tomyrese/DATN/KLTN_DeCuong_NguyenPhuQuy_LeMinhNgoc.pptx

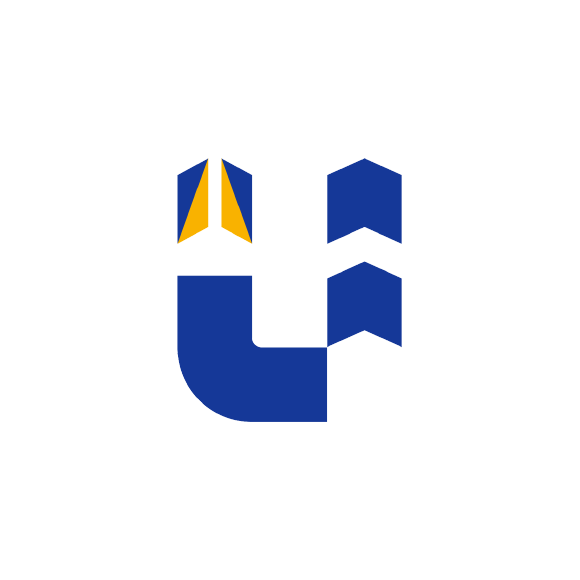
[picture p1: figure]
Nhận diện thương hiệu - Đại học Công nghiệp Thành phố Hồ Chí Minh - IUH

BẢO VỆ ĐỀ CƯƠNG

ĐỀ TÀI

THIẾT KẾ VÀ TRIỂN KHAI ROBOT TỰ HÀNH HỖ TRỢ GIAO NHẬN VÀ TƯƠNG TÁC KHÁCH HÀNG TẠI CÁC TRUNG TÂM THƯƠNG MẠI TRÊN NỀN TẢNG RASPBERRY PI

Giảng viên hướng dẫn: ThS. Lê Lý Quyên Quyên

Sinh viên thực hiện 1: Nguyễn Phú Quý MSSV: 22659651

Sinh viên thực hiện 2: Lê Minh Ngọc MSSV: 22652411

1/11

## Slide 2

TỔNG QUAN ĐỀ TÀI

ĐẶT VẤN ĐỀ & TÍNH CẤP THIẾT CỦA ĐỀ TÀI

BỐI CẢNH

Nhu cầu giao nhận

Mặt sàn rộng lớn

Hỗ trợ tìm đường

THÁCH THỨC

Tốn kém nhân lực

Nguy cơ nhầm lẫn

Hỗ trợ bị động

GIẢI PHÁP

Robot 4 bánh Mecanun

Bo mạch tích hợp

Điều khiển qua Web

Trợ lý AI

2/11

## Slide 3

TỔNG QUAN ĐỀ TÀI

MỤC TIÊU VÀ PHẠM VI NGHIÊN CỨU

MỤC TIÊU CỐT LÕI

Thiết kế phần cứng

Điều khiển tự hành

Hệ thống Web điều khiển

Trợ lý AI

Không gian hoạt động

PHẠM VI VÀ GIỚI HẠN

Tải trọng chuyên chở

Truyền thông không dây

Thời lượng Pin

3/11

## Slide 4

GIAO NHẬN HÀNG HÓA NỘI BỘ

KỊCH BẢN VẬN HÀNH & TƯƠNG TÁC TẠI TRUNG TÂM THƯƠNG MẠI

VẬN CHUYỂN

TẠO ĐƠN

NẠP HÀNG

NHẬN HÀNG

DI CHUYỂN

4/11

## Slide 5

HỖ TRỢ KHÁCH HÀNG & AI

KỊCH BẢN VẬN HÀNH & TƯƠNG TÁC TẠI TRUNG TÂM THƯƠNG MẠI

QUÉT MÃ QR TƯƠNG TÁC

HỎI ĐÁP THÔNG MINH

DẪN ĐƯỜNG TRỰC TIẾP

5/11

## Slide 6

PHẦN CỨNG HỆ THỐNG

THIẾT KẾ PHẦN CỨNG - CÁC LINH KIỆN CỐT LÕI

Raspberry Pi 4 Model B (8GB)
Cấu hình: CPU 4 nhân Cortex, 8GB RAM
Kết nối: Wi-Fi kép, CSI & 40 chân GPIO

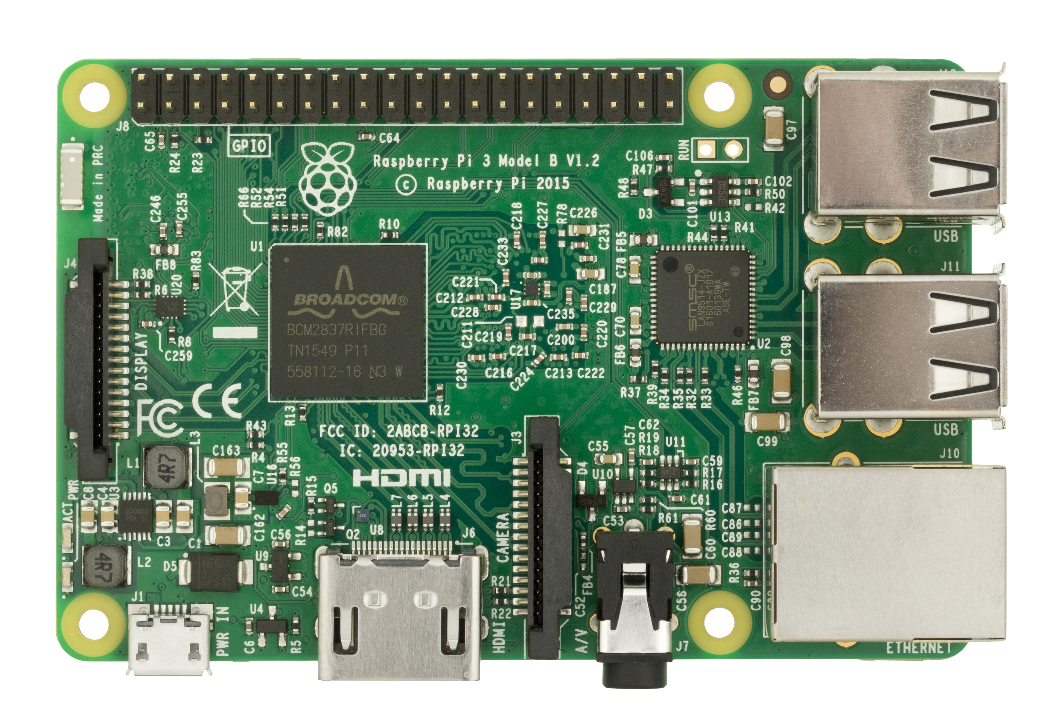
[picture p2: figure]

Driver Động Cơ TB6612FNG
Công nghệ: MOSFET kép tải 1.2A/kênh
Điều khiển: 4 kênh xung PWM điều tốc xe

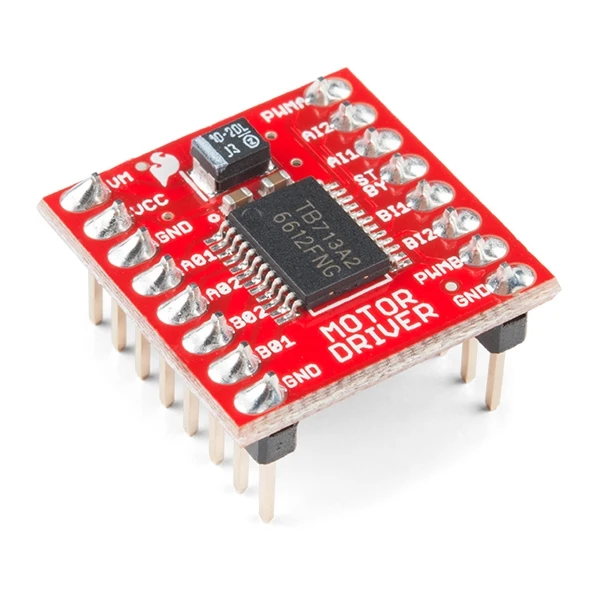
[picture p3: figure]

Khối Nguồn Năng Lượng
Pin Li-ion 12V: Cấp nguồn động lực xe
Hạ áp 5V-5A: Nuôi Pi 4 & tải, chung mass

Màn Hình OLED 1.3" I²C
Chuẩn I²C: Giao tiếp 2 dây gọn gàng
Hiển thị: Báo IP mạng, pin & mã QR

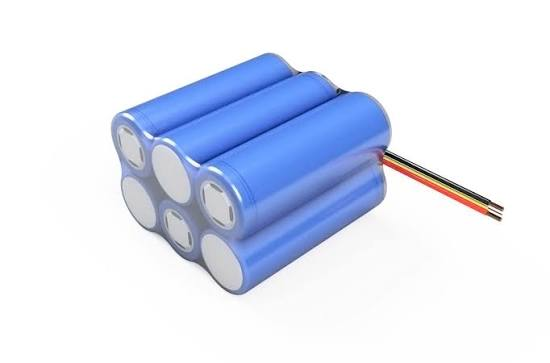
[picture p4: figure]
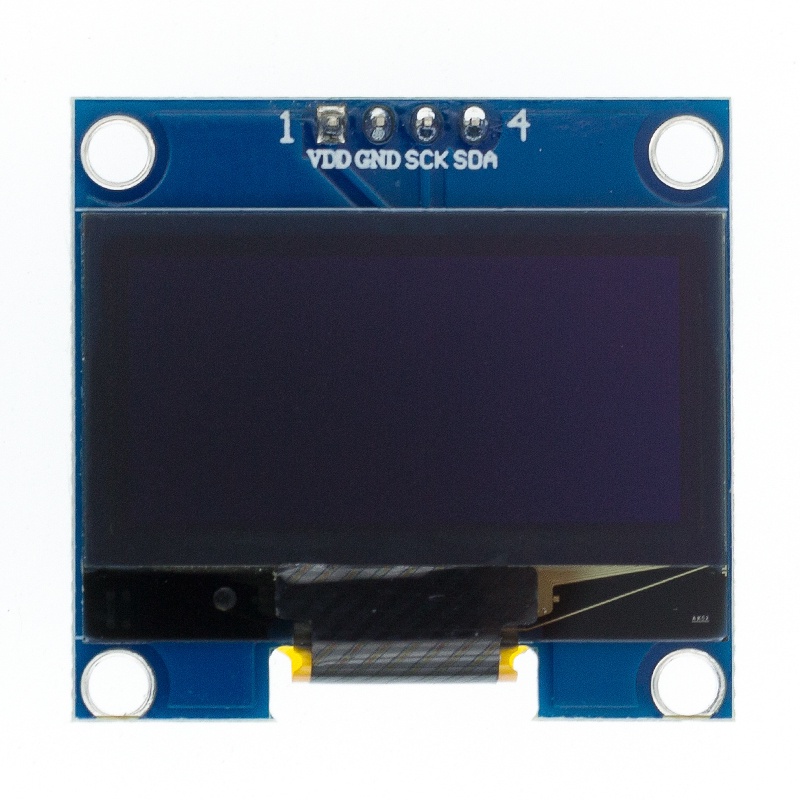
[picture p5: figure]

Cảm Biến Siêu Âm HC-SR04
Cự ly đo: 2cm - 400cm quét né vật cản
Phân áp 3.3V: Trở 1k/2k bảo vệ GPIO

Camera Quan Sát CSI OV5647
Ống kính 5MP: Góc nhìn 72.4° sắc nét
Chuẩn CSI: Cáp bẹ cắm trực tiếp Pi 4

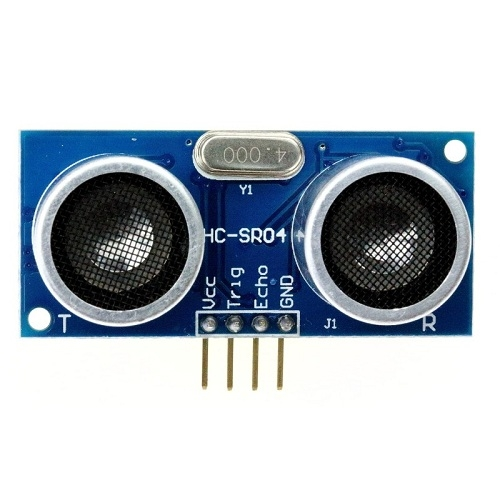
[picture p6: figure]
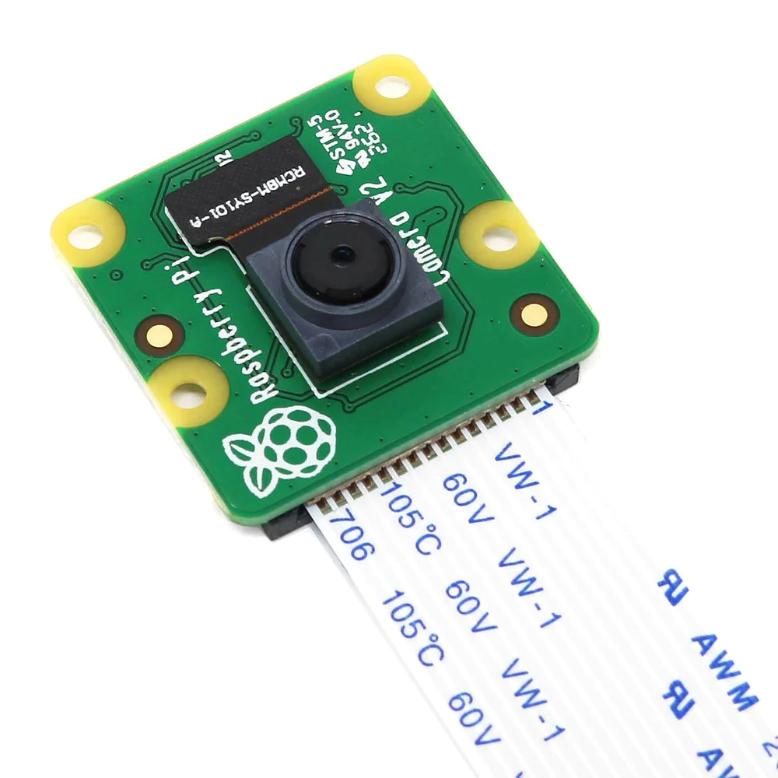
[picture p7: figure]

6/11

## Slide 7

KẾT QUẢ TRIỂN KHAI

KẾT QUẢ ĐÃ ĐẠT ĐƯỢC (ĐẾN THỜI ĐIỂM HIỆN TẠI)

1. PHẦN CỨNG MẠCH
Sơ đồ mạch điện: Hoàn thành bản vẽ KiCad.
Bo mạch 1 lớp: Đi dây toàn bộ mặt, tối ưu.
Bản vẽ chế tạo: Bộ PDF tỷ lệ 1:1 sẵn sàng gia công thực tế.

2. PHẦN MỀM ĐIỀU KHIỂN
Điều khiển động cơ: Lập trình chạy mượt các lệnh tiến, lùi, quay vòng, phanh dừng.
Chế độ mô phỏng: Chạy thử thuật toán trên máy tính mà không cần xe thật.
Kịch bản kiểm tra: Kiểm thử toàn diện chuyển động của xe.

3. HỆ THỐNG WEBSITE
Máy chủ điều khiển: Chạy trực tiếp trên Raspberry Pi 4, kết nối Wi-Fi.
Giao diện Web: Thiết kế hiện đại, điều khiển trên laptop và điện thoại.
Đầy đủ tính năng: Nút bấm lái xe, thanh trượt tốc độ và chế độ tự động kiểm tra.

7/11

## Slide 8

PHẦN CỨNG HỆ THỐNG

SƠ ĐỒ NGUYÊN LÝ TOÀN MẠCH

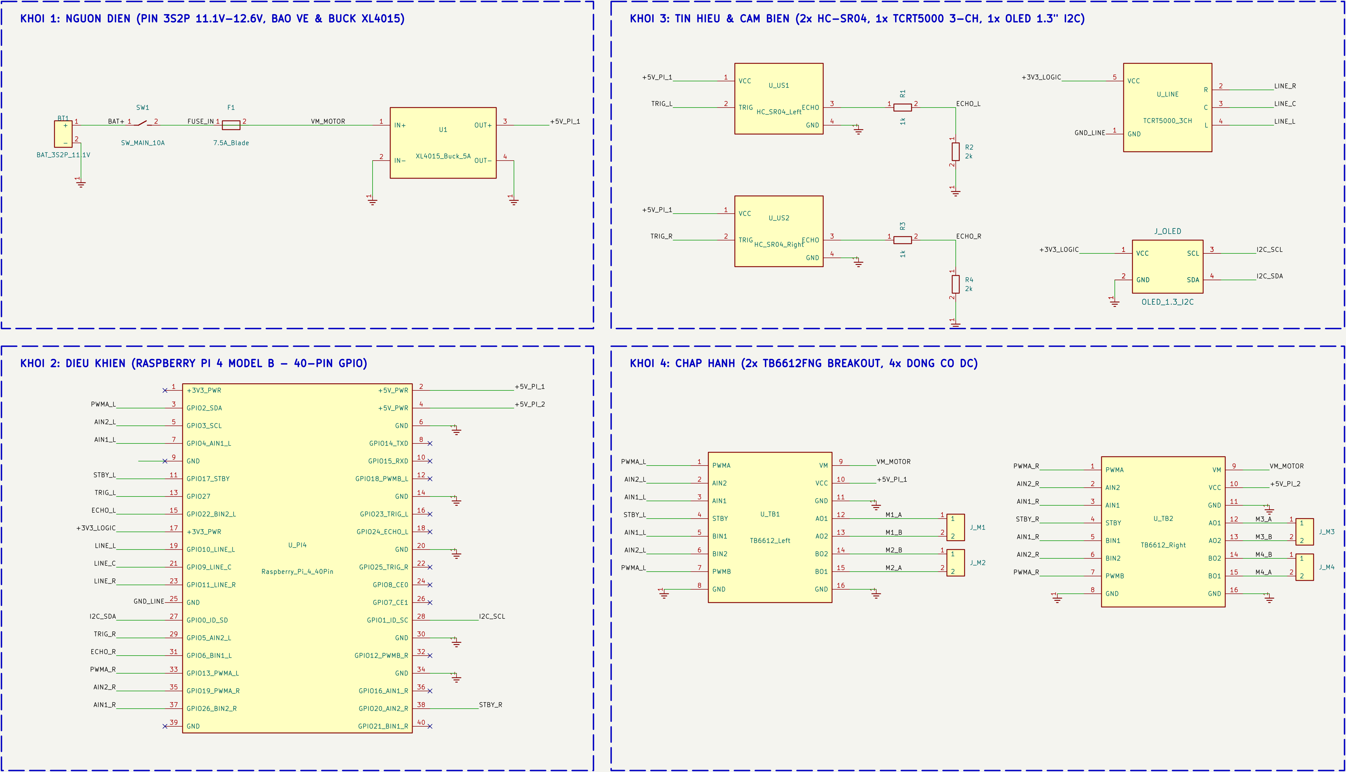
[picture p8: figure]

8/11

## Slide 9

PHẦN MỀM ĐIỀU KHIỂN

GIAO DIỆN WEB DASHBOARD

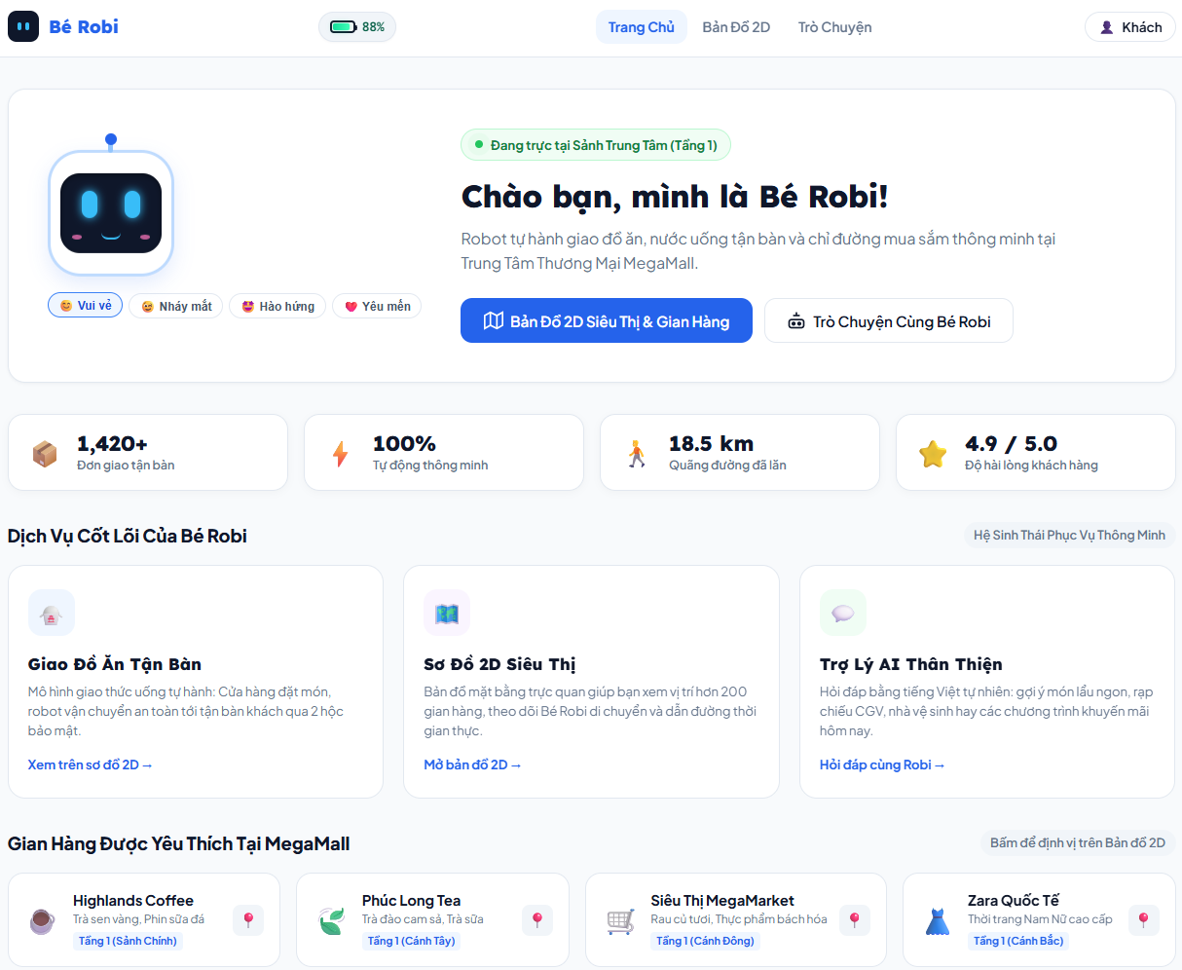
[picture p9: figure]
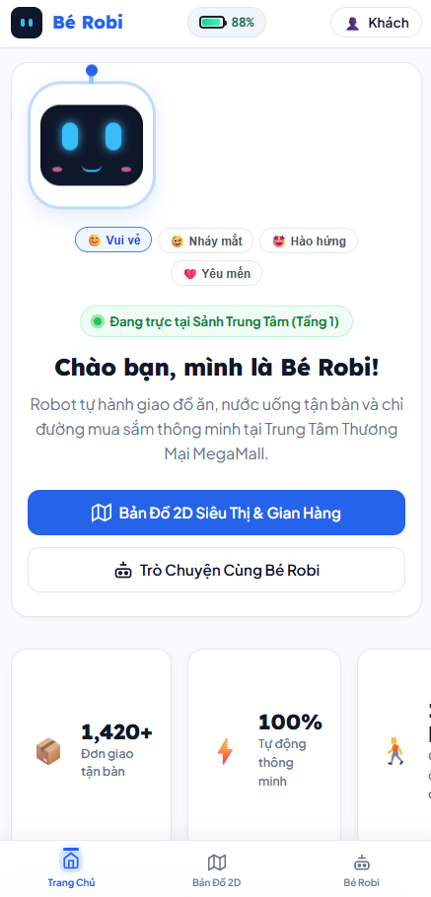
[picture p10: figure]

9/11

## Slide 10

LỘ TRÌNH TIẾP THEO

KẾT QUẢ THỰC HIỆN

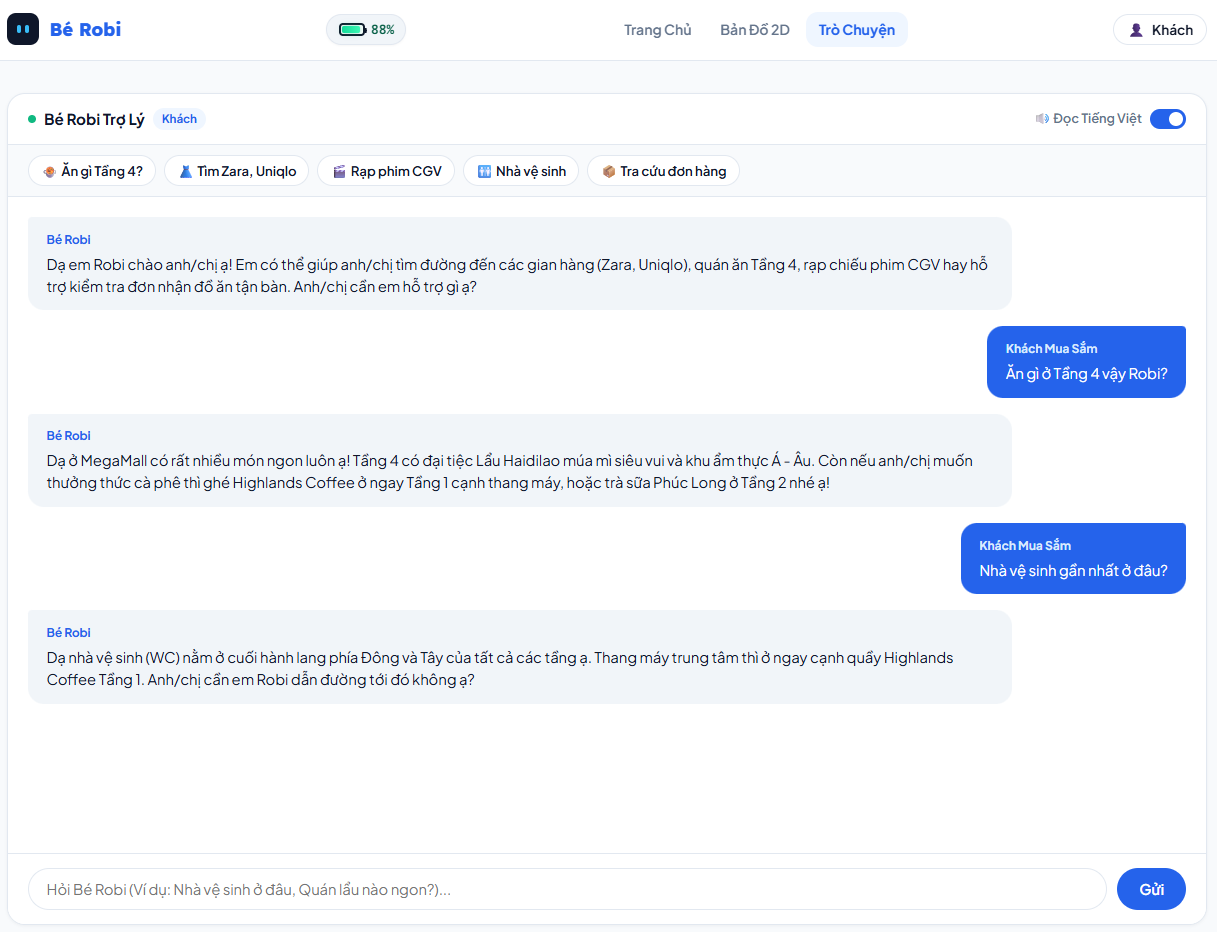
[picture p11: figure]
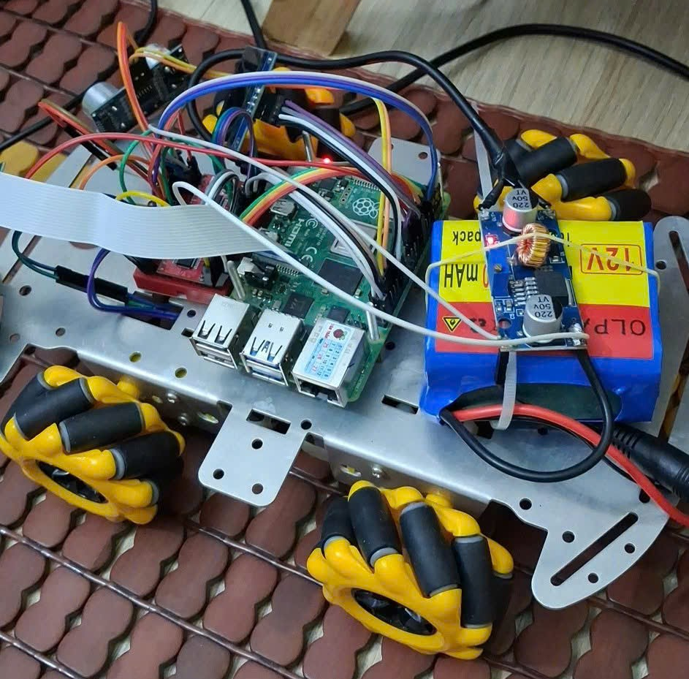
[picture p12: figure]

10/11

## Slide 11

CẢM ƠN HỘI ĐỒNG ĐÃ LẮNG NGHE!

Sinh viên 1: Nguyễn Phú Quý (MSSV: 22659651) • Sinh viên 2: Lê Minh Ngọc (MSSV: 22652411)

11/11
