tomyrese/DATN/extracted_imgs/block1_power_clean.png

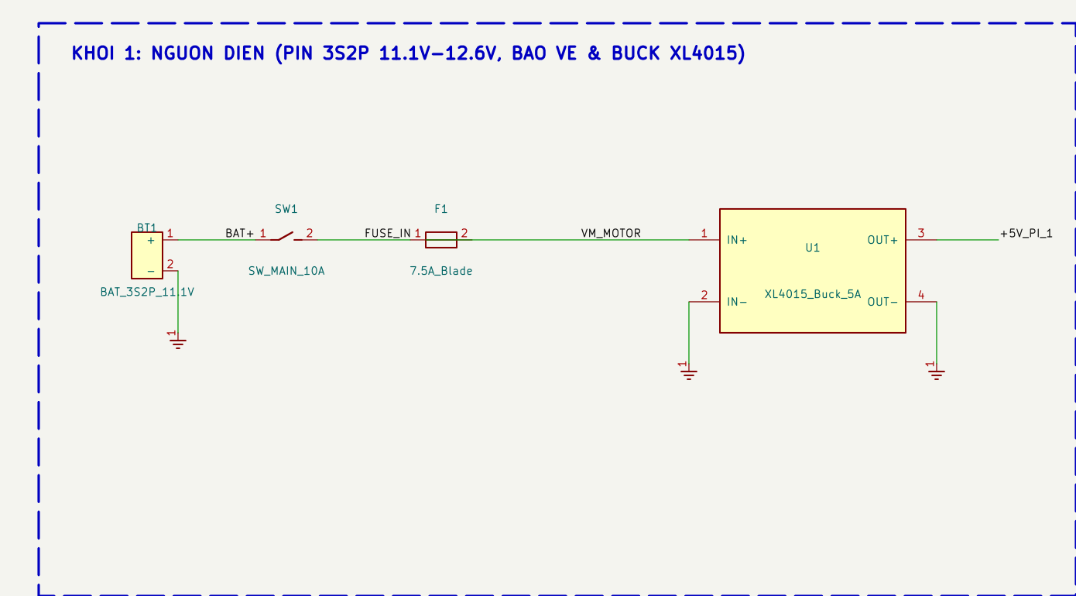
extracted_imgs/block1_power_clean.png
