tomyrese/DATN/extracted_imgs/block2_control_clean.png

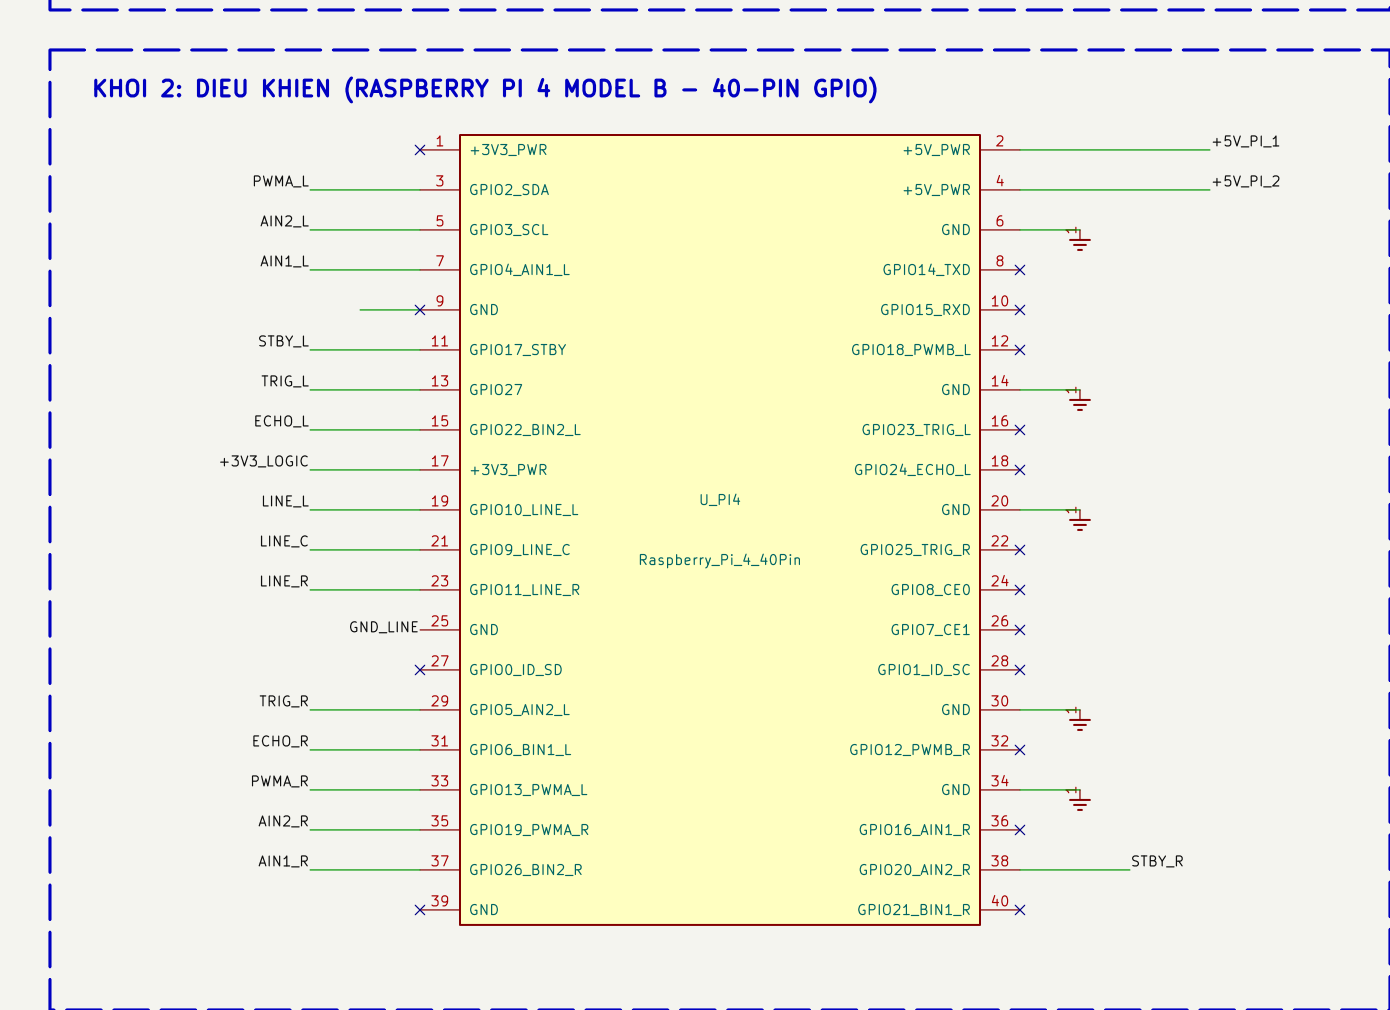
extracted_imgs/block2_control_clean.png
