tomyrese/DATN/extracted_imgs/block3_signal_clean.png

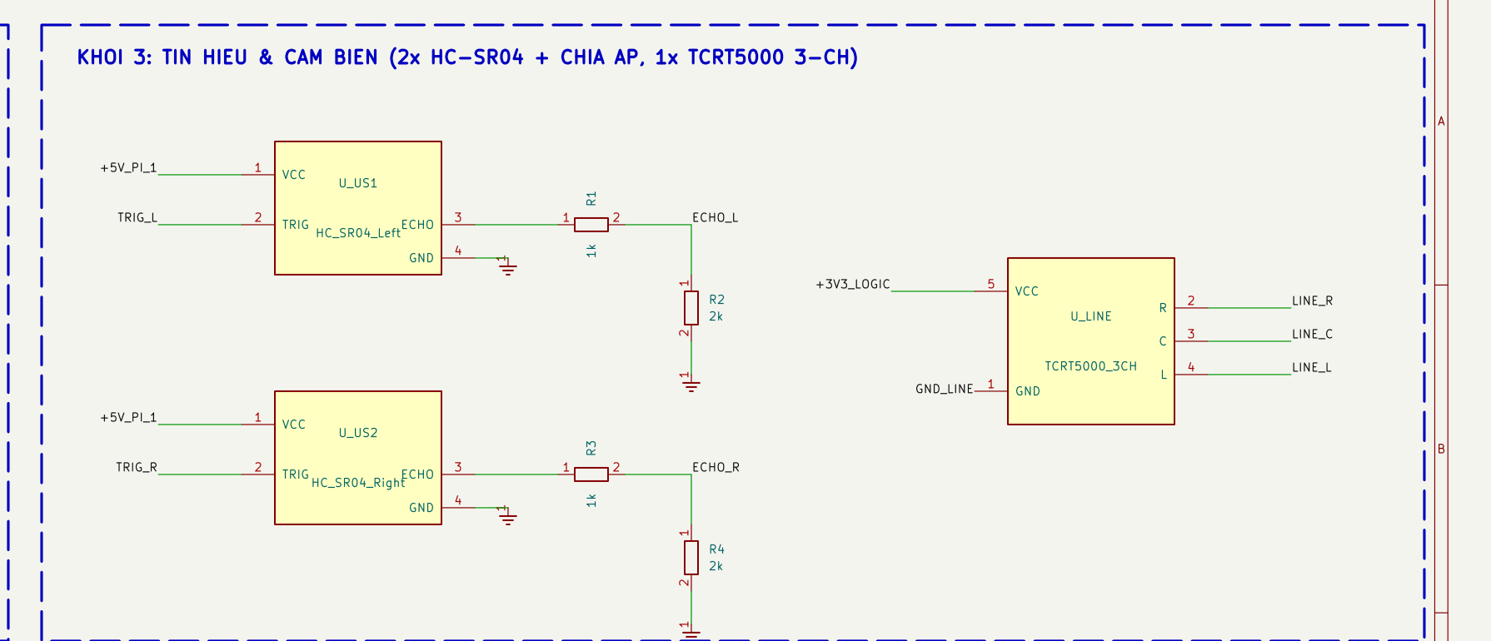
extracted_imgs/block3_signal_clean.png
