tomyrese/DATN/extracted_imgs/block4_actuators_clean.png

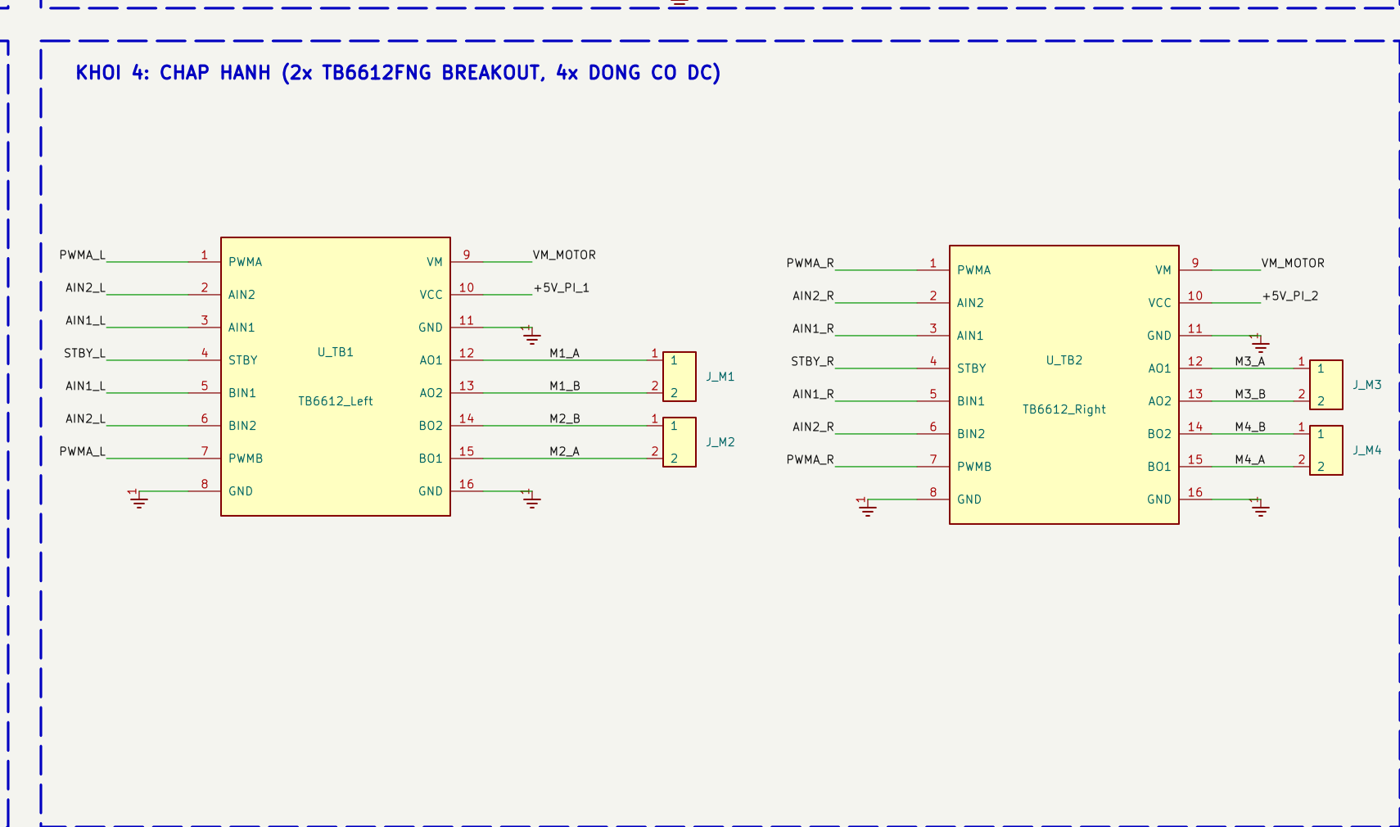
extracted_imgs/block4_actuators_clean.png
