tomyrese/DATN/extracted_imgs/block_diagrams/block_diagram_slide9_power.png

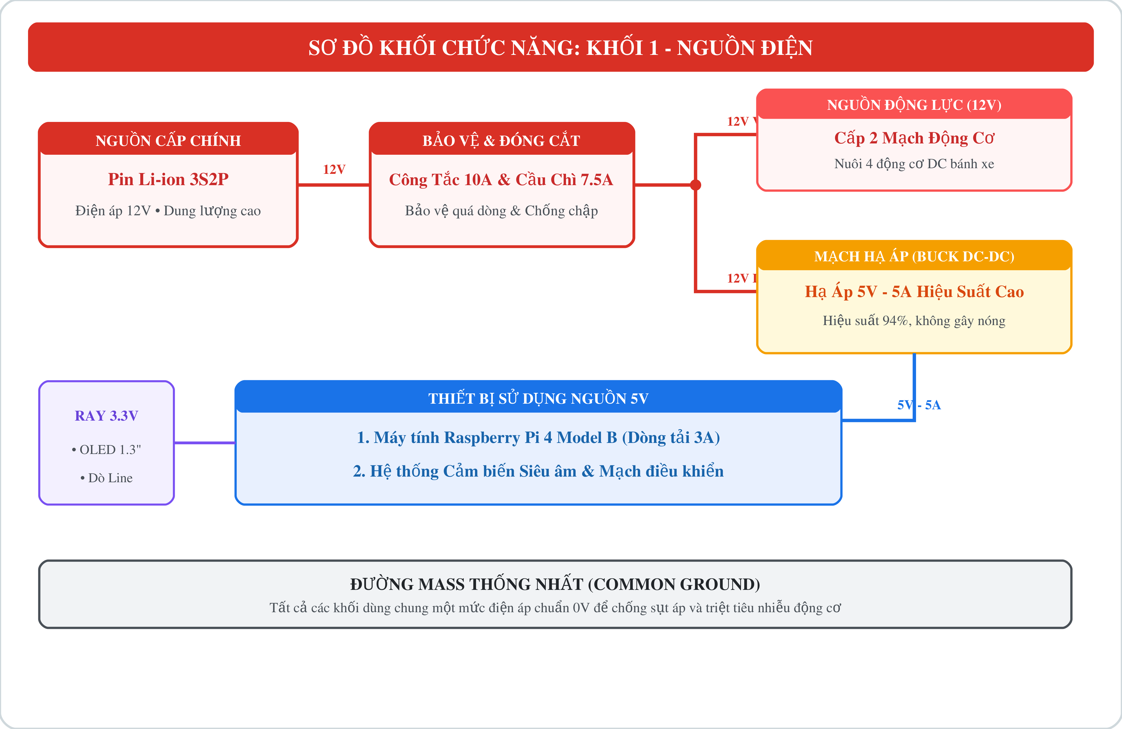
extracted_imgs/block_diagrams/block_diagram_slide9_power.png
