tomyrese/DATN/extracted_imgs/block_diagrams/block_diagram_slide10_control.png

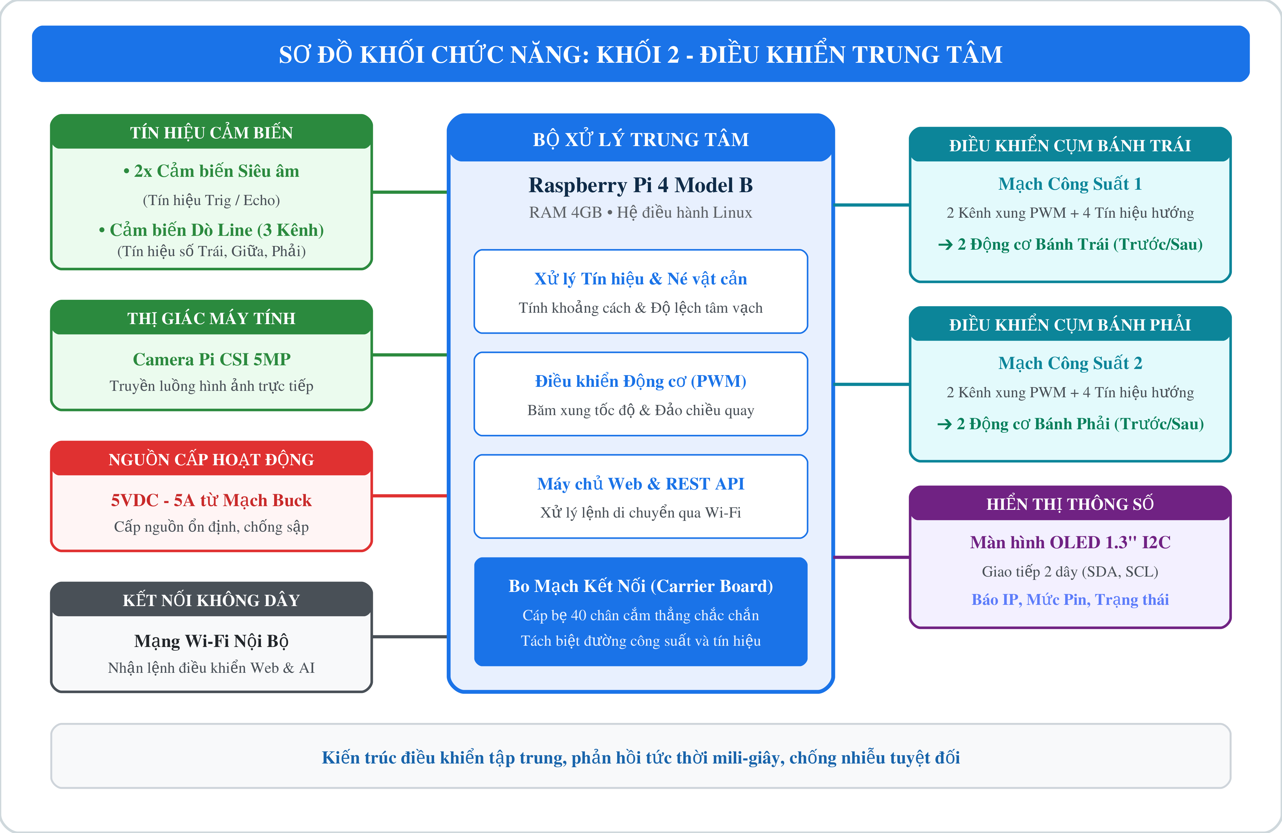
extracted_imgs/block_diagrams/block_diagram_slide10_control.png
