tomyrese/DATN/extracted_imgs/block_diagrams/block_diagram_slide11_sensor.png

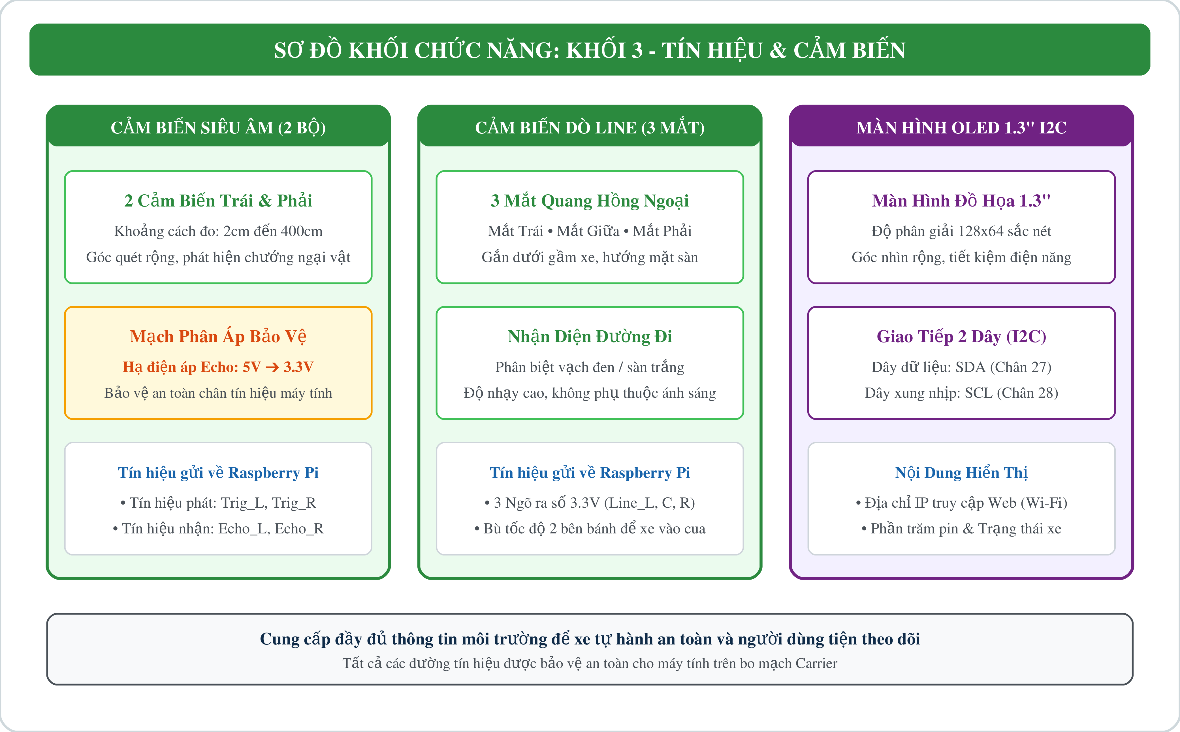
extracted_imgs/block_diagrams/block_diagram_slide11_sensor.png
