tomyrese/DATN/extracted_imgs/block_diagrams/block_diagram_slide12_motor.png

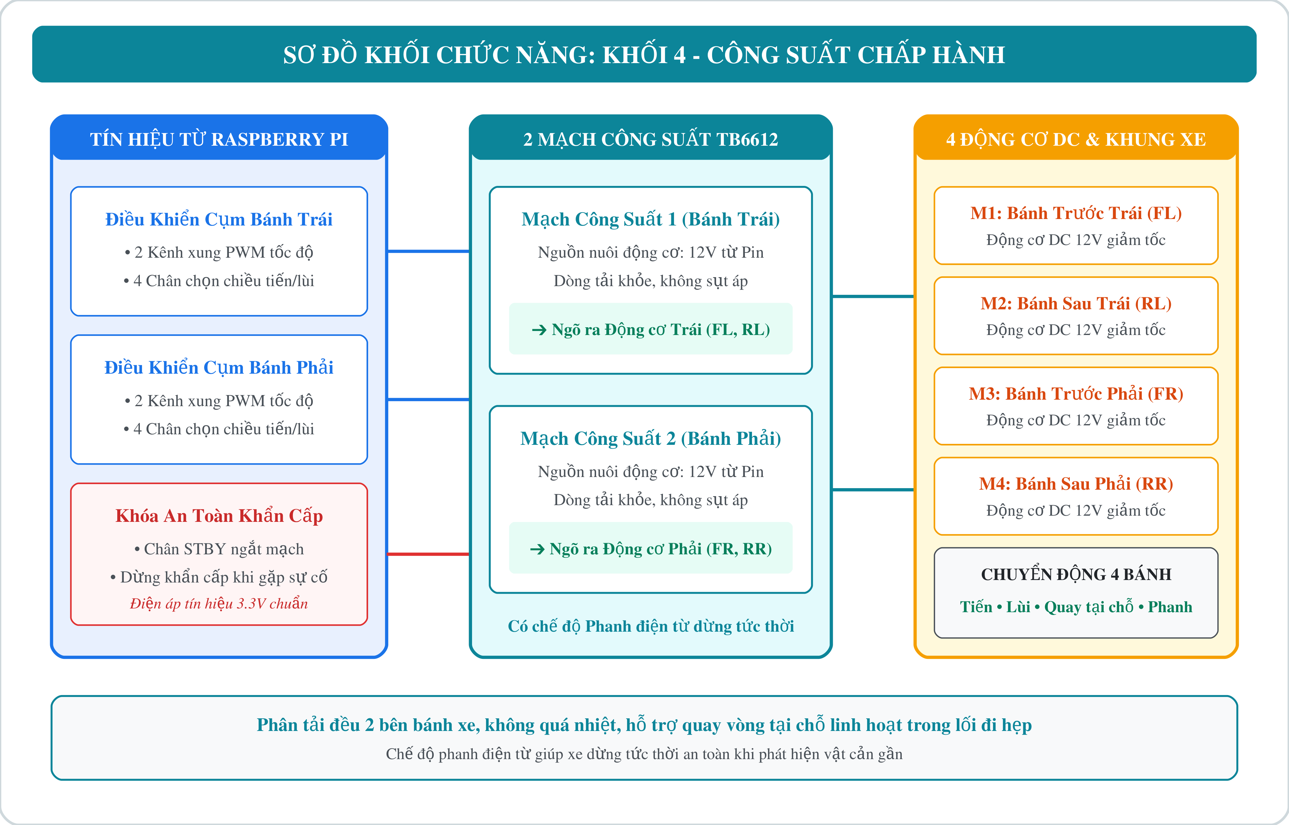
extracted_imgs/block_diagrams/block_diagram_slide12_motor.png
