tomyrese/DATN/extracted_imgs/flowcharts/flowchart_system_main.png

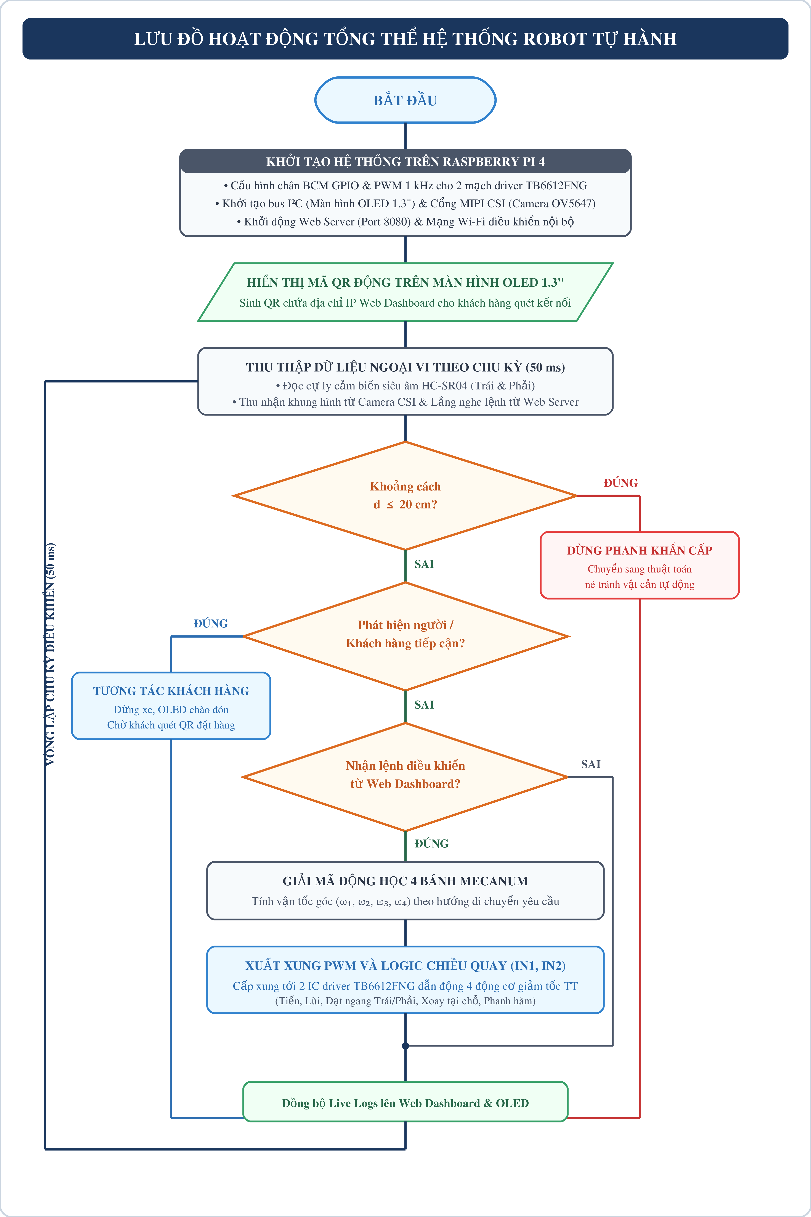
extracted_imgs/flowcharts/flowchart_system_main.png
