tomyrese/DATN/extracted_imgs/pcb_oled_zoom.png

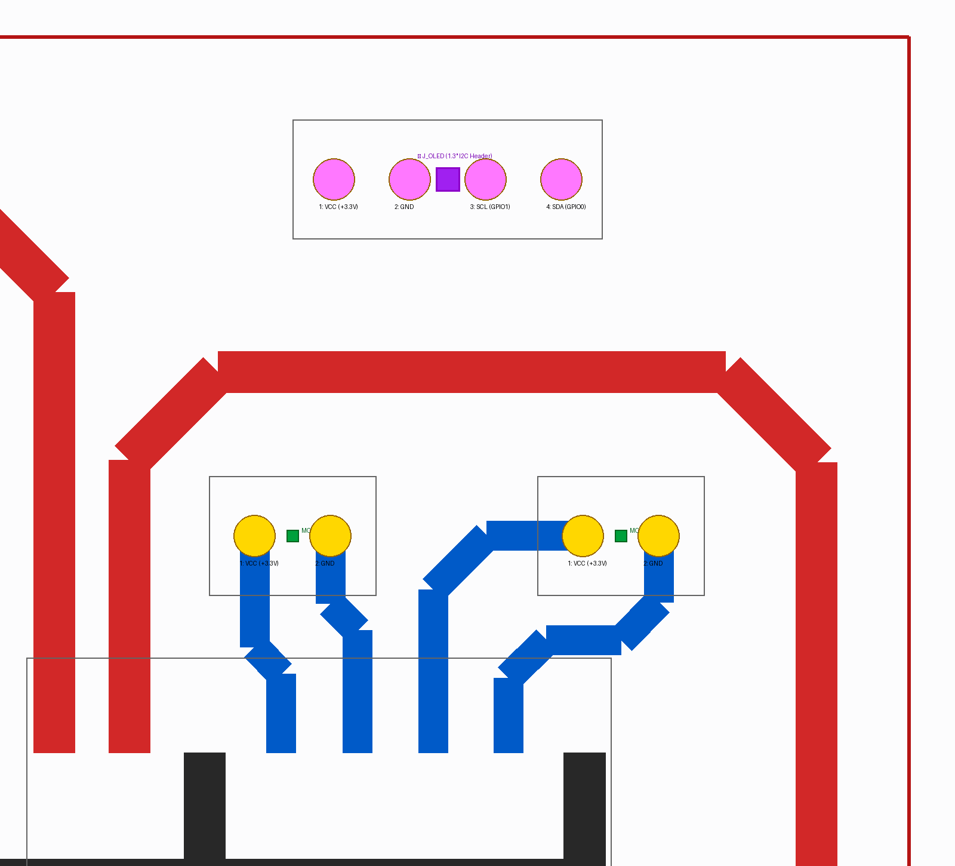
extracted_imgs/pcb_oled_zoom.png
