tomyrese/DATN/extracted_imgs/pcb_with_oled_visual.png

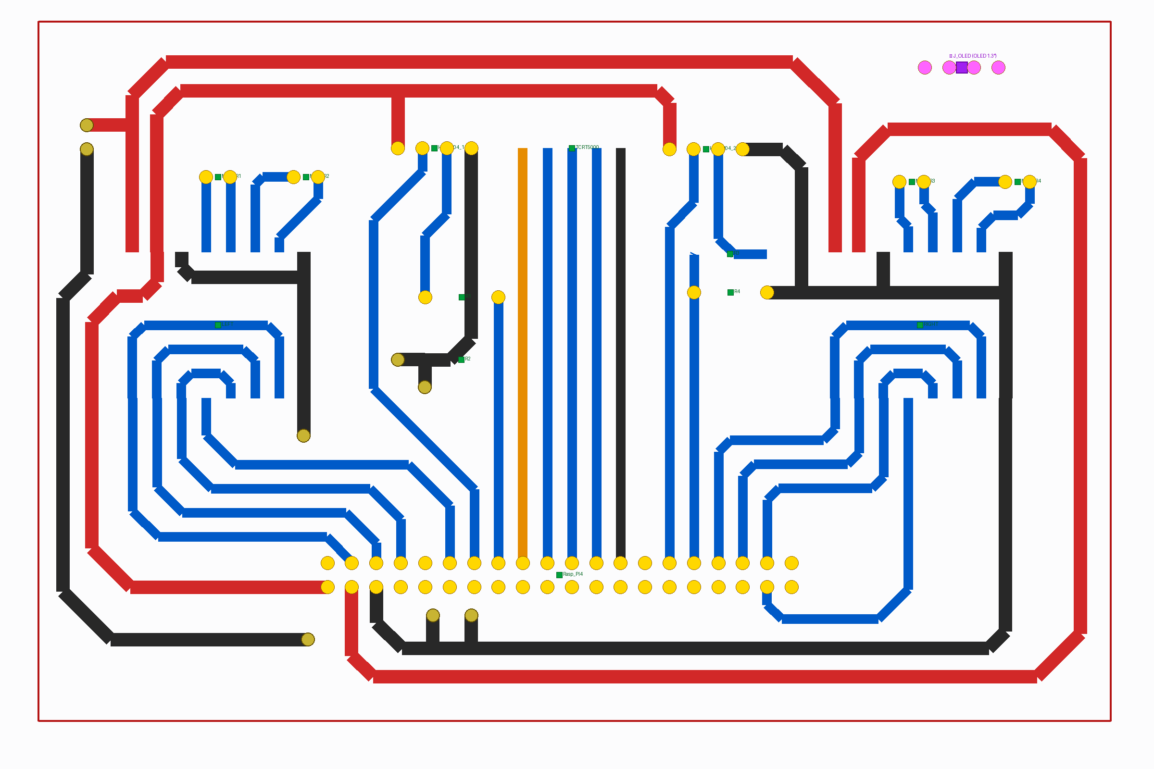
extracted_imgs/pcb_with_oled_visual.png
