tomyrese/DATN/extracted_imgs/pcb_zoom_completed.png

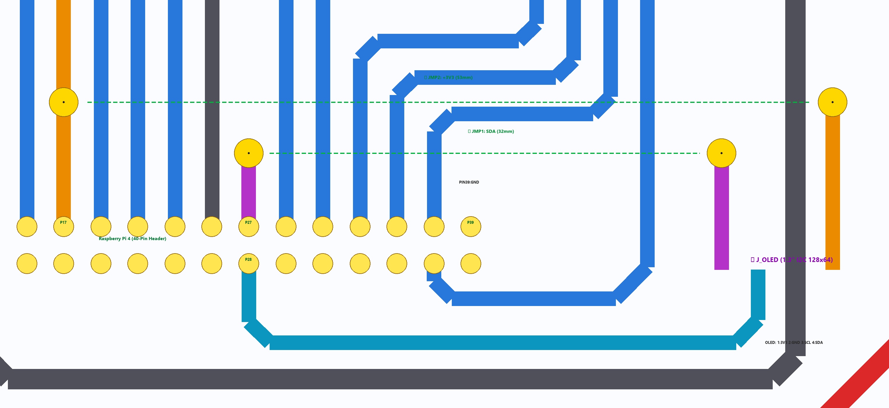
extracted_imgs/pcb_zoom_completed.png
