tomyrese/DATN/extracted_imgs/pptx_rendered_slides/Slide1.JPG

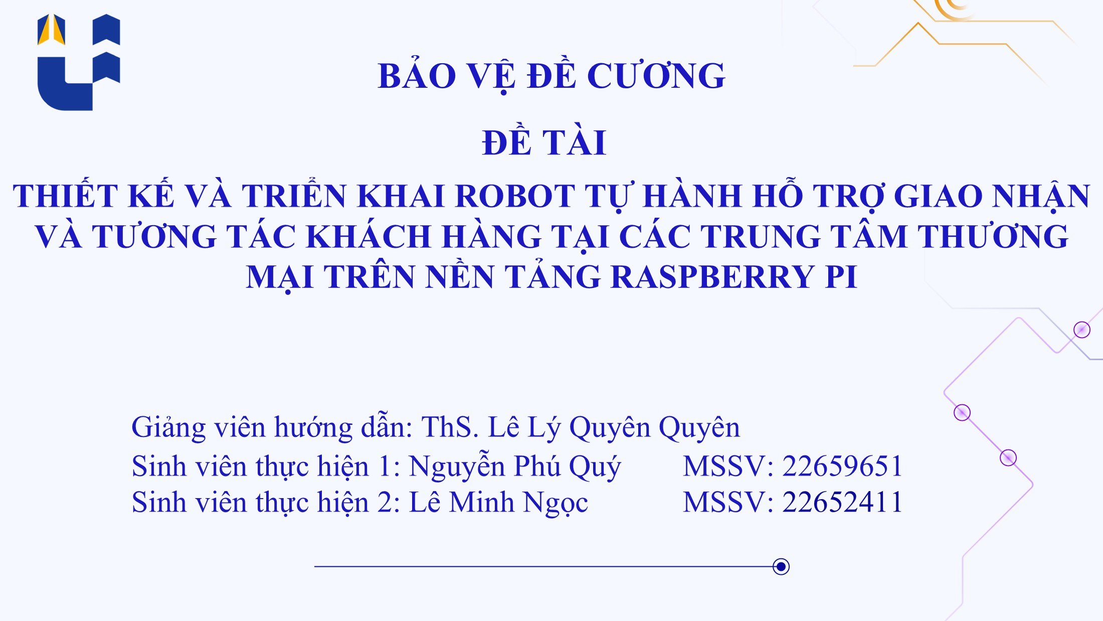
extracted_imgs/pptx_rendered_slides/Slide1.JPG
