tomyrese/DATN/extracted_imgs/pptx_rendered_slides/Slide2.JPG

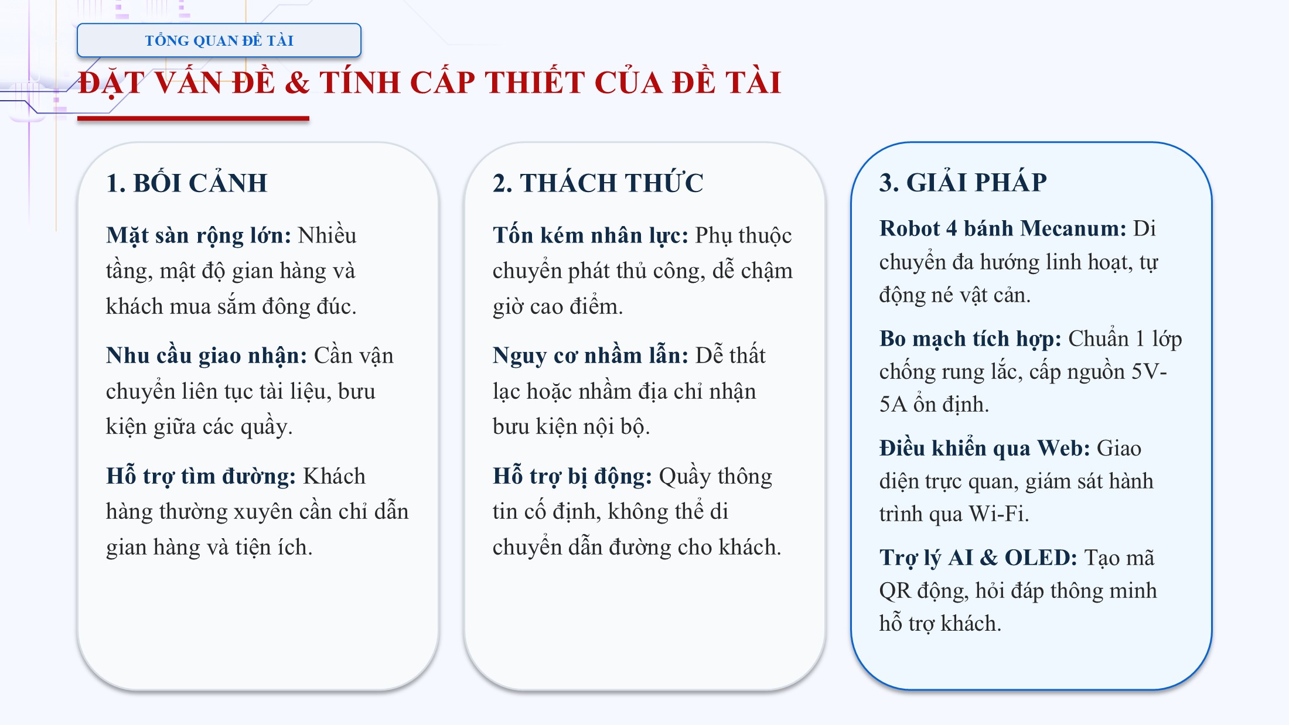
extracted_imgs/pptx_rendered_slides/Slide2.JPG
