tomyrese/DATN/extracted_imgs/pptx_rendered_slides/Slide3.JPG

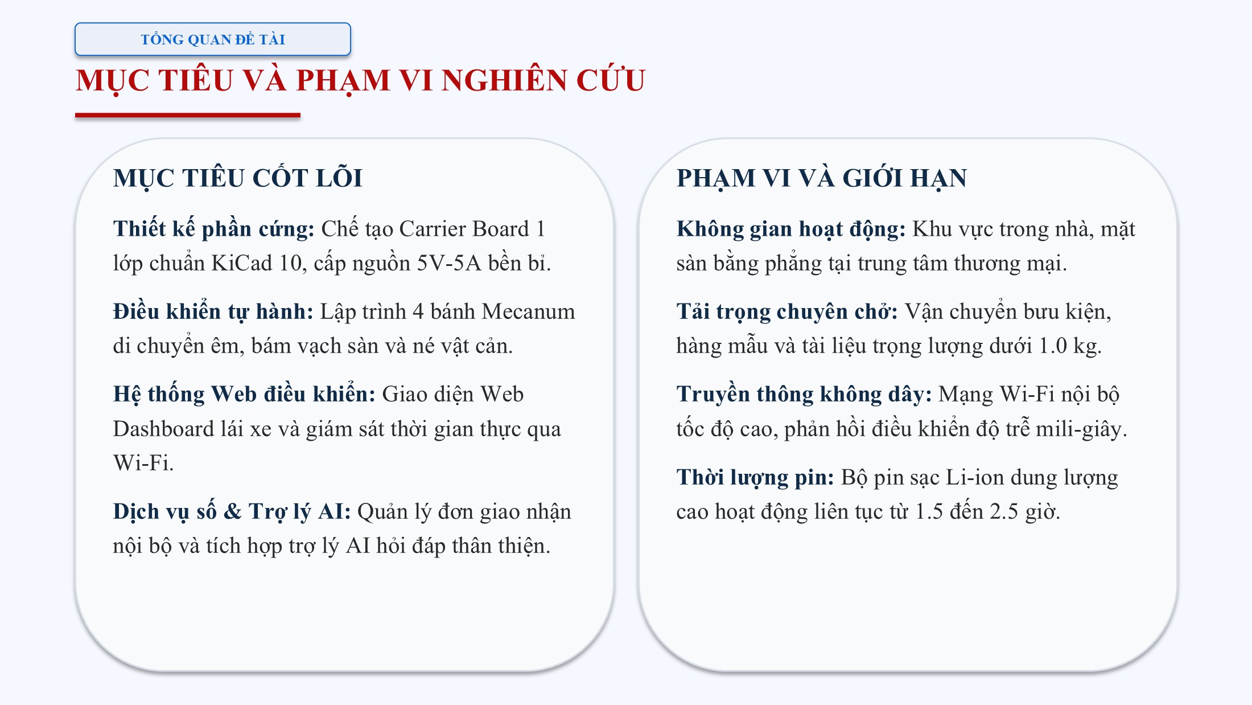
extracted_imgs/pptx_rendered_slides/Slide3.JPG
