tomyrese/DATN/extracted_imgs/pptx_rendered_slides/Slide4.JPG

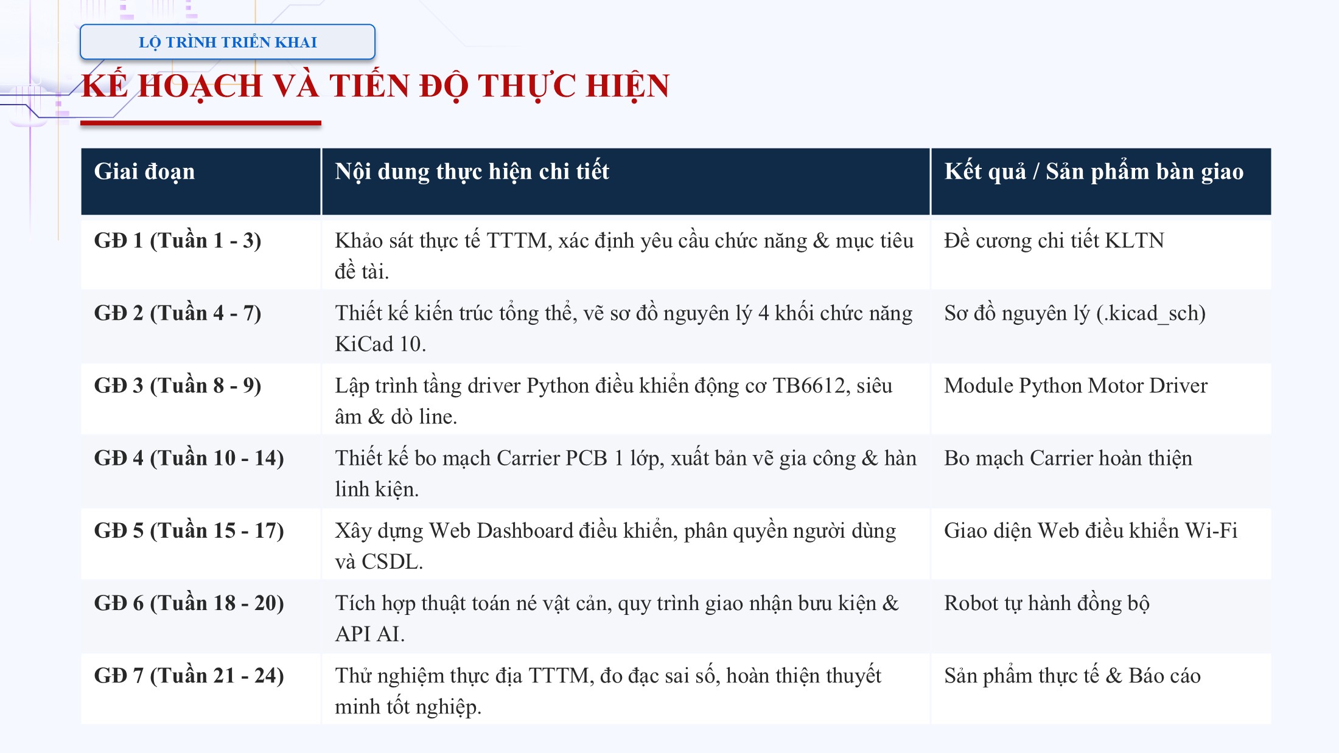
extracted_imgs/pptx_rendered_slides/Slide4.JPG
