tomyrese/DATN/extracted_imgs/pptx_rendered_slides/Slide5.JPG

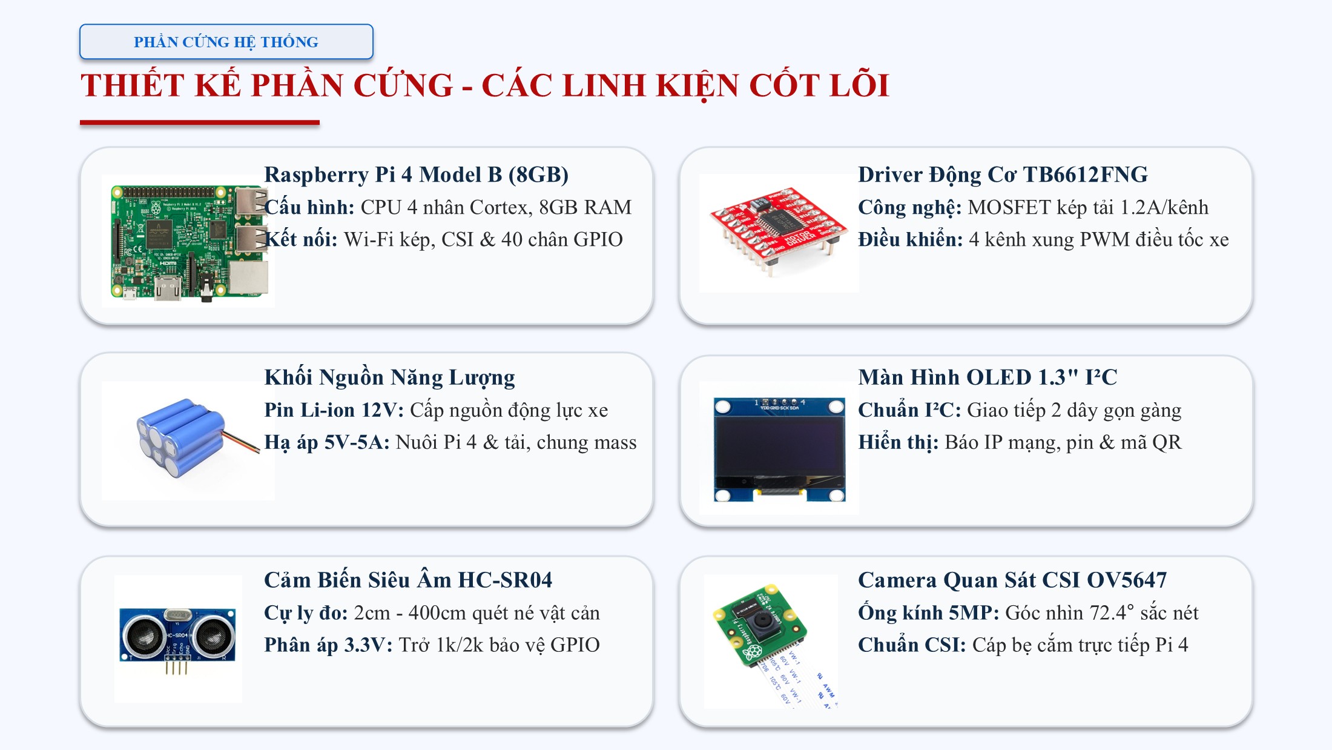
extracted_imgs/pptx_rendered_slides/Slide5.JPG
