tomyrese/DATN/extracted_imgs/pptx_rendered_slides/Slide6.JPG

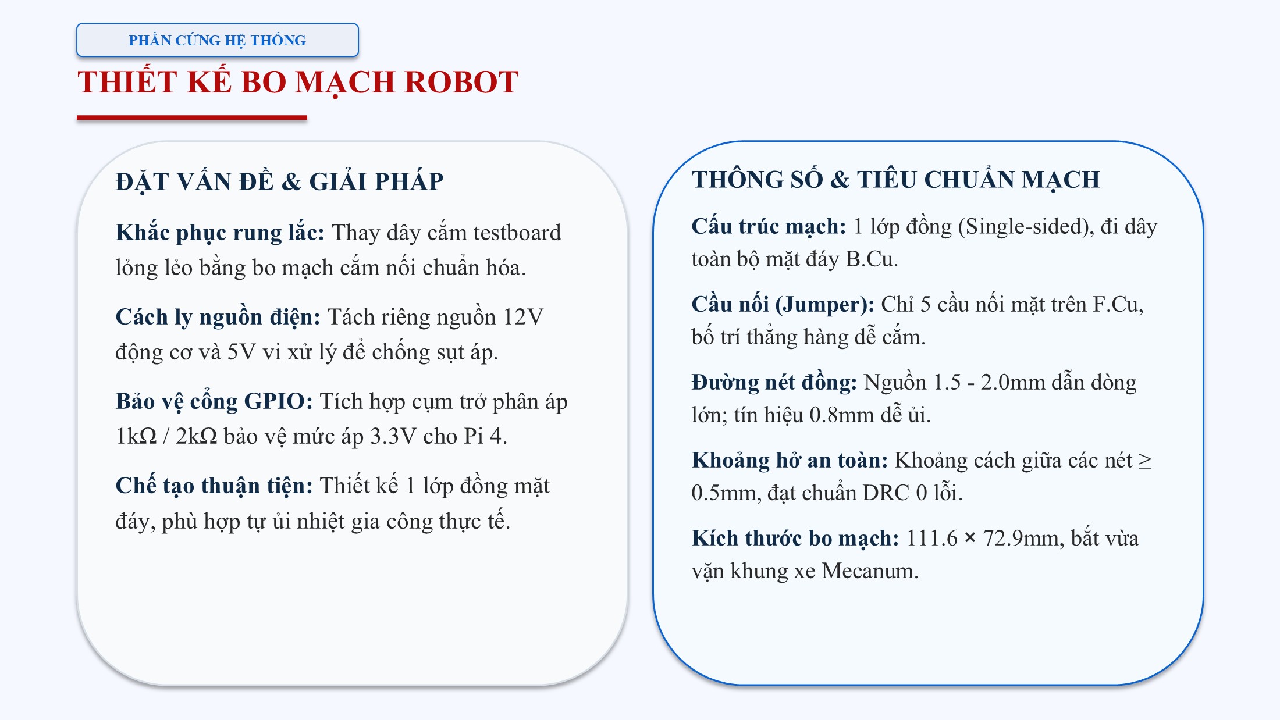
extracted_imgs/pptx_rendered_slides/Slide6.JPG
