tomyrese/DATN/extracted_imgs/pptx_rendered_slides/Slide7.JPG

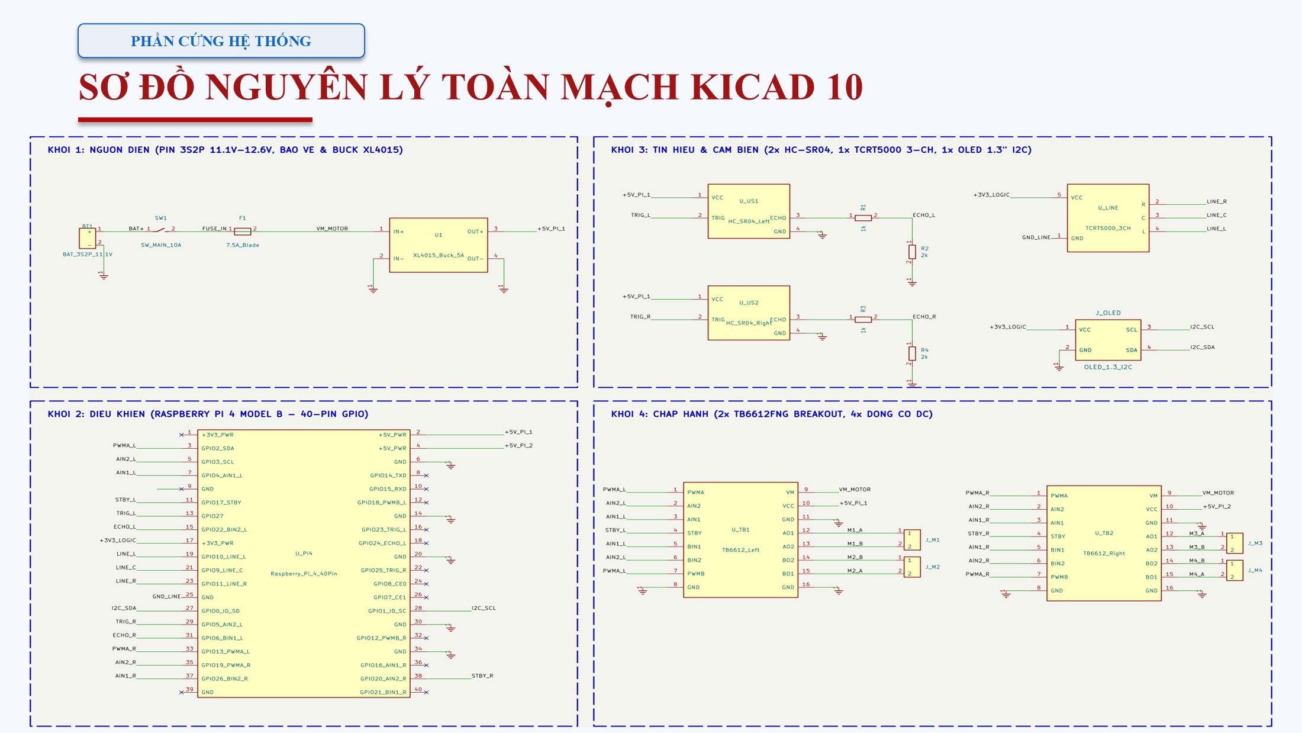
extracted_imgs/pptx_rendered_slides/Slide7.JPG
