tomyrese/DATN/extracted_imgs/pptx_rendered_slides/Slide8.JPG

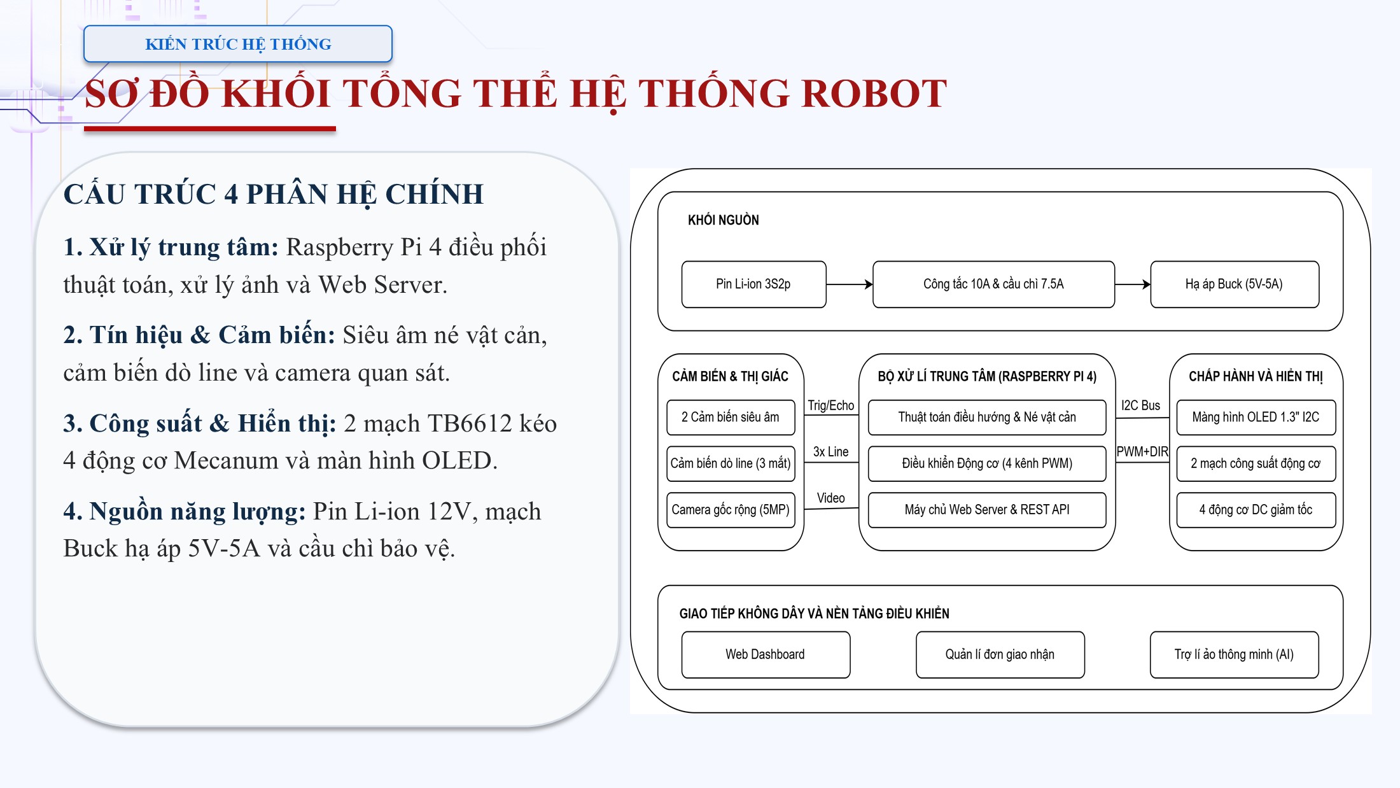
extracted_imgs/pptx_rendered_slides/Slide8.JPG
