tomyrese/DATN/extracted_imgs/pptx_rendered_slides/Slide9.JPG

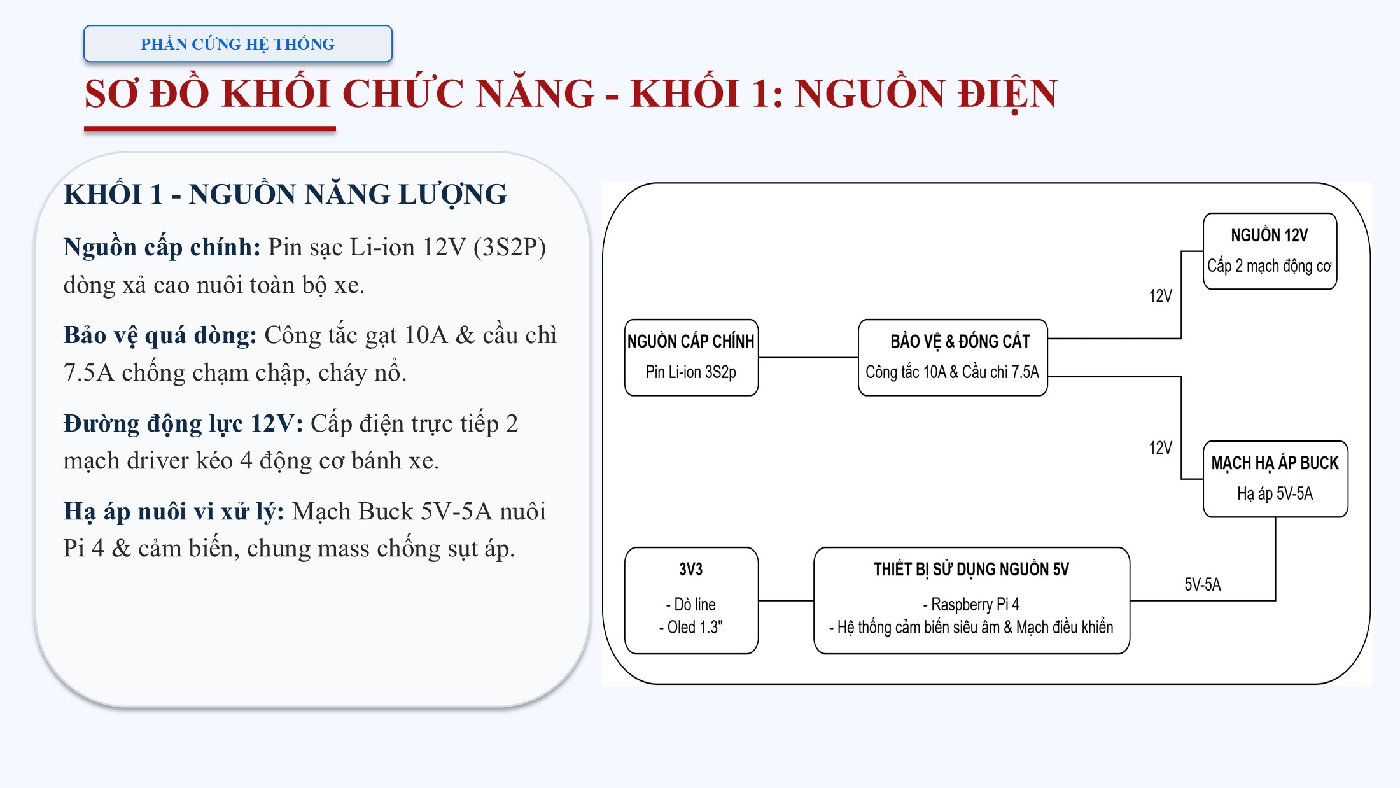
extracted_imgs/pptx_rendered_slides/Slide9.JPG
