tomyrese/DATN/extracted_imgs/pptx_rendered_slides/Slide10.JPG

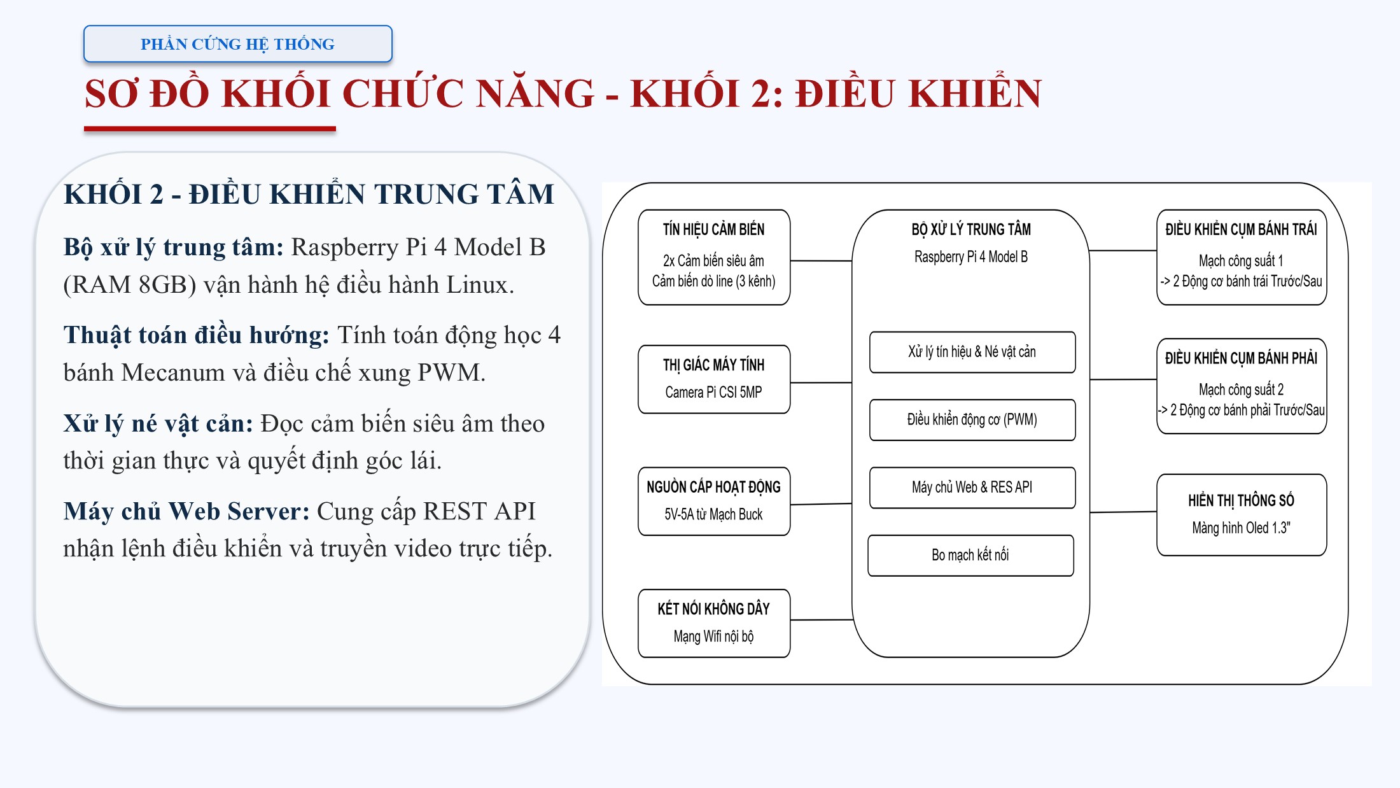
extracted_imgs/pptx_rendered_slides/Slide10.JPG
