tomyrese/DATN/extracted_imgs/pptx_rendered_slides/Slide11.JPG

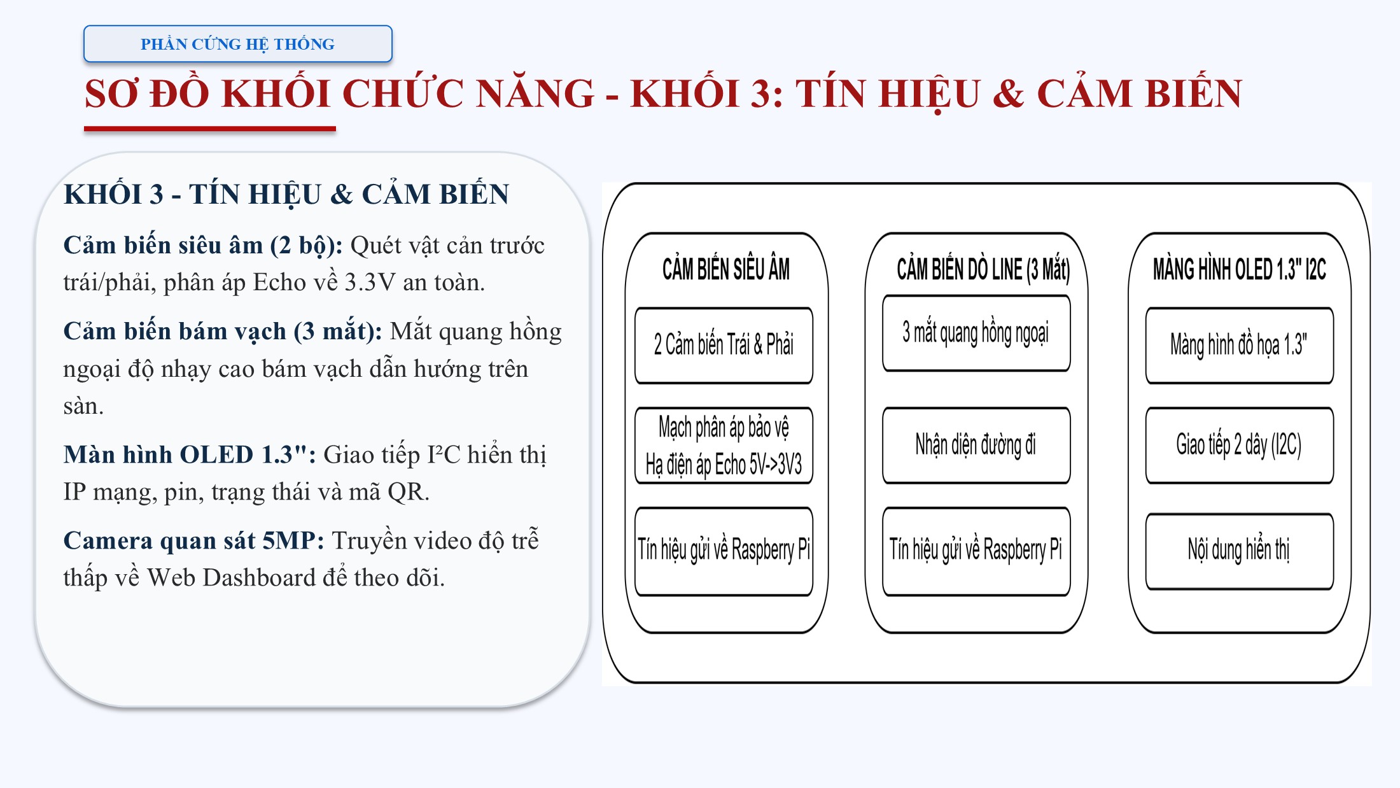
extracted_imgs/pptx_rendered_slides/Slide11.JPG
