tomyrese/DATN/extracted_imgs/pptx_rendered_slides/Slide12.JPG

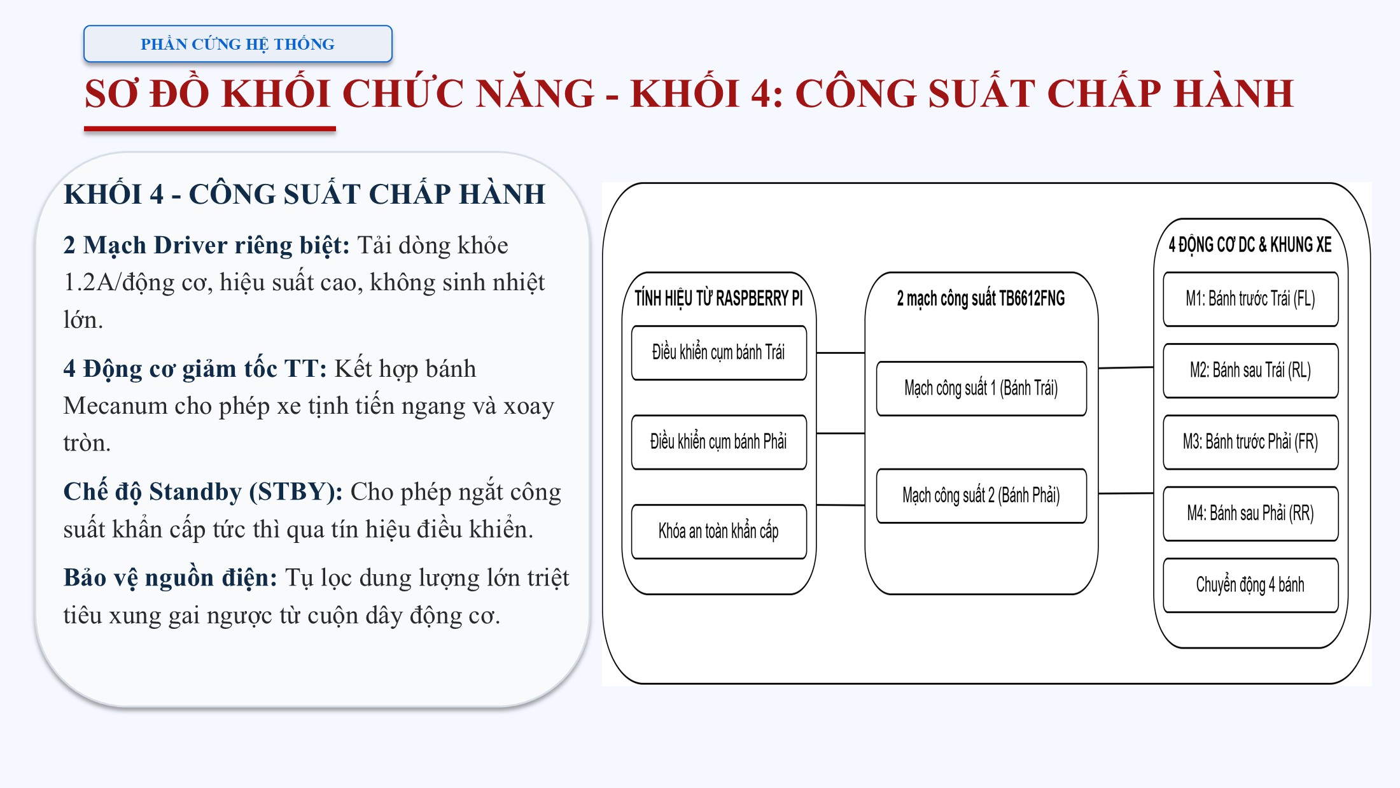
extracted_imgs/pptx_rendered_slides/Slide12.JPG
