tomyrese/DATN/extracted_imgs/pptx_rendered_slides/Slide13.JPG

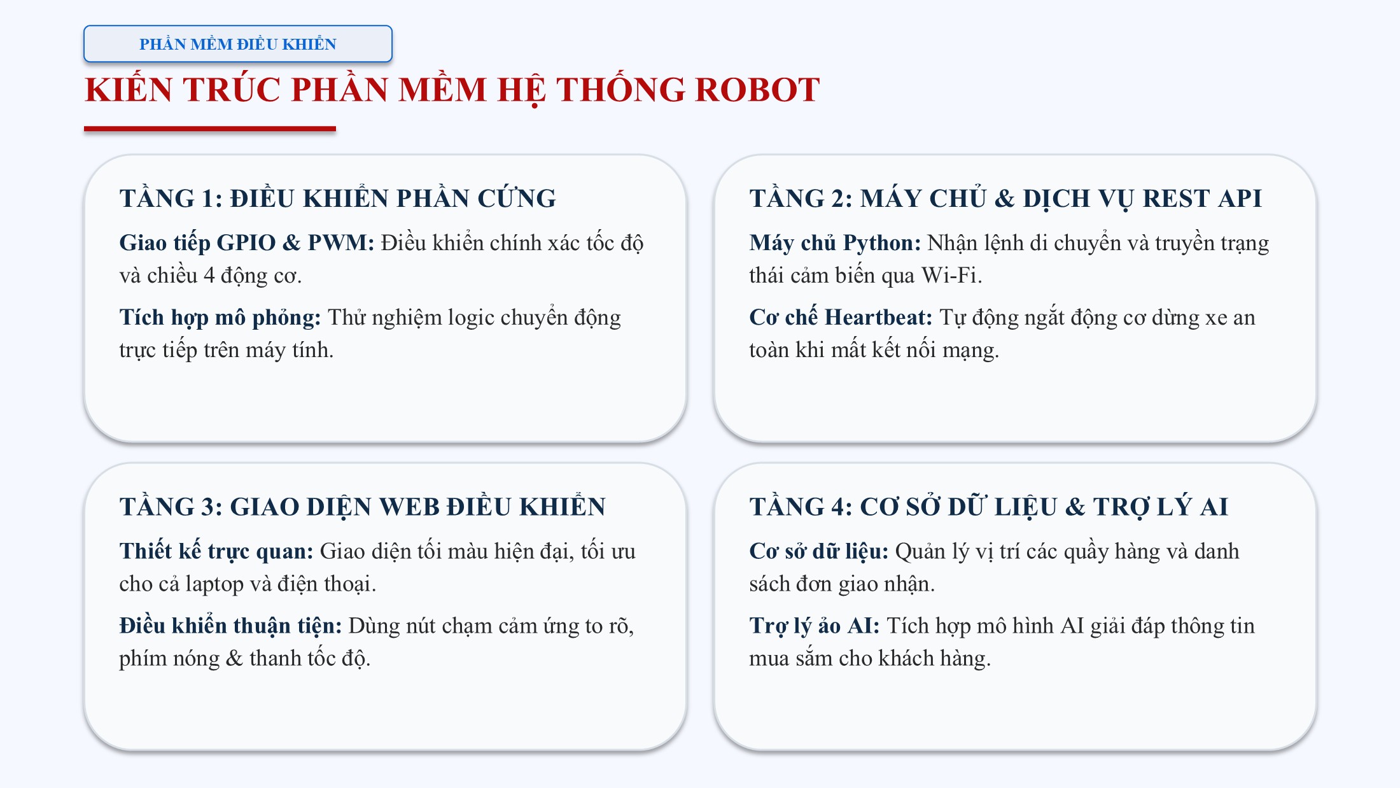
extracted_imgs/pptx_rendered_slides/Slide13.JPG
