tomyrese/DATN/extracted_imgs/pptx_rendered_slides/Slide14.JPG

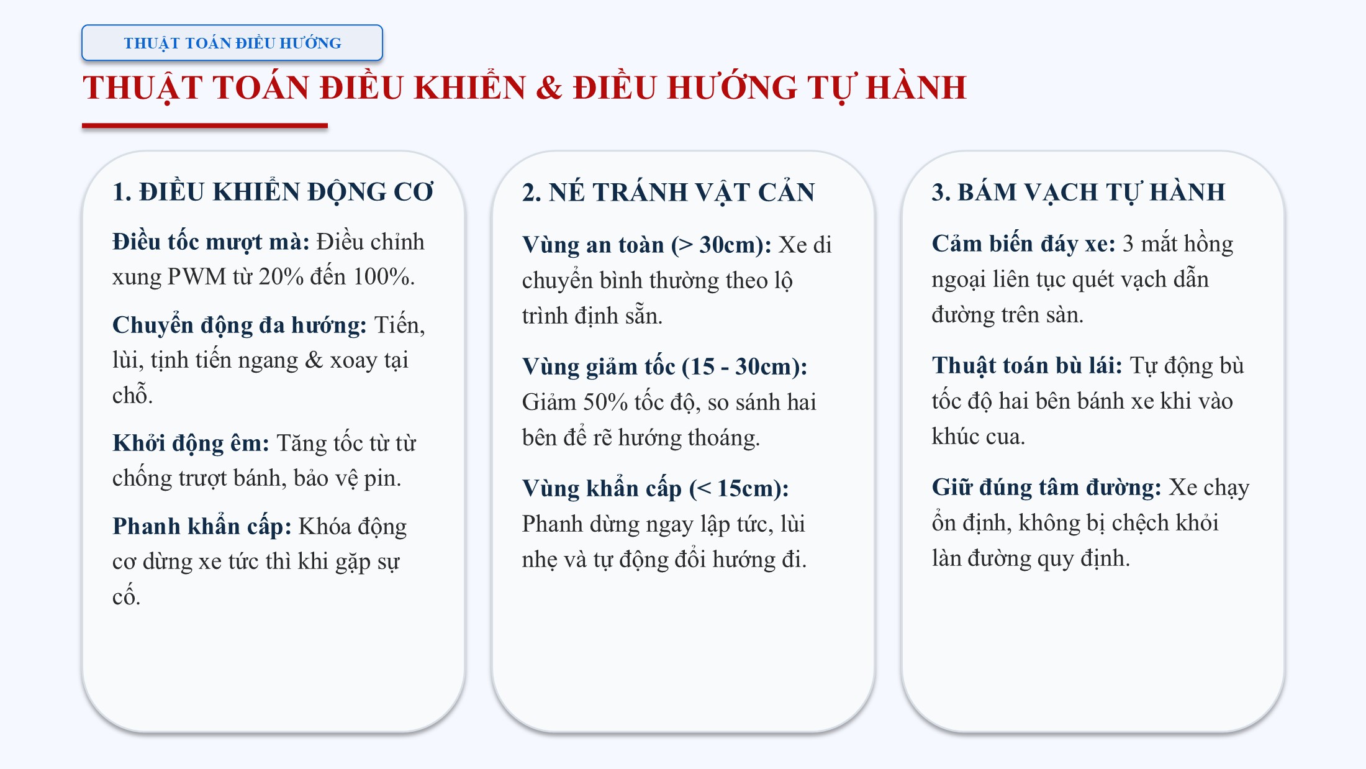
extracted_imgs/pptx_rendered_slides/Slide14.JPG
