tomyrese/DATN/extracted_imgs/pptx_rendered_slides/Slide15.JPG

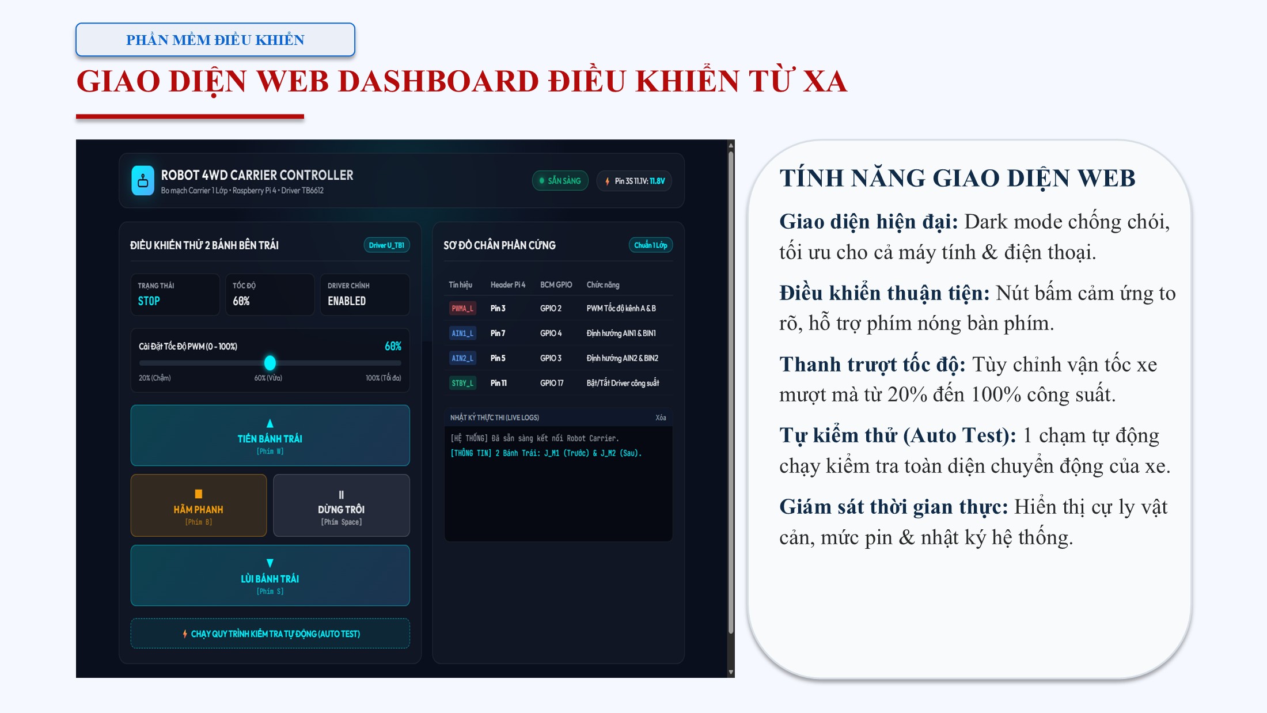
extracted_imgs/pptx_rendered_slides/Slide15.JPG
