tomyrese/DATN/extracted_imgs/pptx_rendered_slides/Slide16.JPG

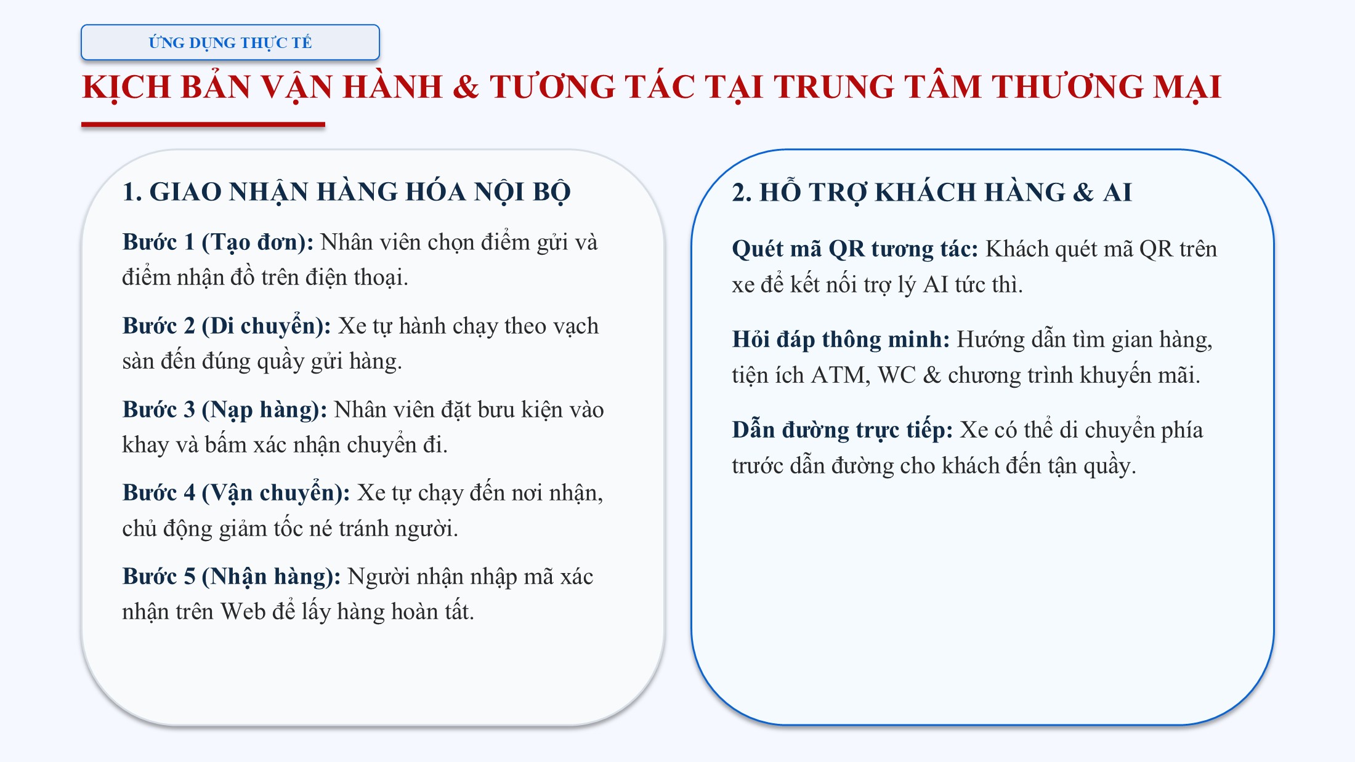
extracted_imgs/pptx_rendered_slides/Slide16.JPG
