tomyrese/DATN/extracted_imgs/pptx_rendered_slides/Slide17.JPG

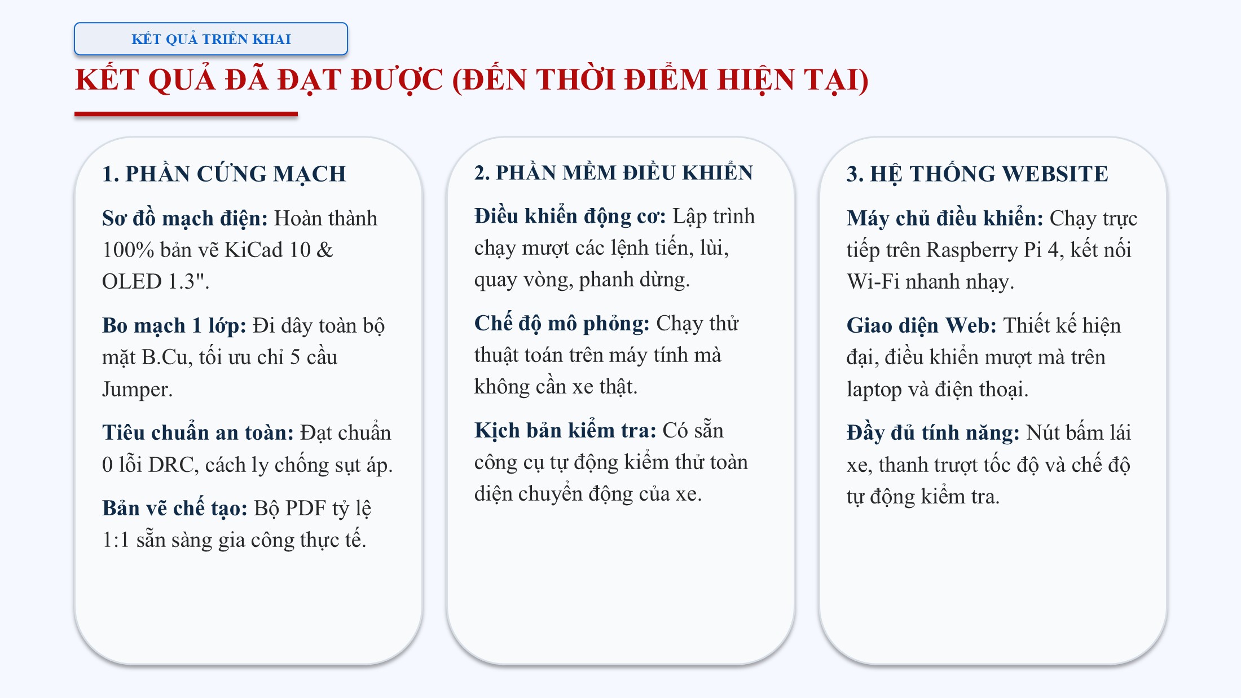
extracted_imgs/pptx_rendered_slides/Slide17.JPG
