tomyrese/DATN/extracted_imgs/pptx_rendered_slides/Slide18.JPG

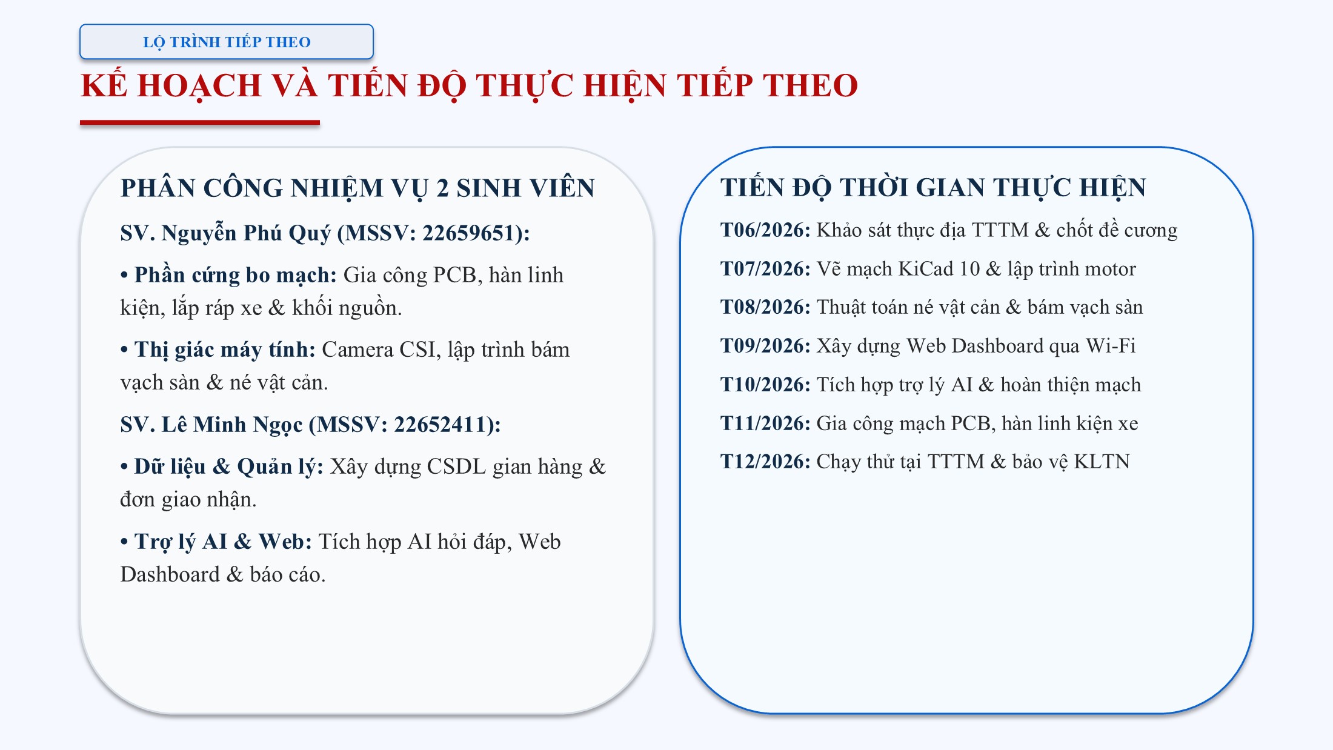
extracted_imgs/pptx_rendered_slides/Slide18.JPG
