tomyrese/DATN/extracted_imgs/pptx_rendered_slides/Slide19.JPG

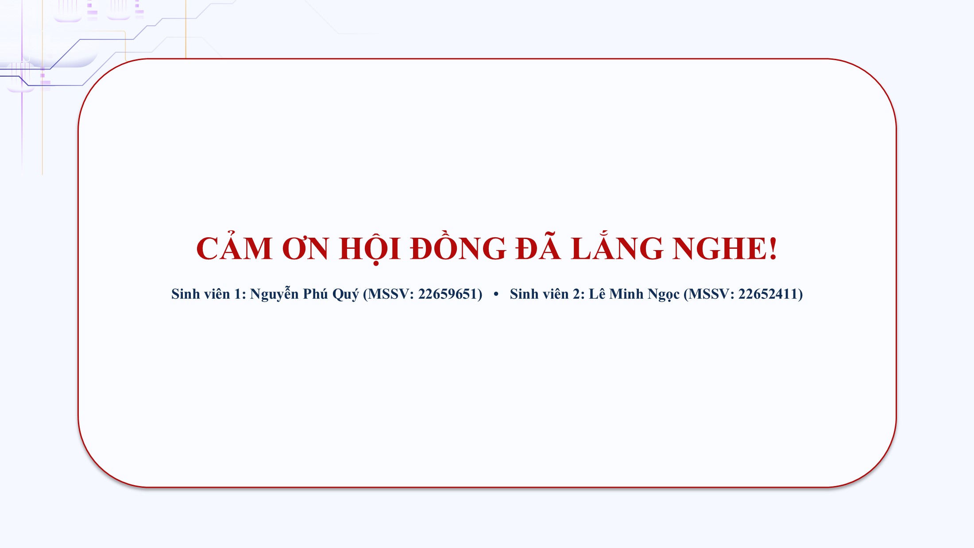
extracted_imgs/pptx_rendered_slides/Slide19.JPG
