tomyrese/DATN/extracted_imgs/preview_01_mirror.png

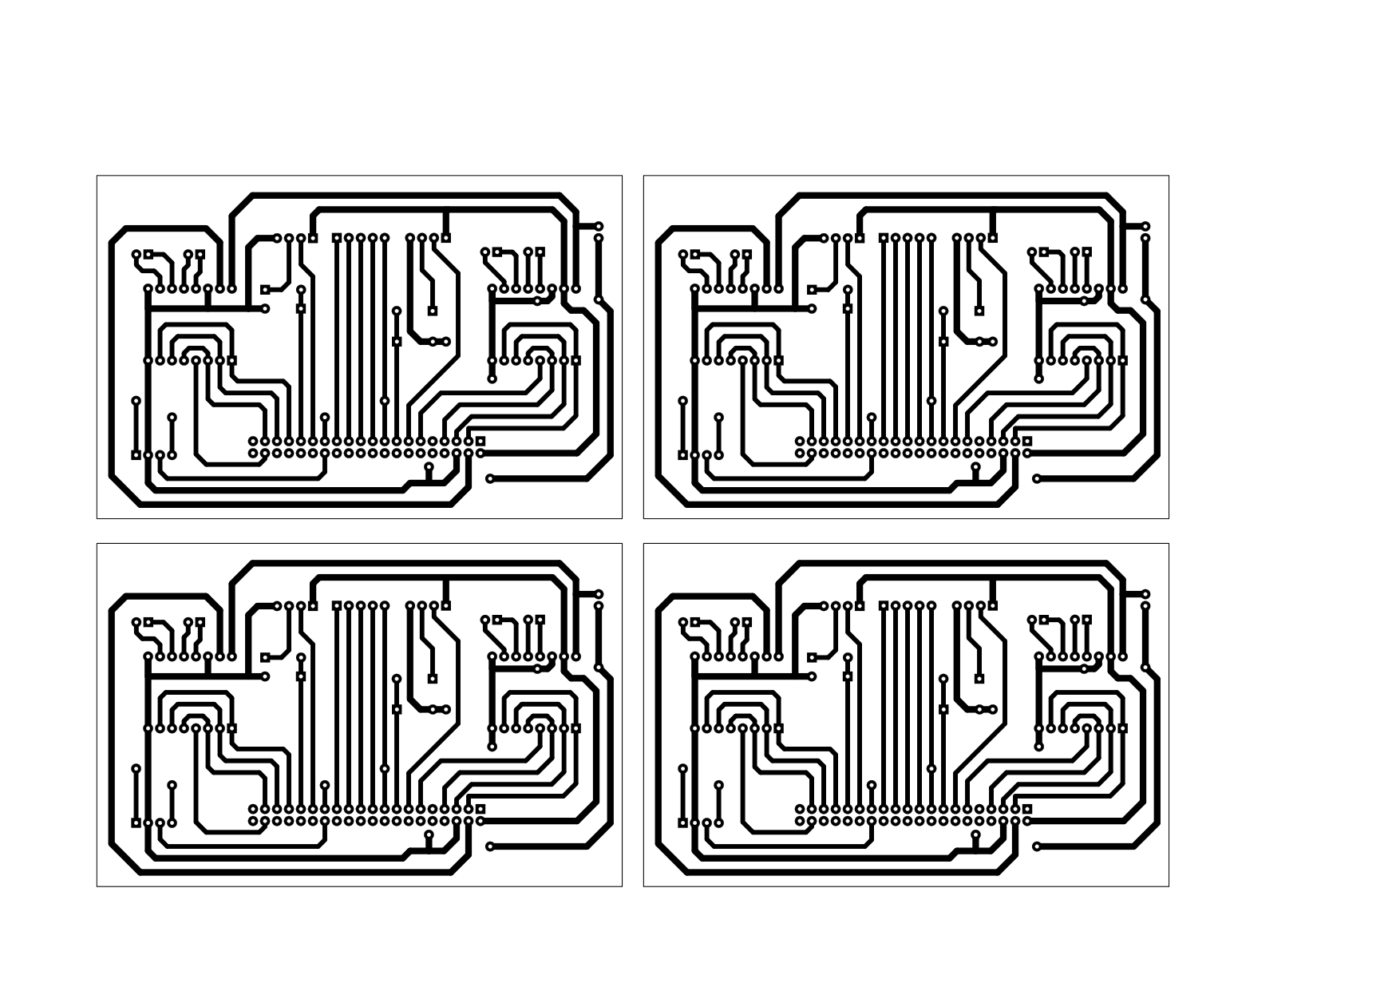
extracted_imgs/preview_01_mirror.png
