tomyrese/DATN/extracted_imgs/preview_02_direct.png

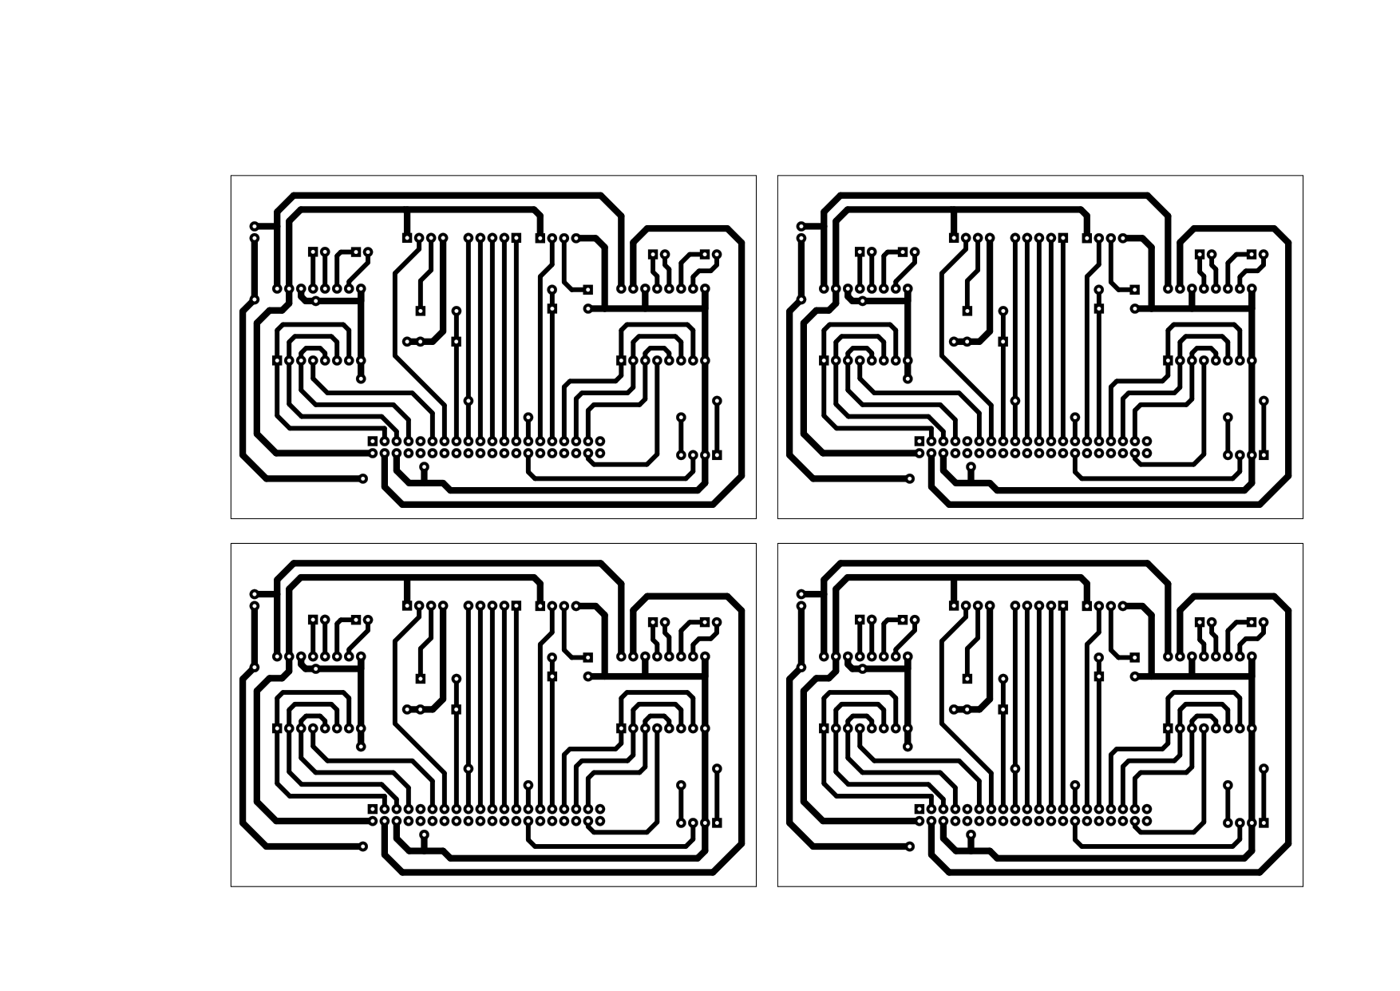
extracted_imgs/preview_02_direct.png
