tomyrese/DATN/extracted_imgs/preview_03_silkscreen.png

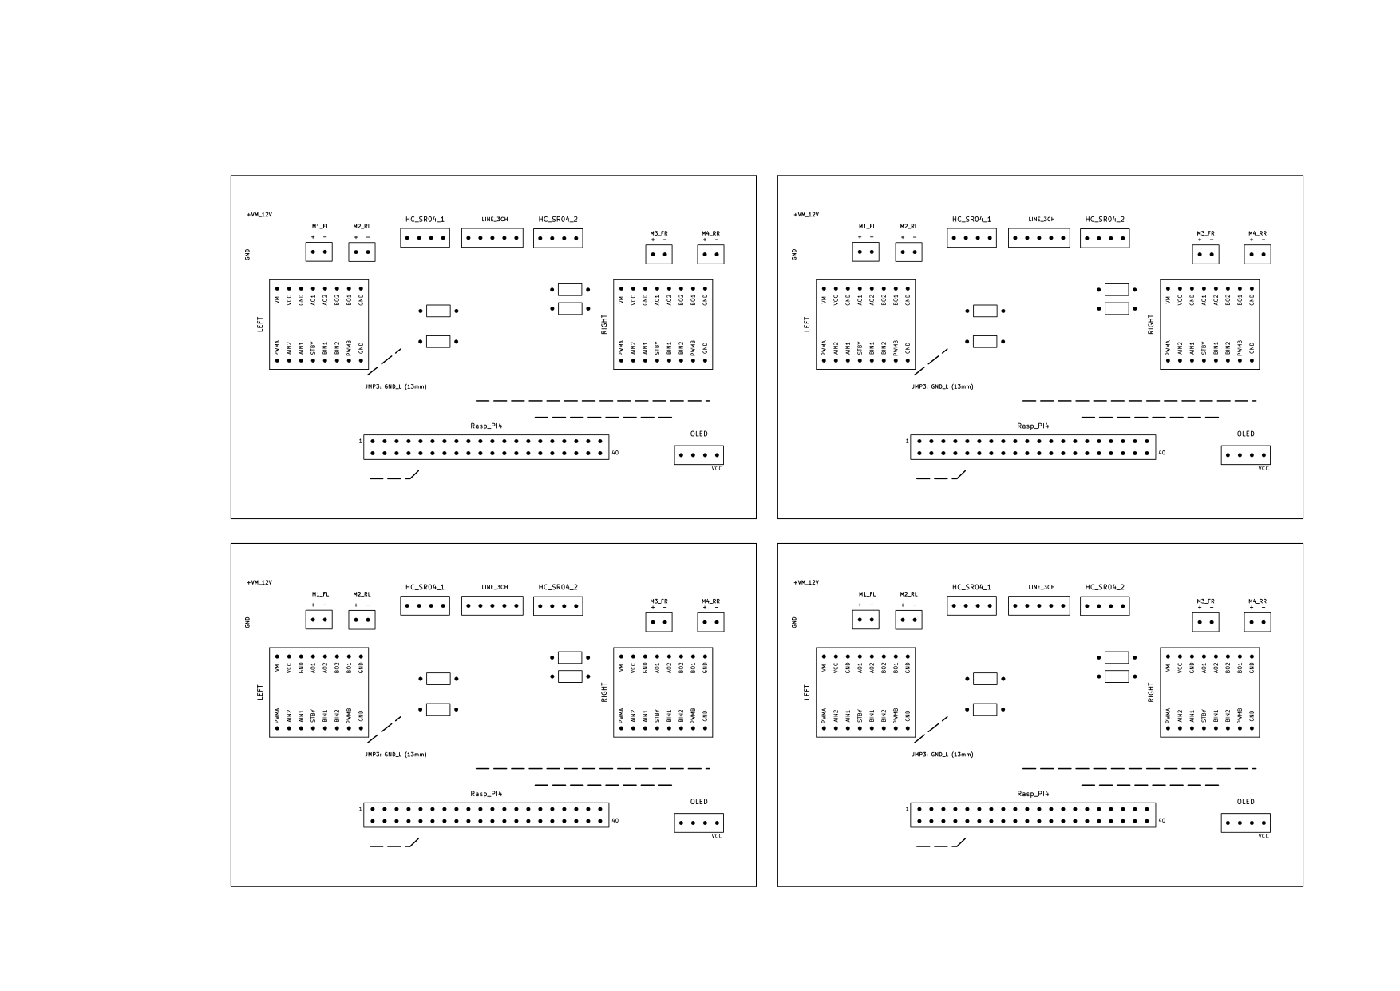
extracted_imgs/preview_03_silkscreen.png
