tomyrese/DATN/extracted_imgs/preview_fixed_chamfer_zoom.png

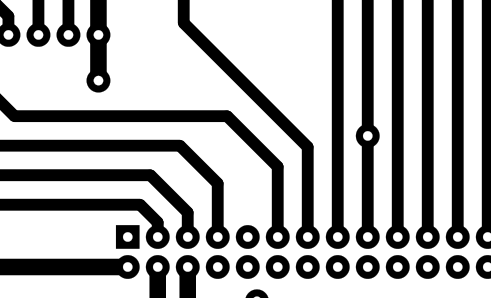
extracted_imgs/preview_fixed_chamfer_zoom.png
