tomyrese/DATN/extracted_imgs/preview_pads_zoom.png

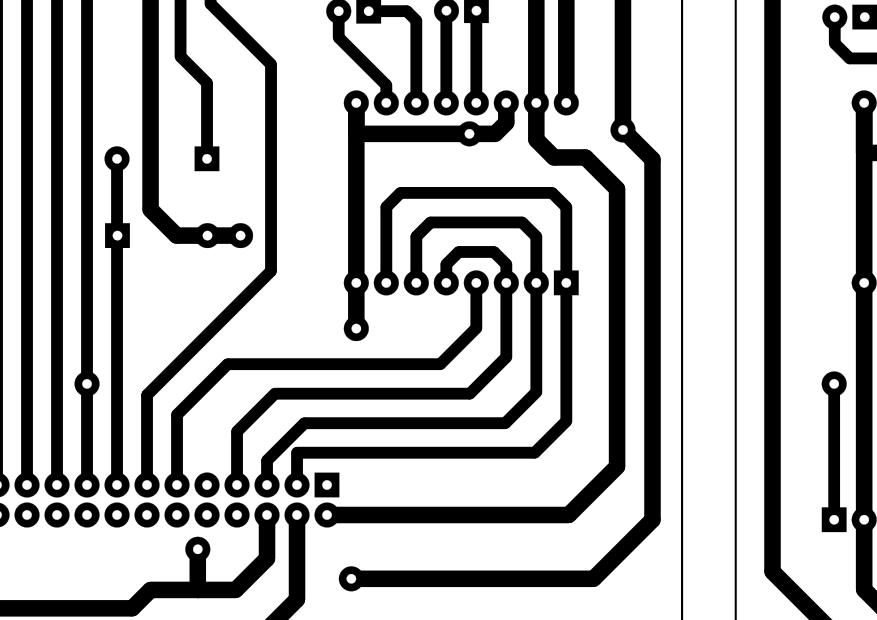
extracted_imgs/preview_pads_zoom.png
