tomyrese/DATN/extracted_imgs/schematic_diagram_cropped.png

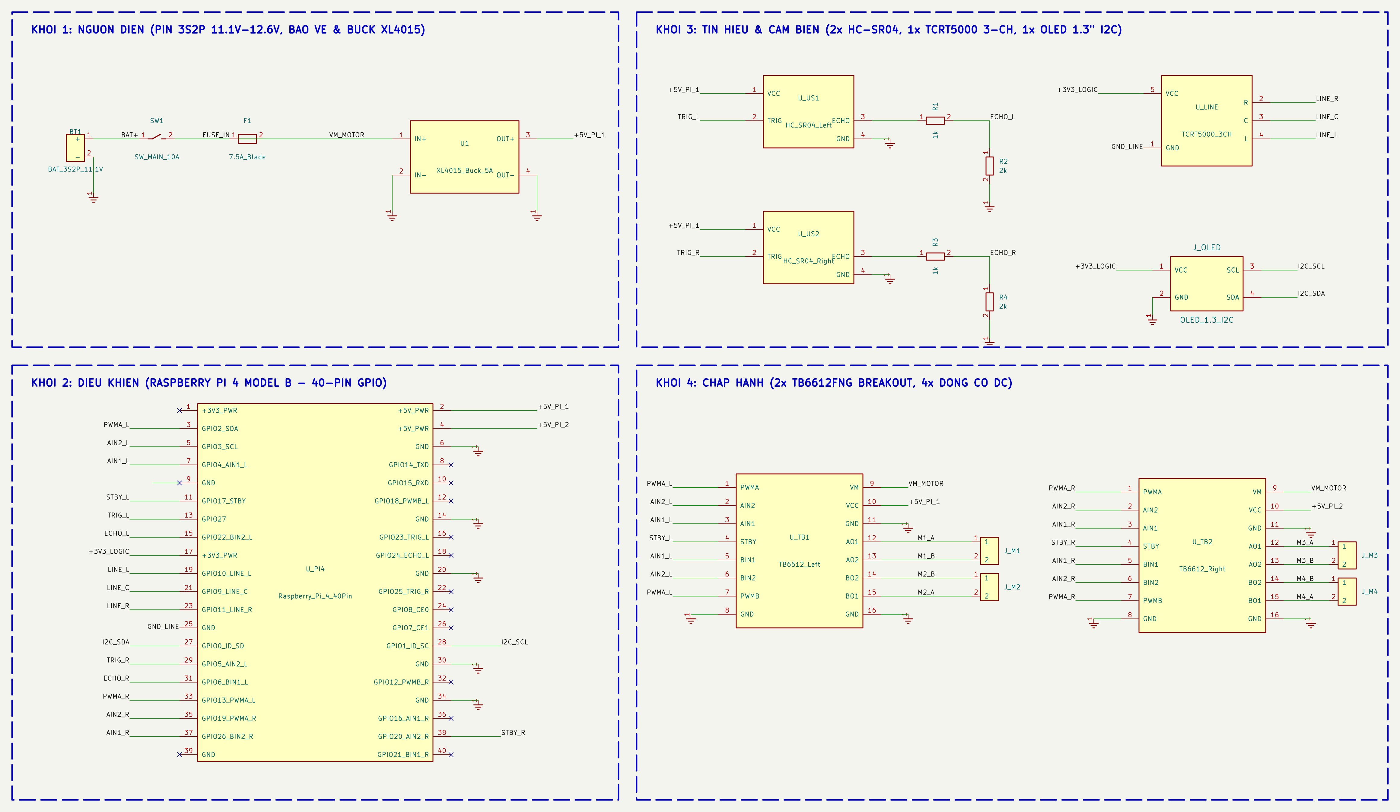
extracted_imgs/schematic_diagram_cropped.png
