tomyrese/DATN/luudo/luudo3.png

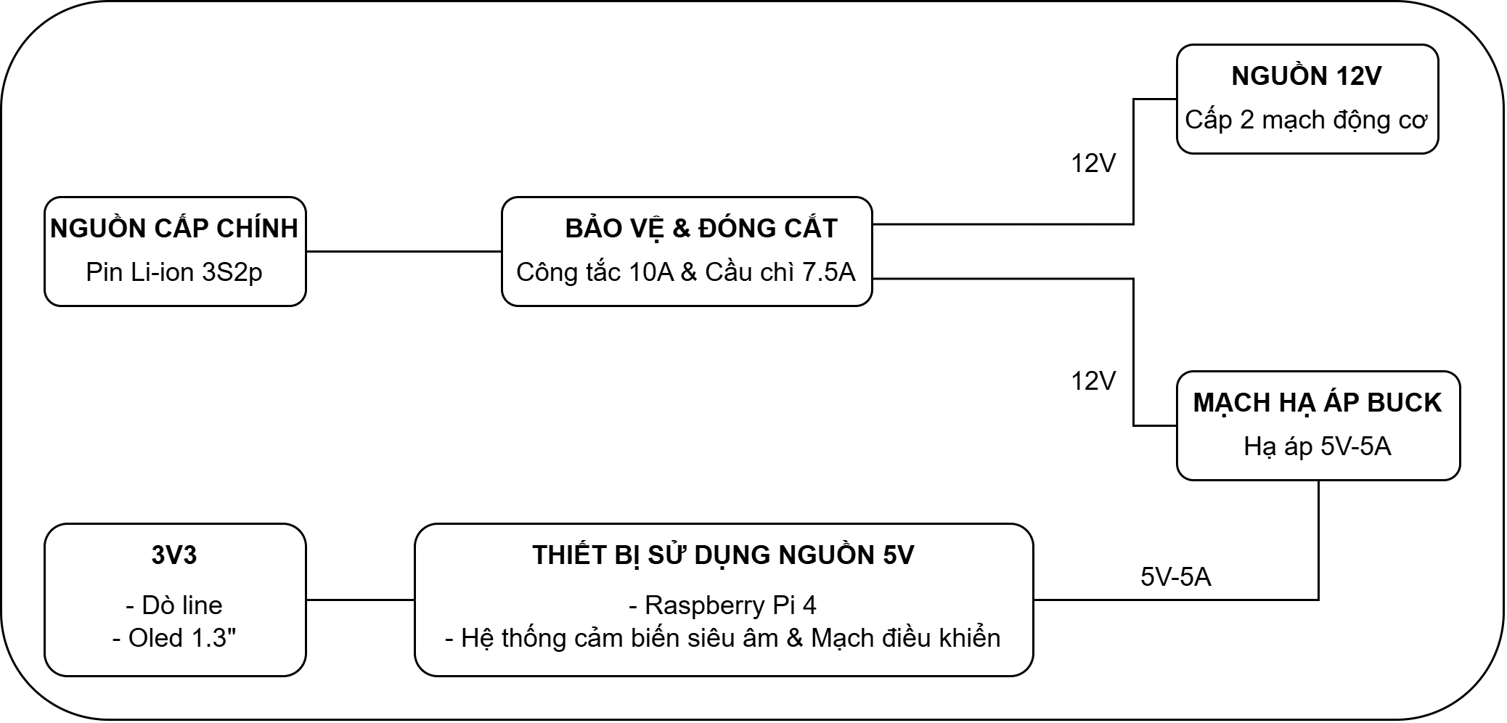
luudo/luudo3.png
