tomyrese/DATN/luudo/luudo4.png

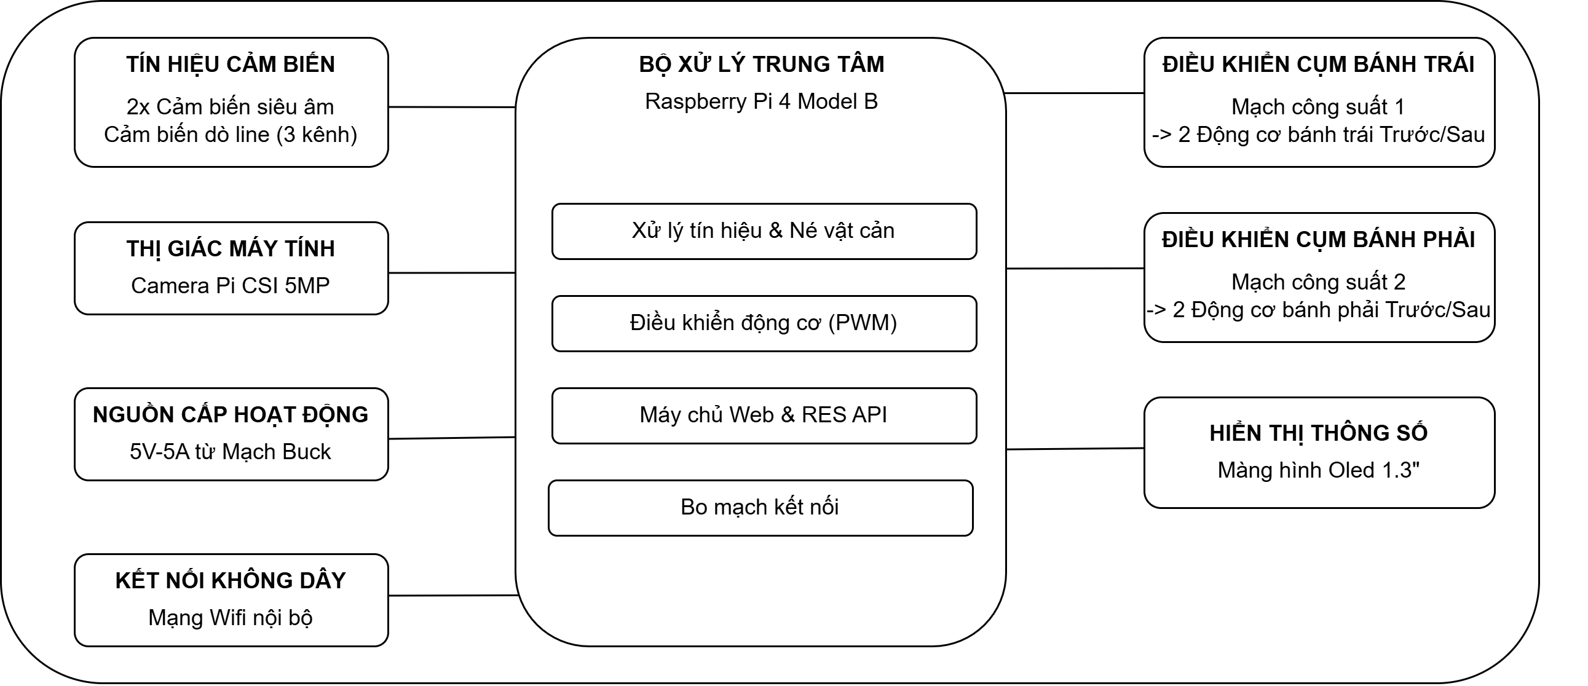
luudo/luudo4.png
