tomyrese/DATN/luudo/luudo5.png

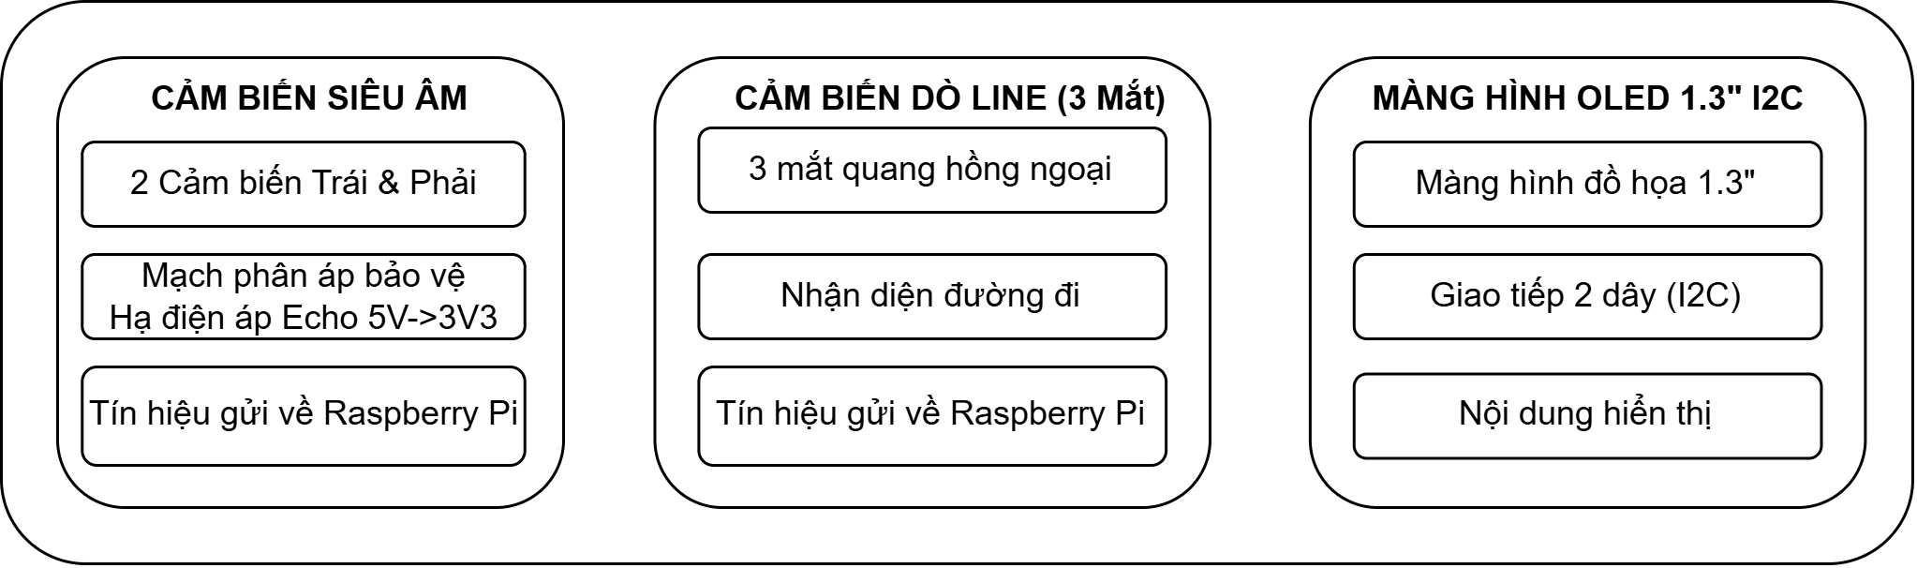
luudo/luudo5.png
