tomyrese/DATN/luudo/luudo6.png

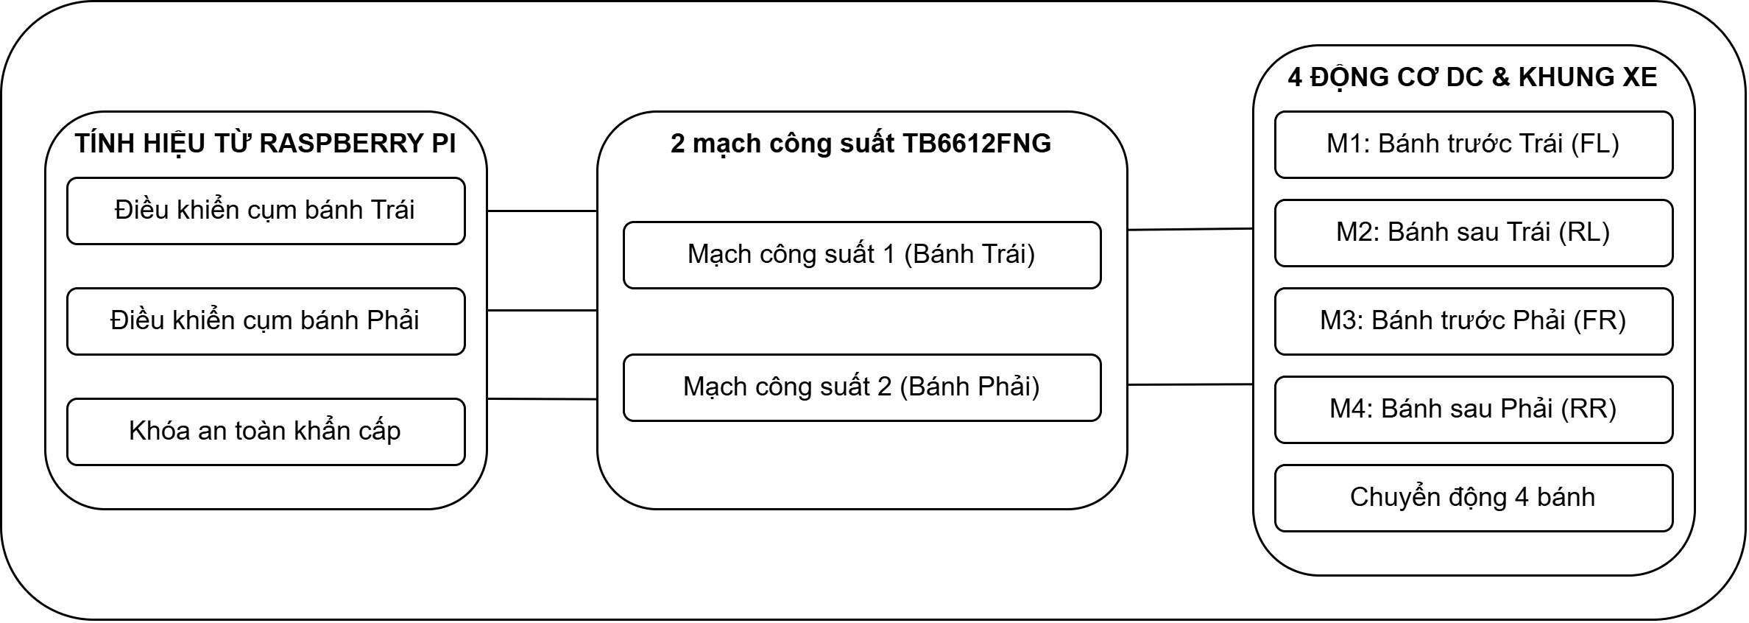
luudo/luudo6.png
