tomyrese/DATN/luudo/mermaid-diagram2.png

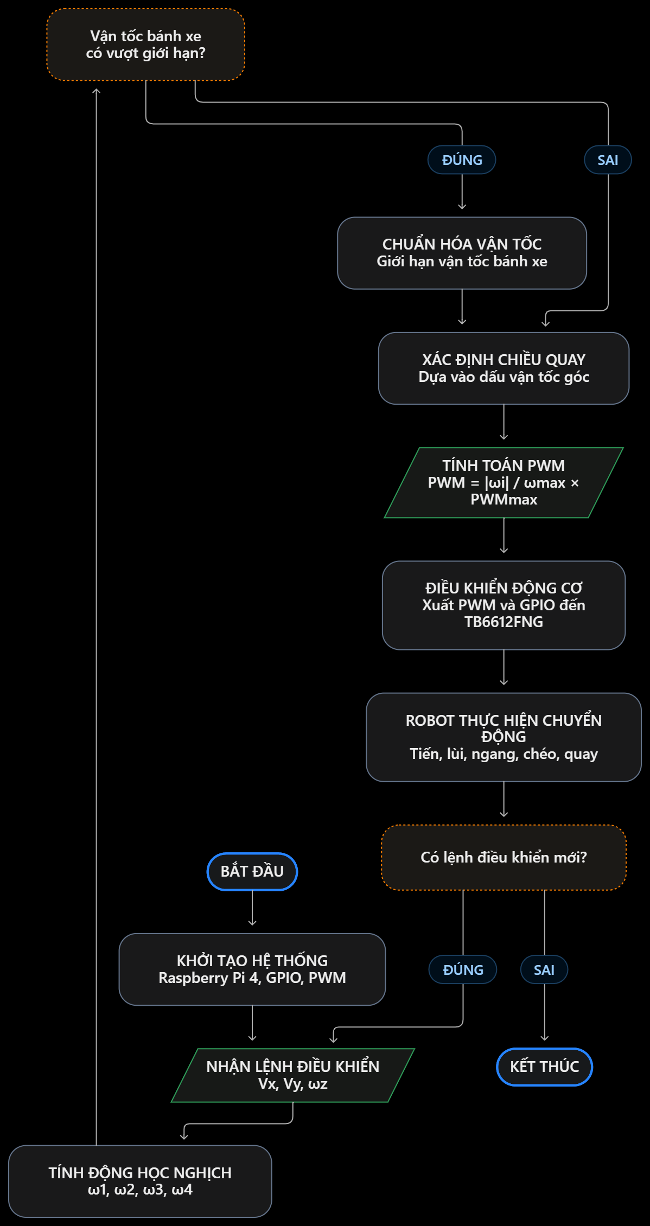
luudo/mermaid-diagram2.png
