tomyrese/DATN/luudo/mermaid-diagram.png

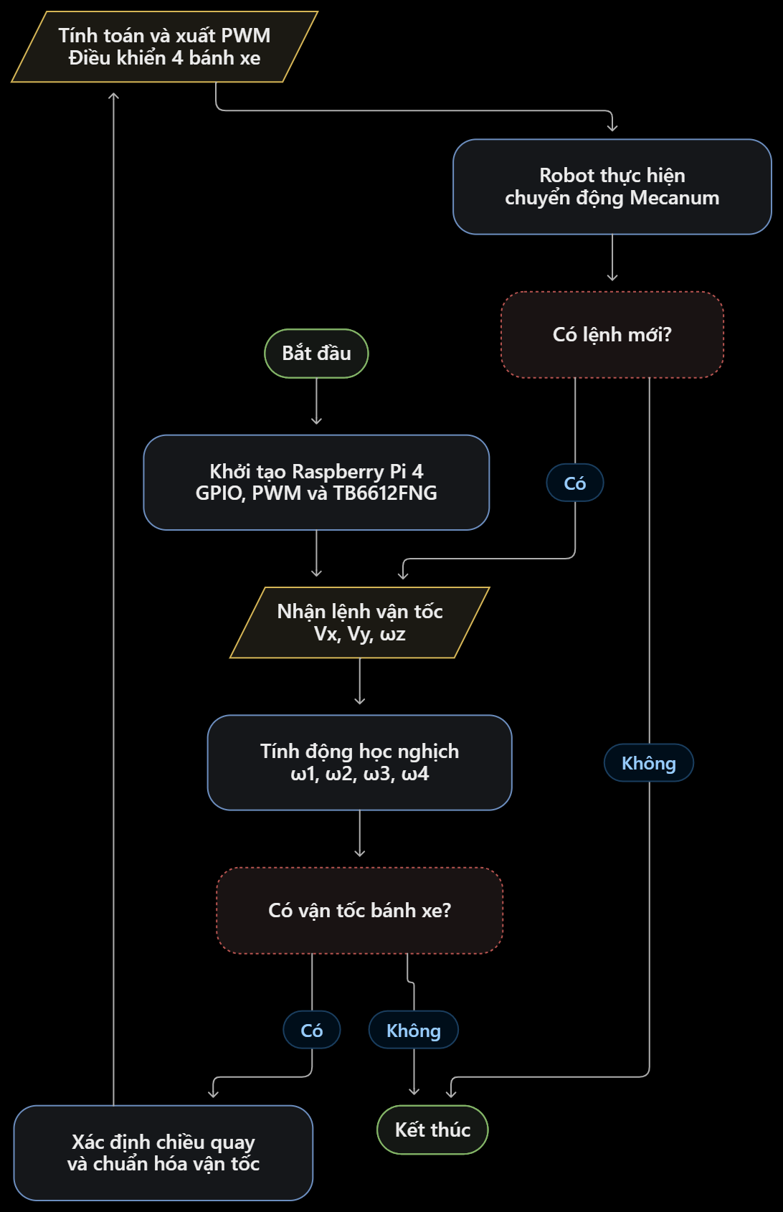
luudo/mermaid-diagram.png
