tomyrese/DATN/Pi4_Robot_Carrier_Schematic.pdf

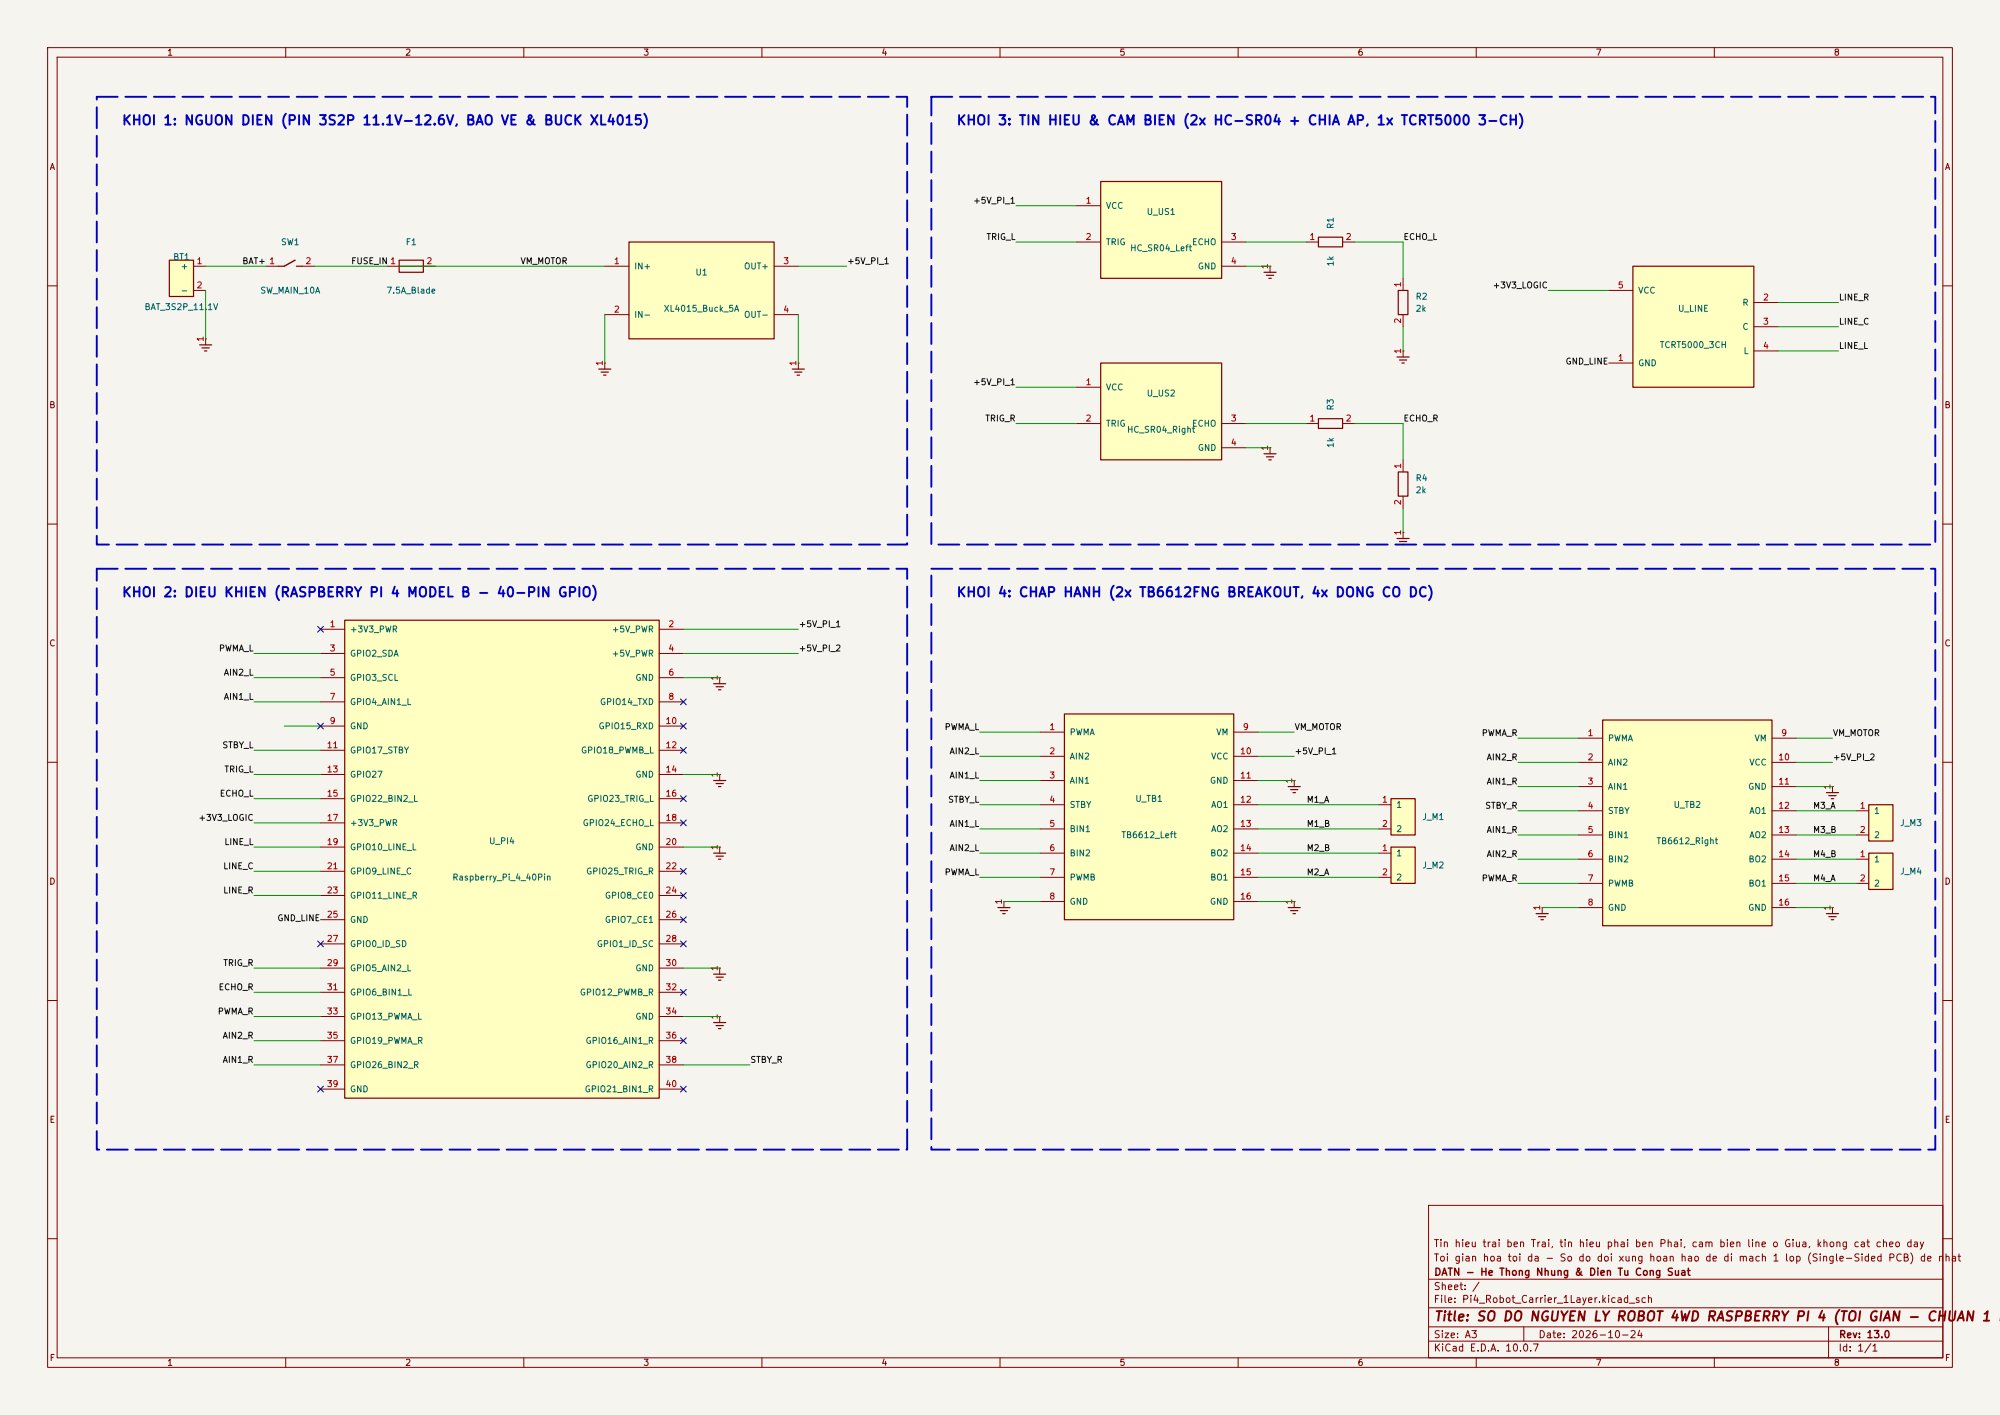
[picture p79: page 1]

TRIG_R KHOI 1: NGUON DIEN (PIN 3S2P 11.1V-12.6V, BAO VE & BUCK XL4015)

KHOI 3: TIN HIEU & CAM BIEN (2x HC-SR04 + CHIA AP, 1x TCRT5000 3-CH)

Tin hieu trai ben Trai, tin hieu phai ben Phai, cam bien line o Giua, khong cat cheo day
Toi gian hoa toi da - So do doi xung hoan hao de di mach 1 lop (Single-Sided PCB) de nhat
DATN - He Thong Nhung & Dien Tu Cong Suat
Sheet: /
File: Pi4_Robot_Carrier_1Layer.kicad_sch
Title: SO DO NGUYEN LY ROBOT 4WD RASPBERRY PI 4 (TOI GIAN - CHUAN 1 LOP)

Size: A3 | Rev: 13.0 | F Date: 2026-10-24
KiCad E.D.A. 10.0.7 | Id: 1/1
