tomyrese/DATN/pdf_lam_mach/04_So_Do_Nguyen_Ly_Schematic.pdf

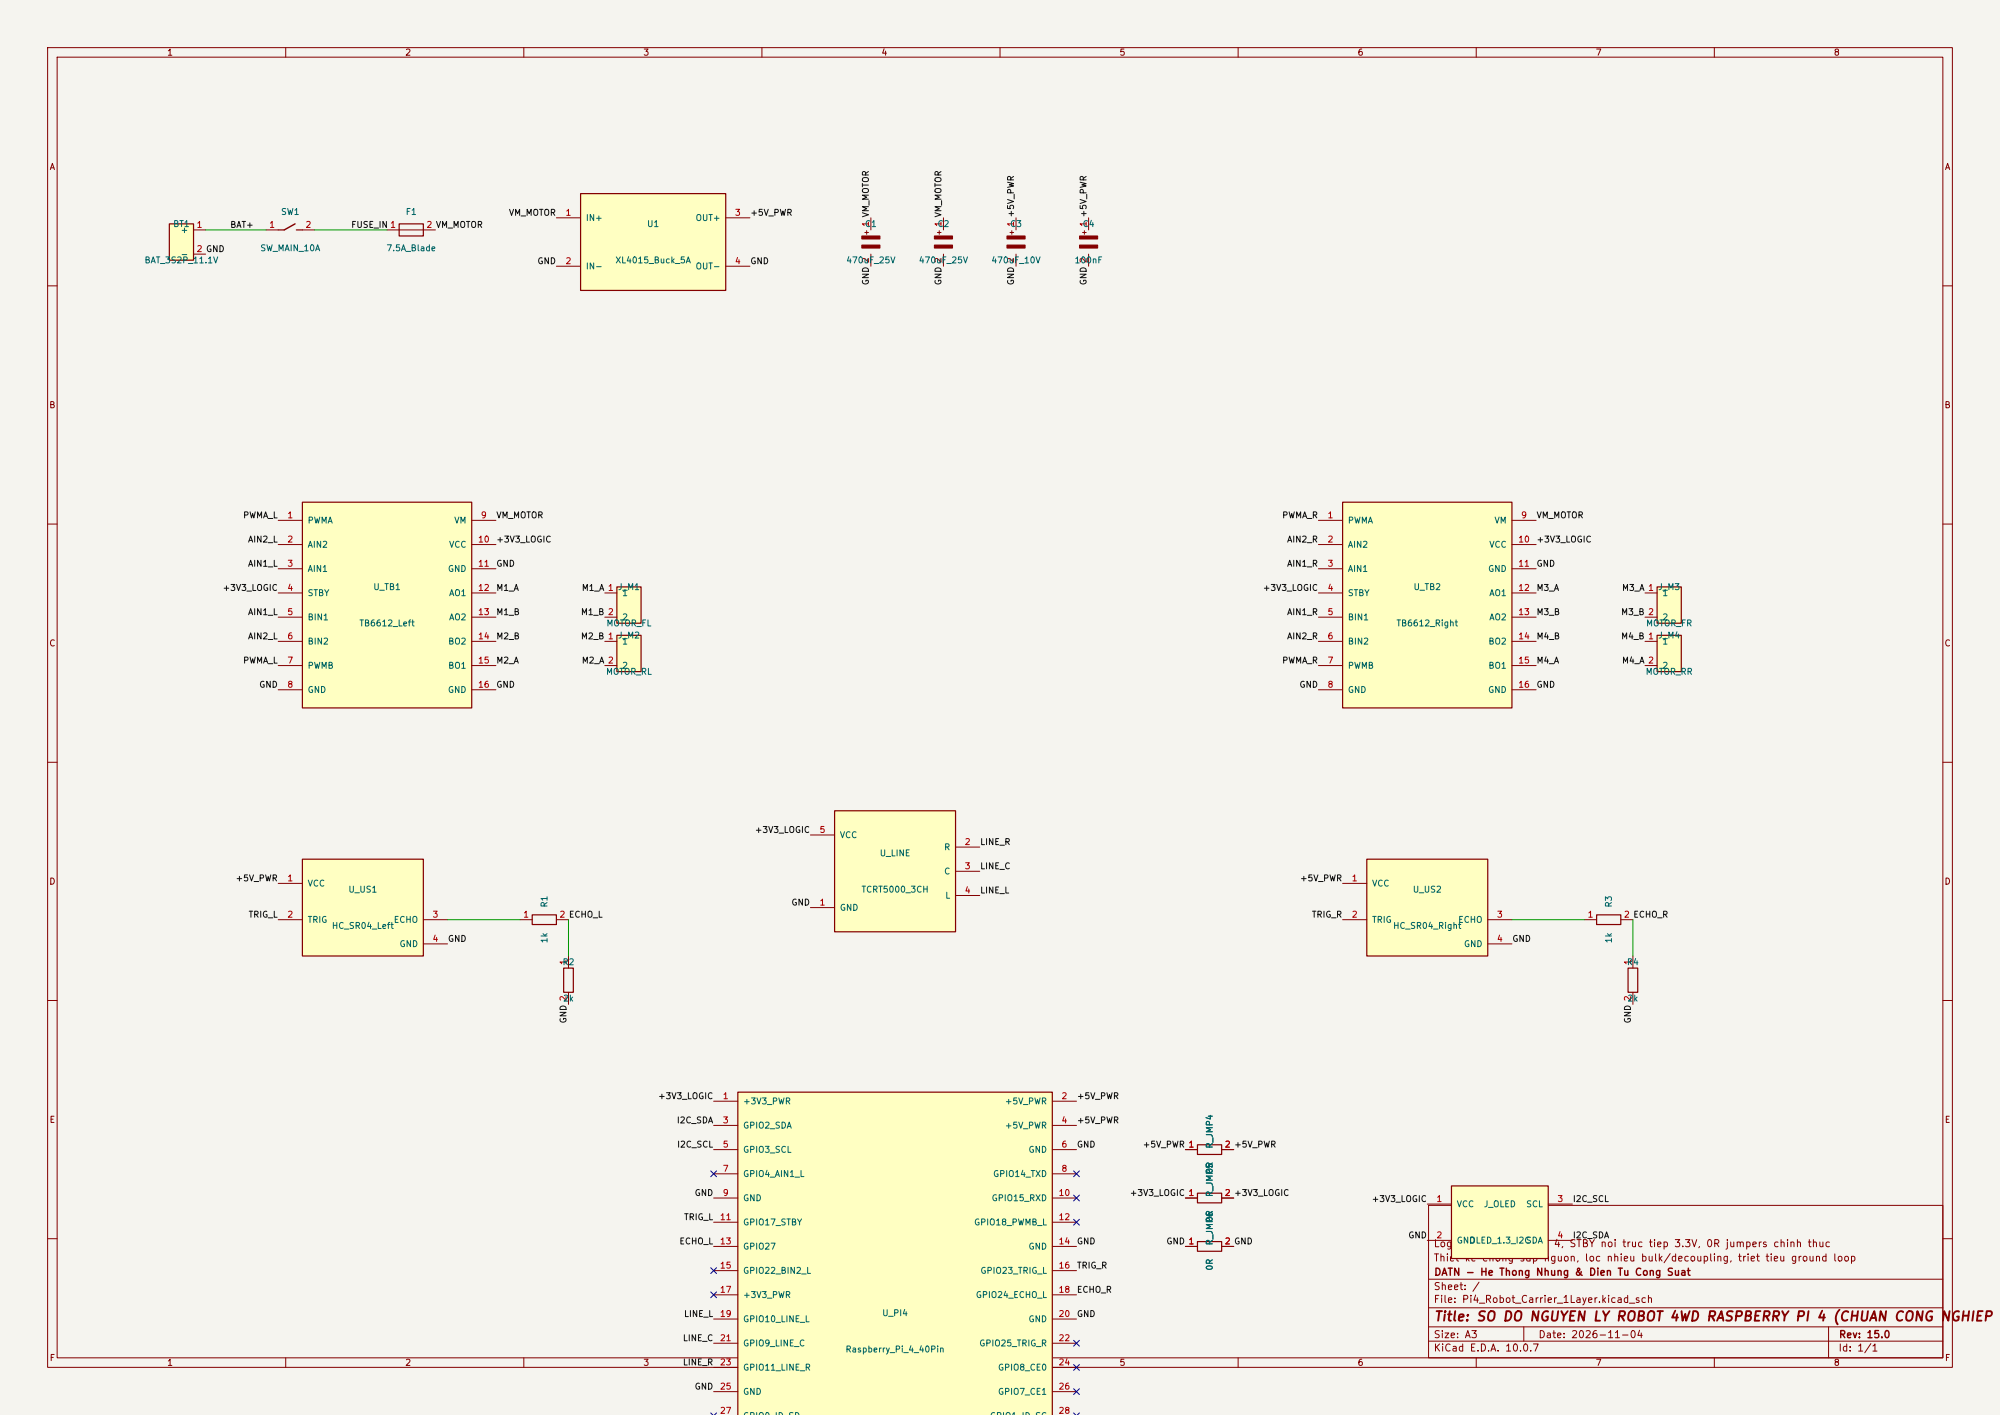
[picture p80: page 1]

Thiet ke chong sap nguon, loc nhieu bulk/decoupling, triet tieu ground loop
DATN - He Thong Nhung & Dien Tu Cong Suat
Sheet: /
File: Pi4_Robot_Carrier_1Layer.kicad_sch
Title: SO DO NGUYEN LY ROBOT 4WD RASPBERRY PI 4 (CHUAN CONG NGHIEP - 1 LOP)

Size: A3 | Rev: 15.0 | F Date: 2026-11-04
KiCad E.D.A. 10.0.7 | Id: 1/1
