tomyrese/DATN/pdf_lam_mach/03_Mat_Tren_F_Silkscreen.pdf

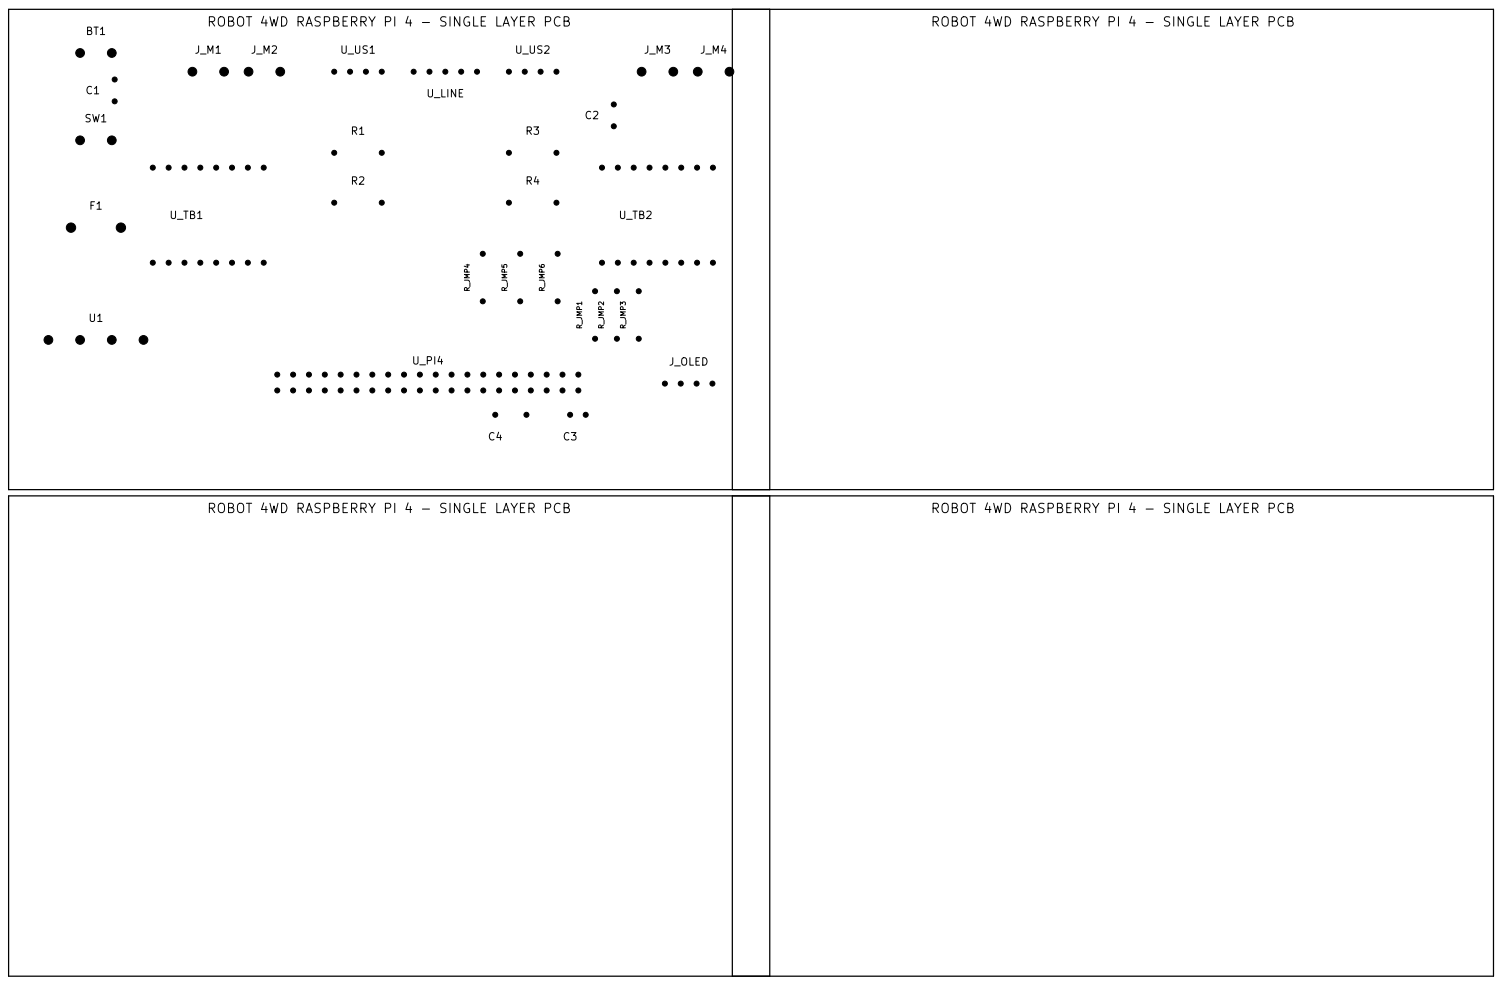
[picture p81: page 1]

ROBOT 4WD RASPBERRY PI 4 - SINGLE LAYER PCB
