tomyrese/DATN/Pi4_Robot_Carrier_1Layer.pdf

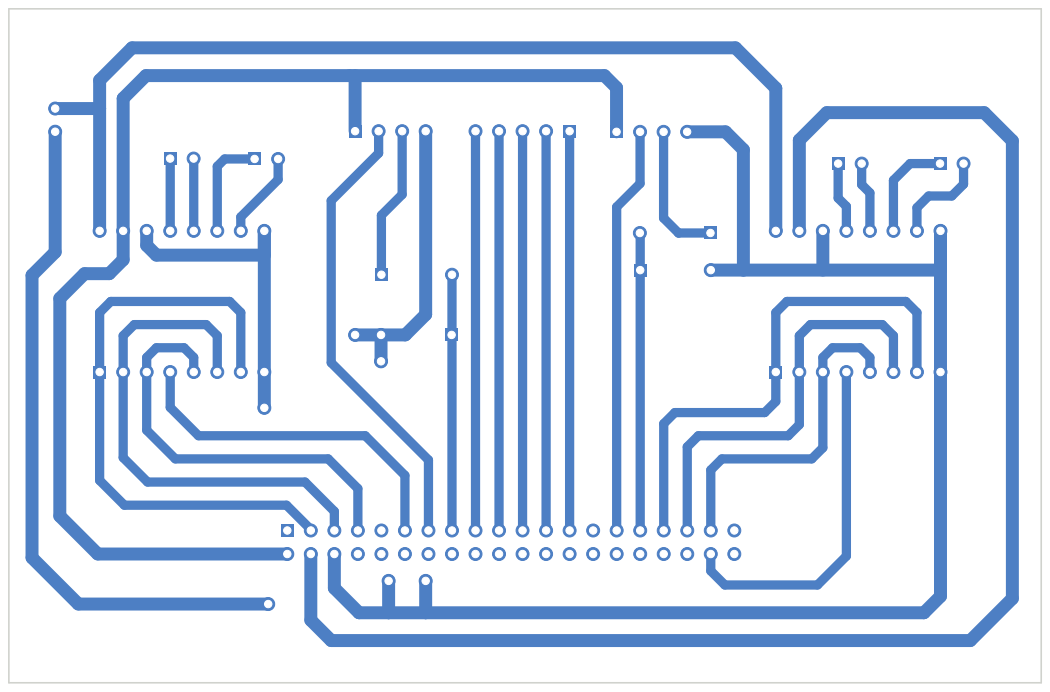
[picture p82: page 1]
