tomyrese/DATN/pdf_lam_mach/01_Mat_Day_B_Cu_MIRROR_Ui_Nhiet.pdf

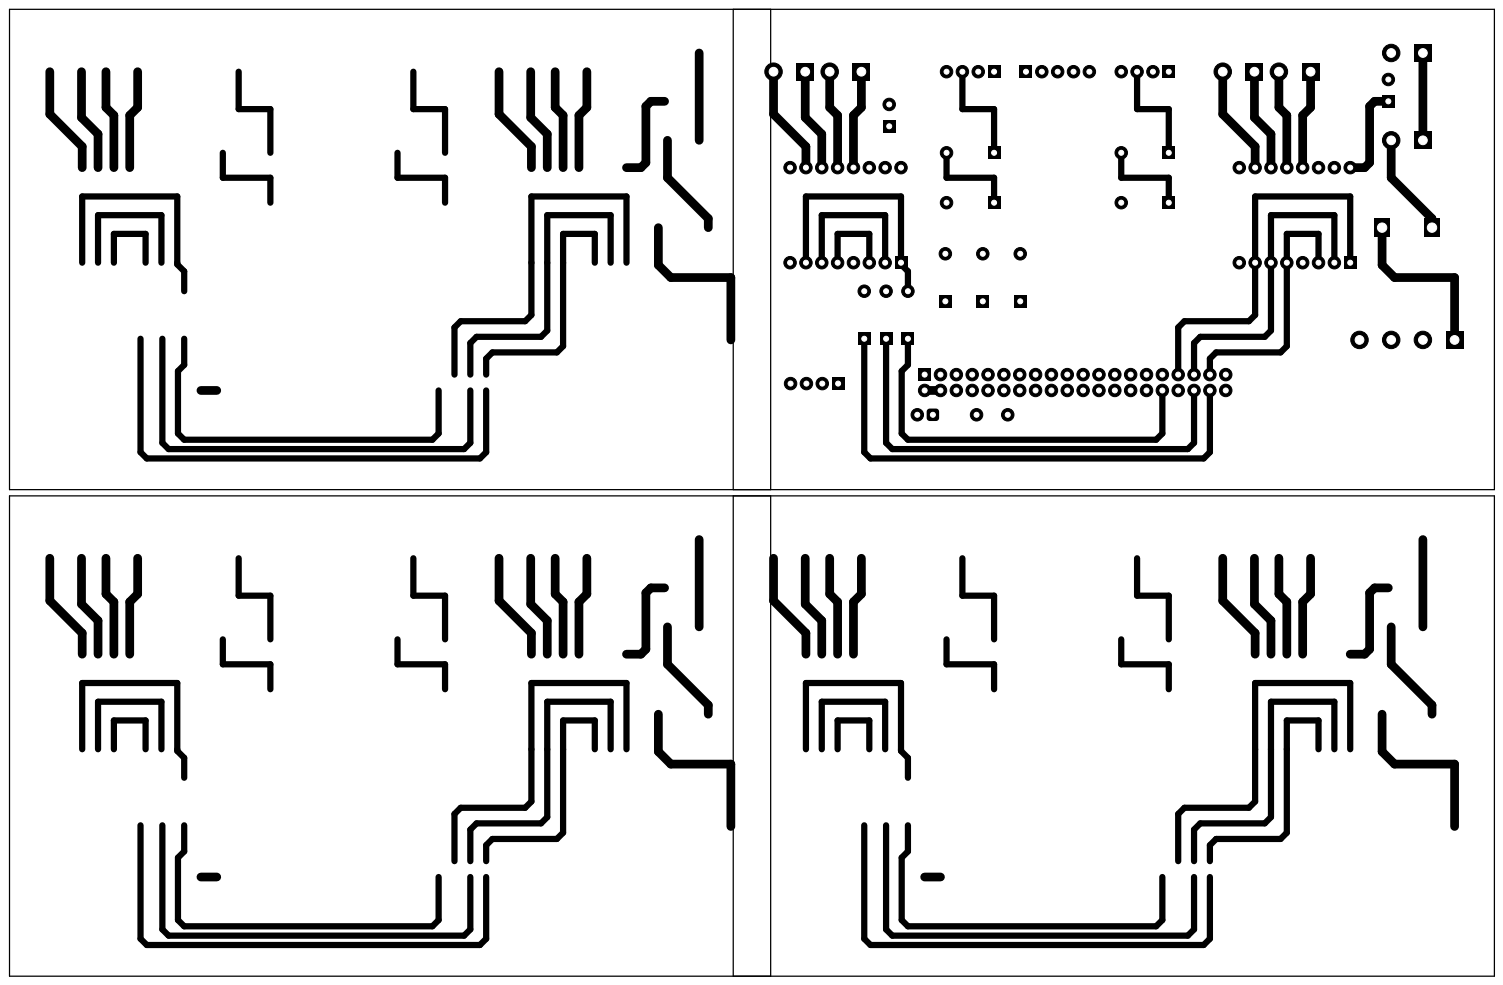
[picture p83: page 1]
