tomyrese/DATN/pdf_lam_mach/02_Mat_Day_B_Cu_DIRECT_In_Film.pdf

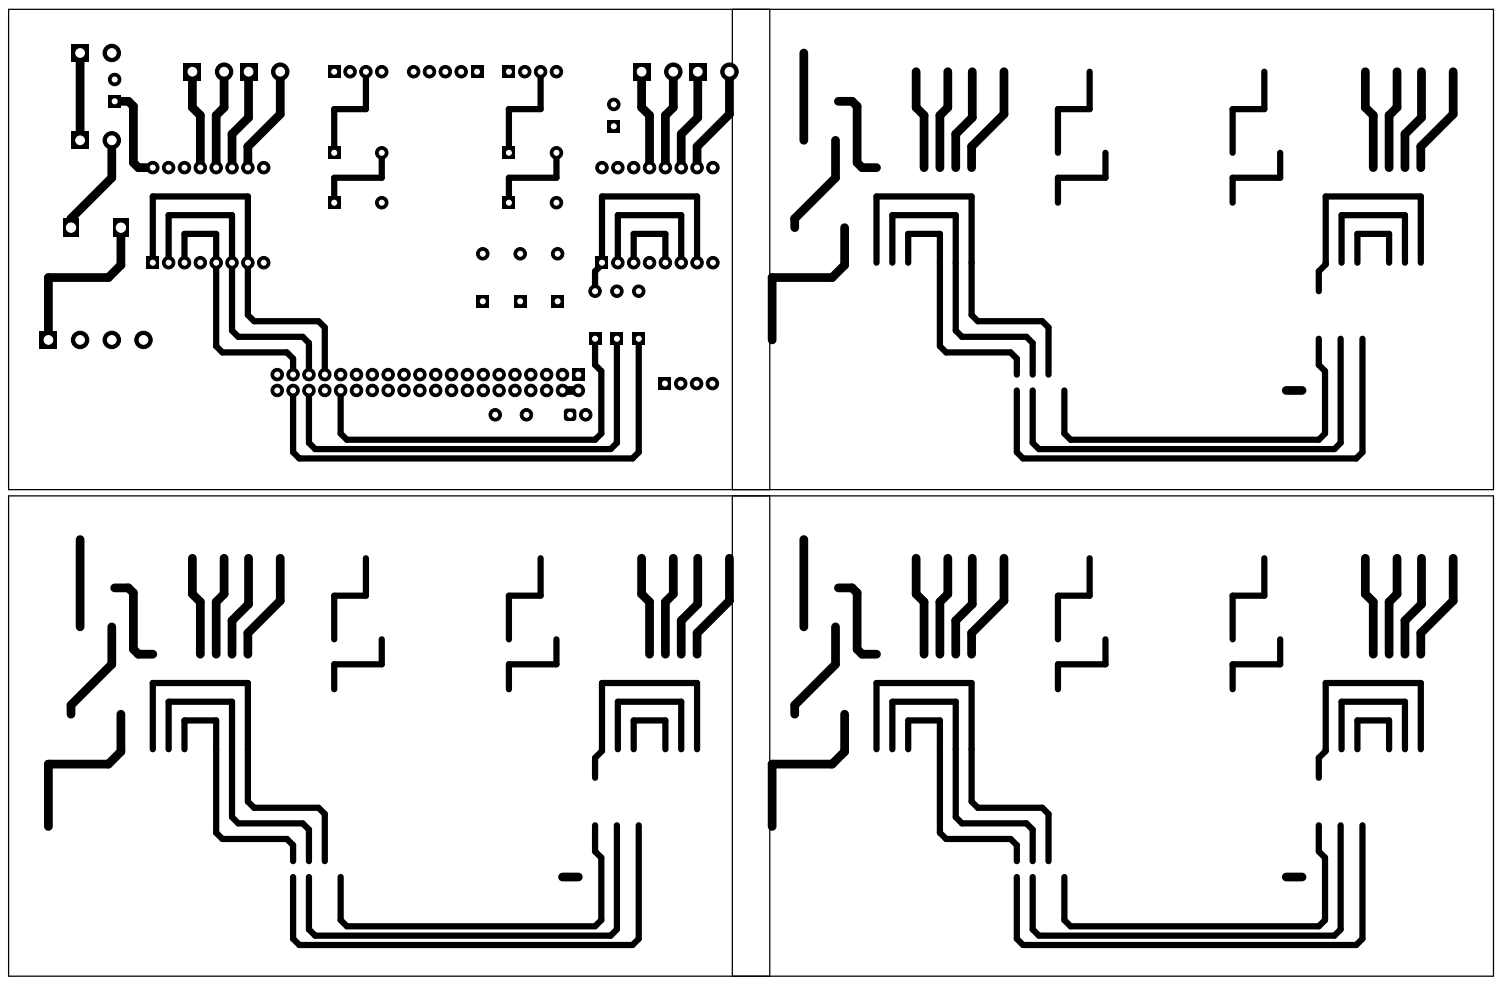
[picture p84: page 1]
