tomyrese/DATN/pdf_lam_mach/01_Panel_4x_A4_B_Cu_MIRROR_Ui_Nhiet.pdf

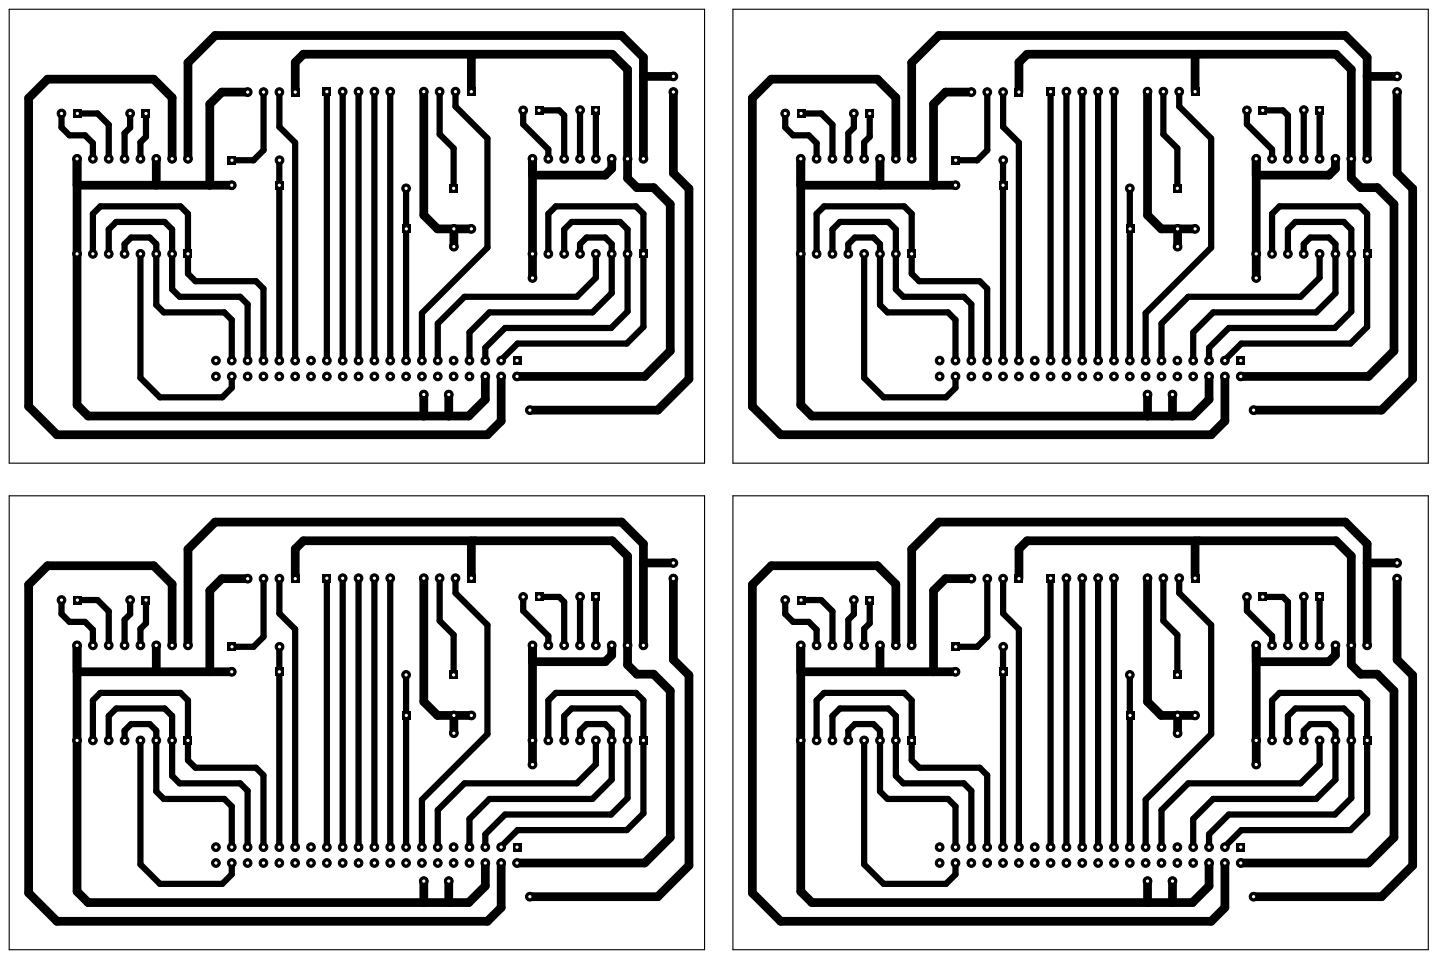
[picture p85: page 1]
