tomyrese/DATN/pdf_lam_mach/02_PANEL_4X_A4_B_Cu_DIRECT_In_Film.pdf

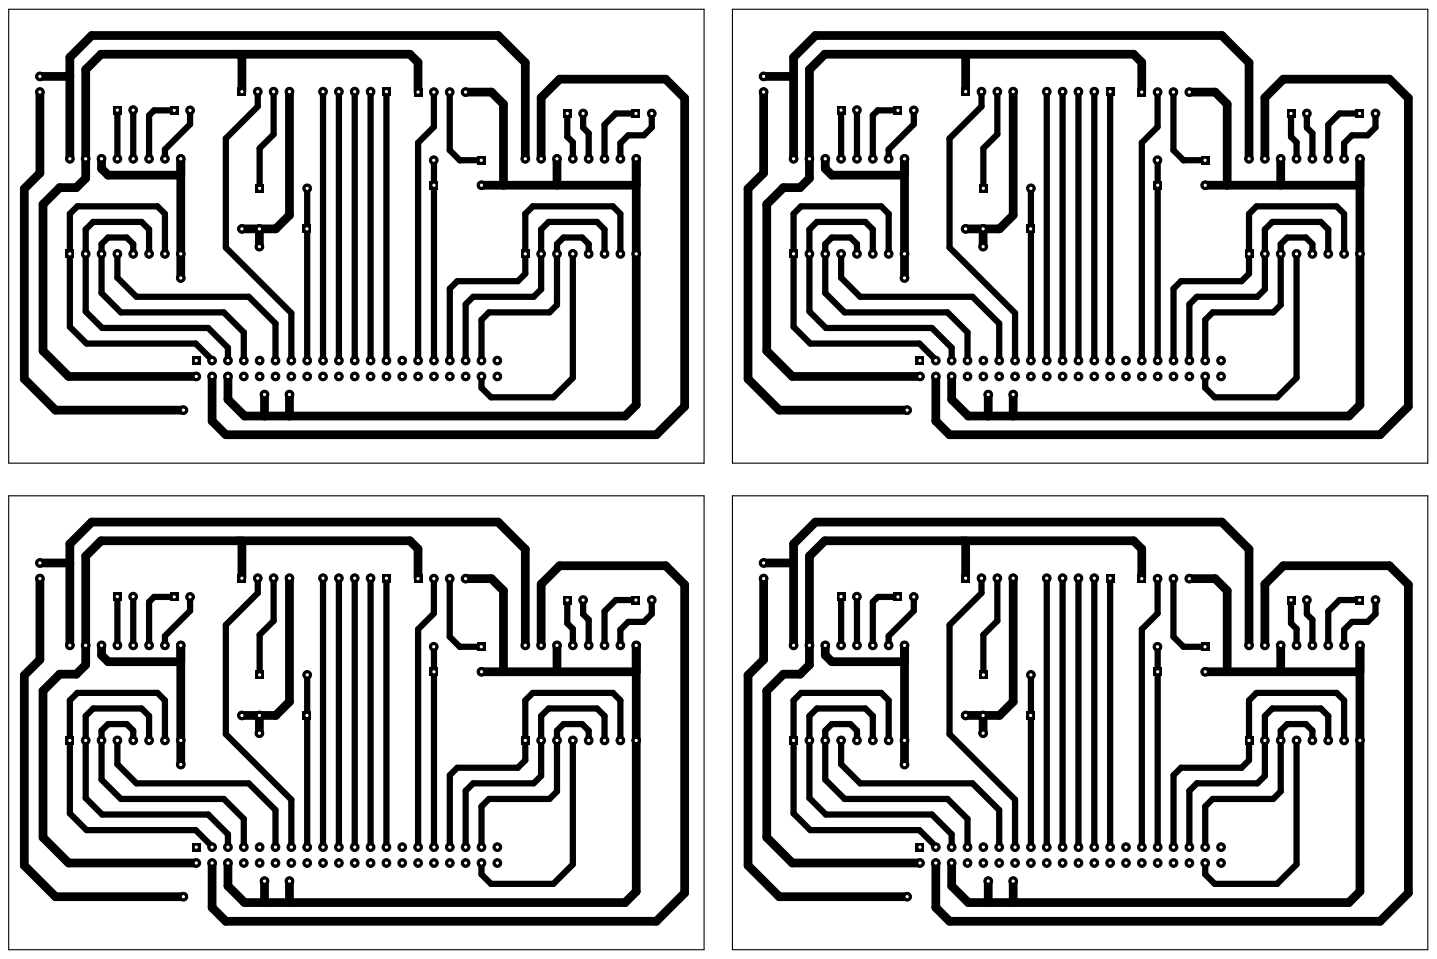
[picture p86: page 1]
