tomyrese/DATN/pdf_lam_mach/03_PANEL_4X_A4_F_Silkscreen.pdf

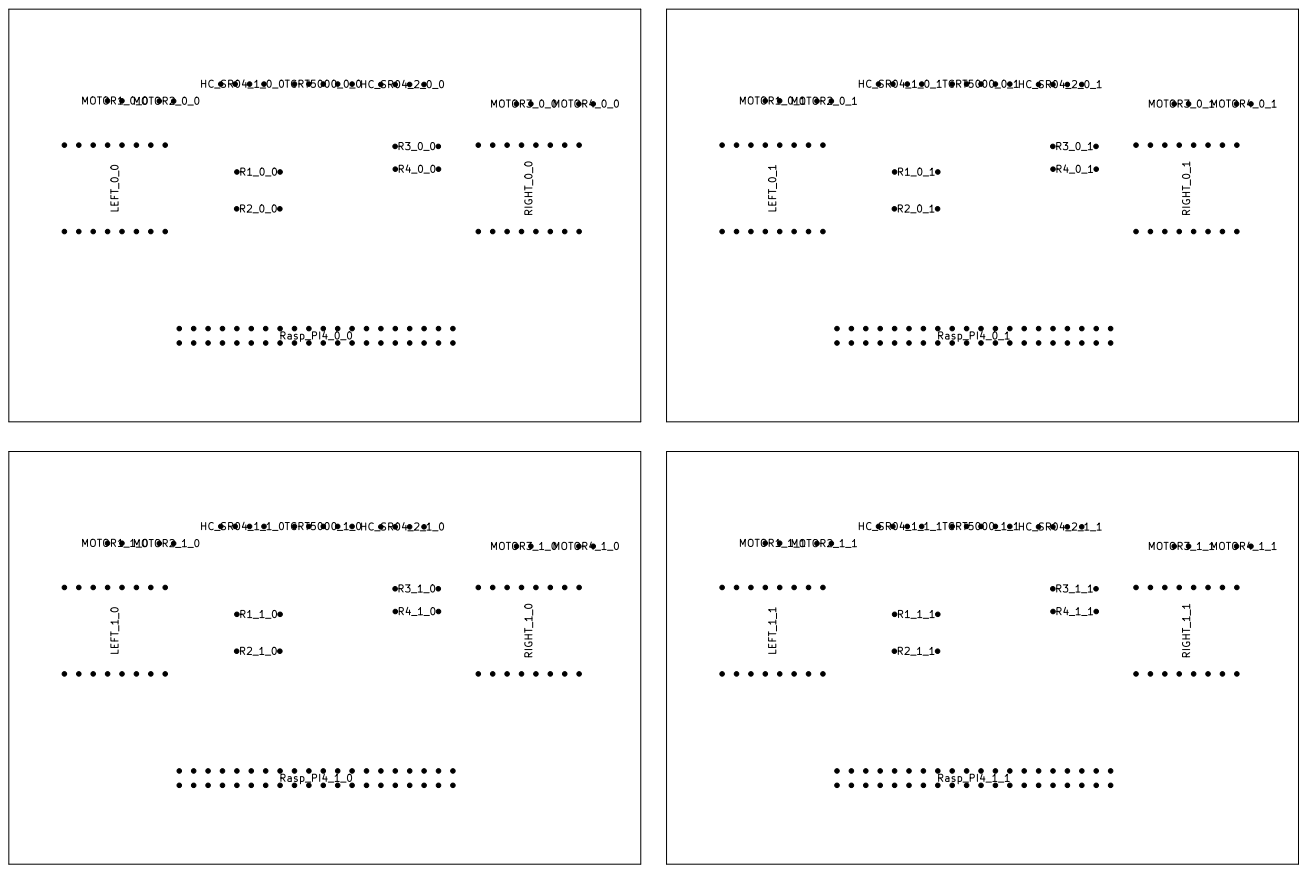
[picture p87: page 1]
