tomyrese/DATN/pdf_lam_mach/04_PANEL_2X_A4_B_Cu_MIRROR_Ui_Nhiet.pdf

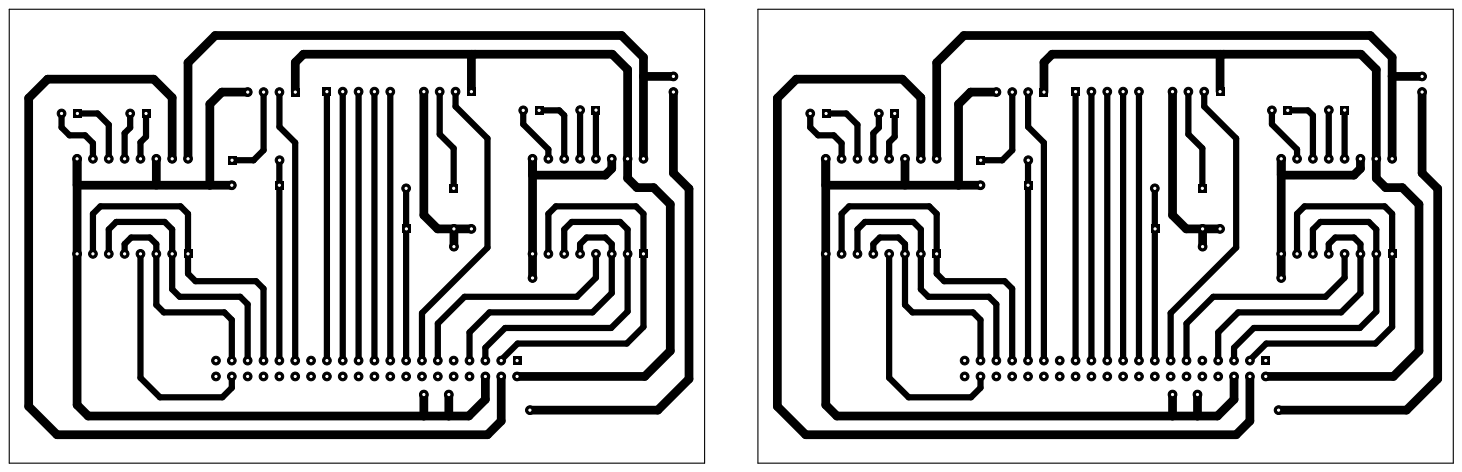
[picture p88: page 1]
