tomyrese/DATN/pdf_lam_mach/05_PANEL_2X_A4_B_Cu_DIRECT_In_Film.pdf

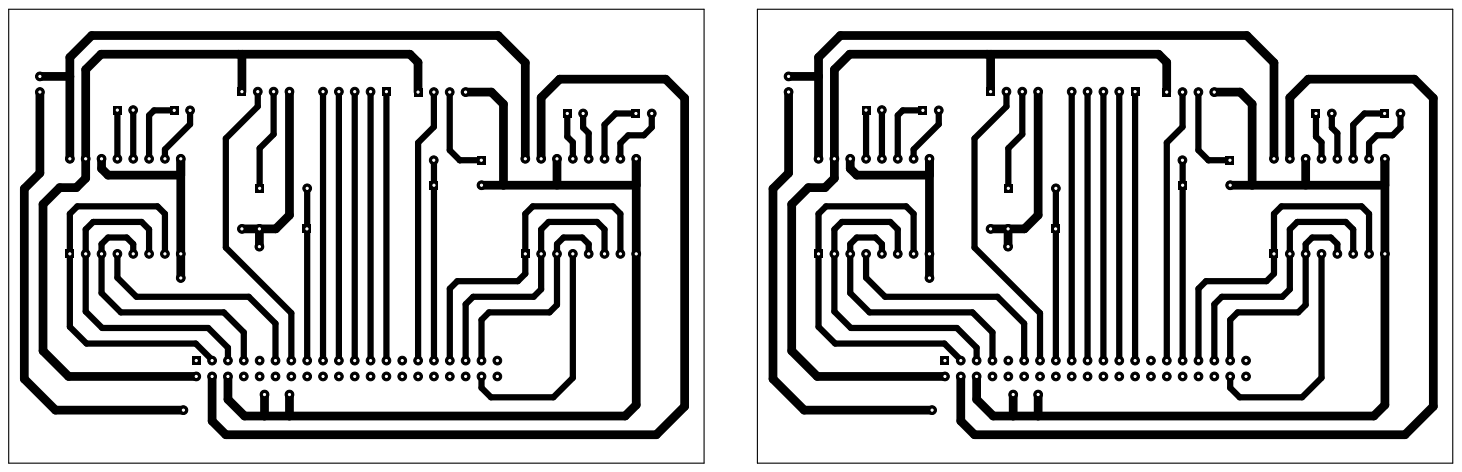
[picture p89: page 1]
