tomyrese/DATN/pdf_lam_mach/06_Don_1X_Mach_Day_B_Cu_MIRROR_Ui_Nhiet.pdf

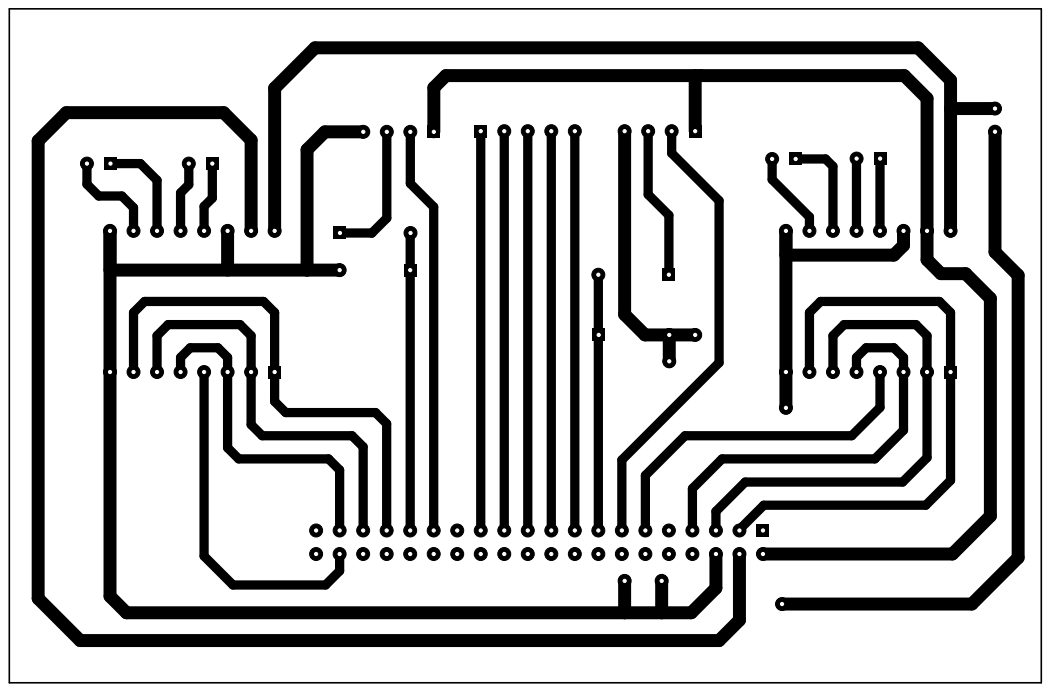
[picture p90: page 1]
