tomyrese/DATN/pdf_lam_mach/07_Don_1X_Mach_Day_B_Cu_DIRECT_In_Film.pdf

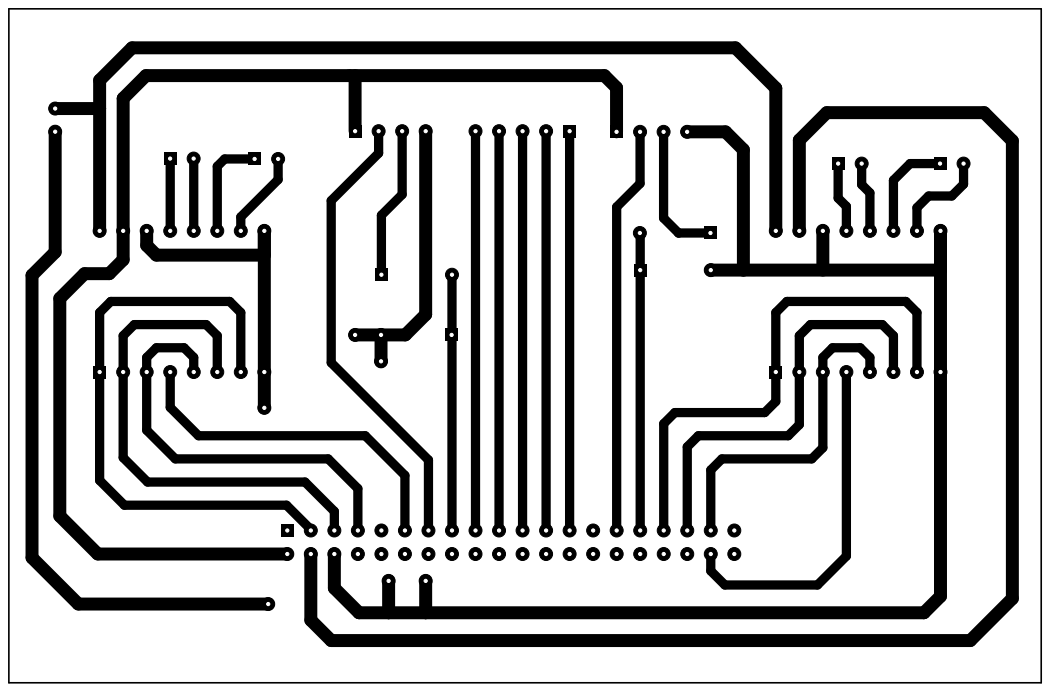
[picture p91: page 1]
