tomyrese/DATN/pdf_lam_mach/08_Don_1X_Mat_Tren_F_Silkscreen.pdf

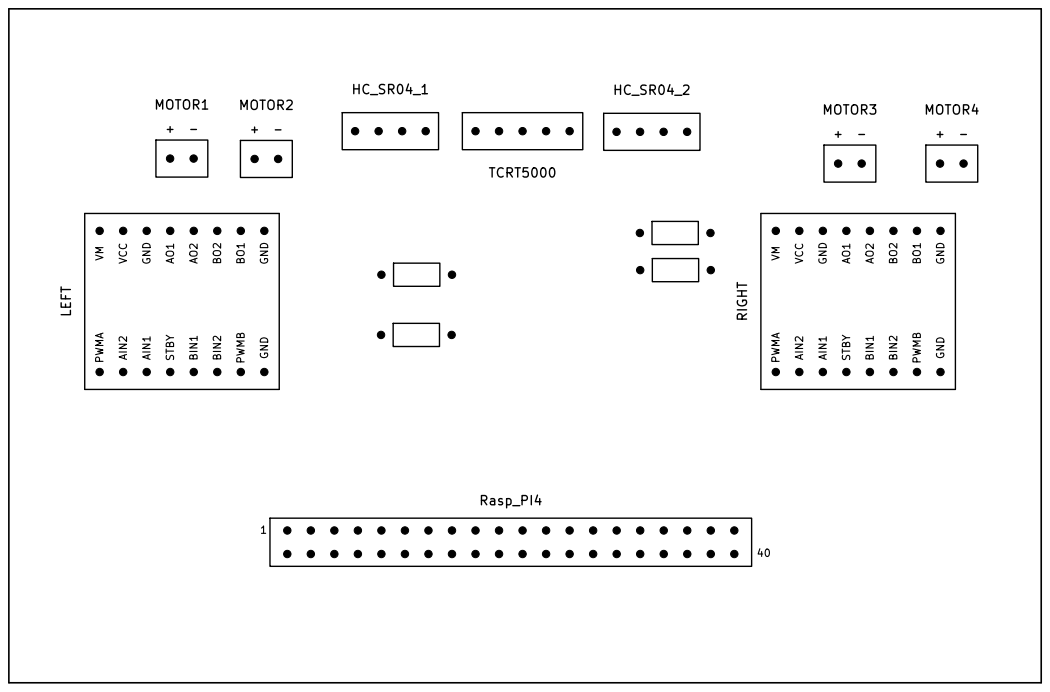
[picture p92: page 1]
