tomyrese/DATN/pdf_lam_mach/09_Don_1X_Huong_Dan_Lap_Rap_Mau.pdf

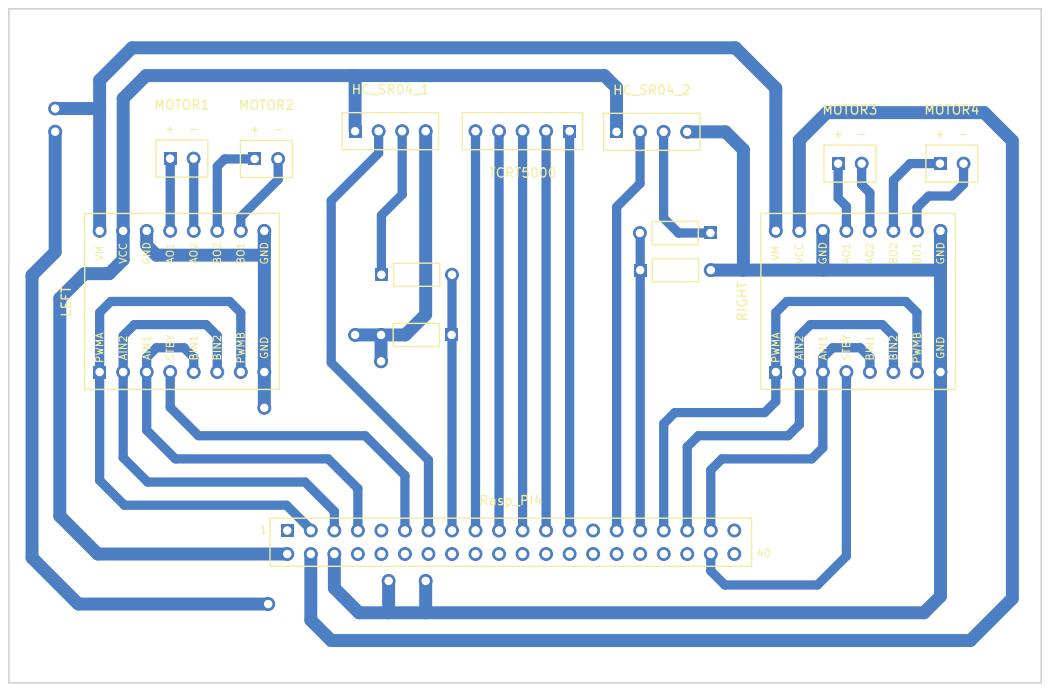
[picture p93: page 1]
