tomyrese/DATN/pdf_lam_mach/00_Bo_Tai_Lieu_Lam_Mach_Day_Du.pdf

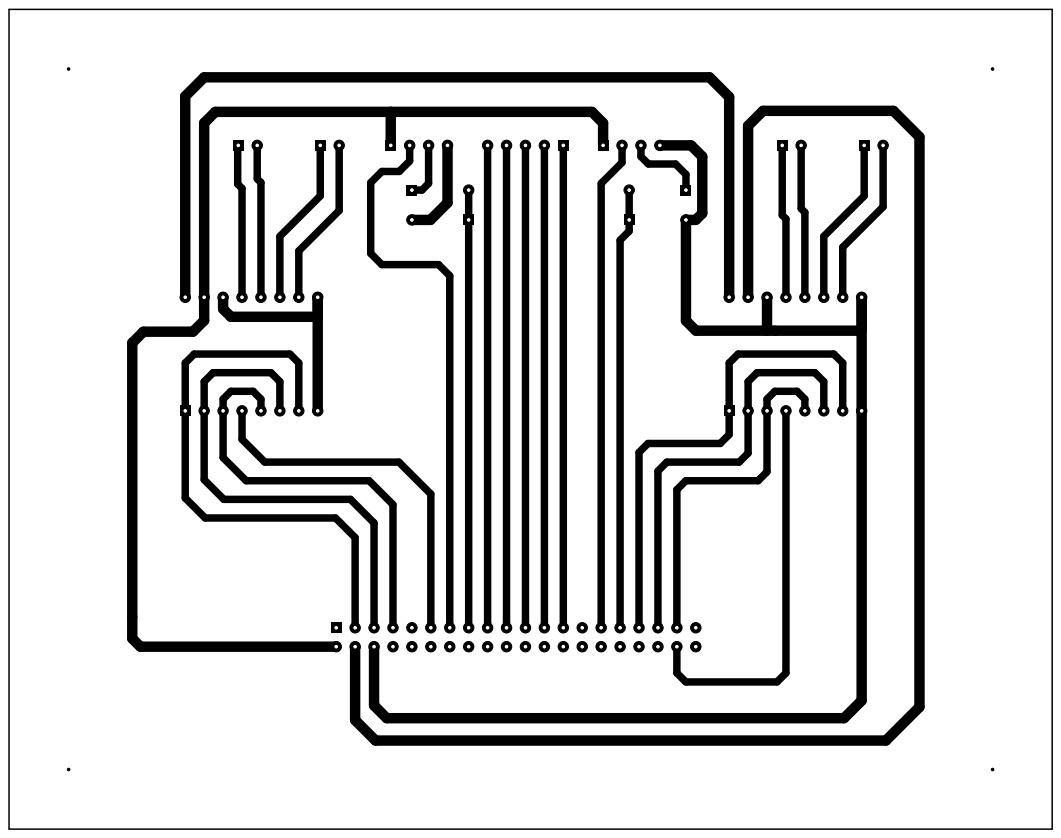
[picture p94: page 1]

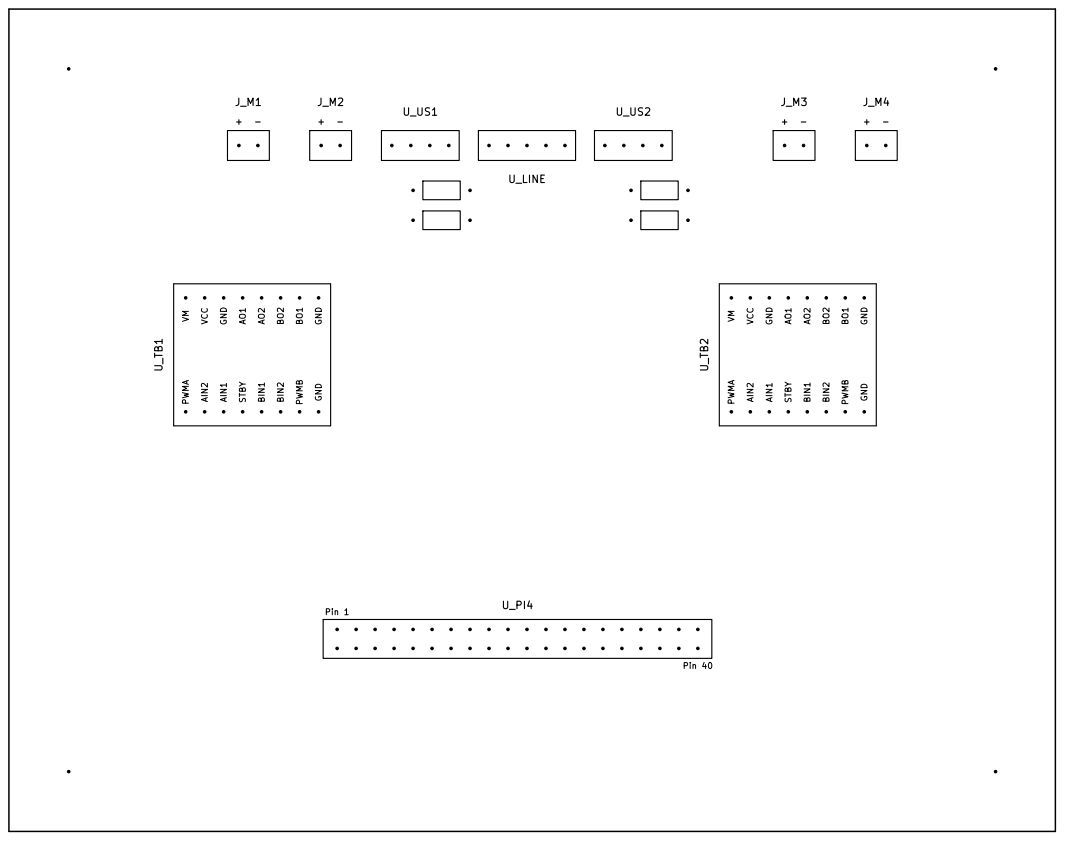
[picture p95: page 2]
