tomyrese/DATN/pdf_lam_mach/01_Mach_In_Day_B_Cu_MIRROR_Ui_Nhiet.pdf

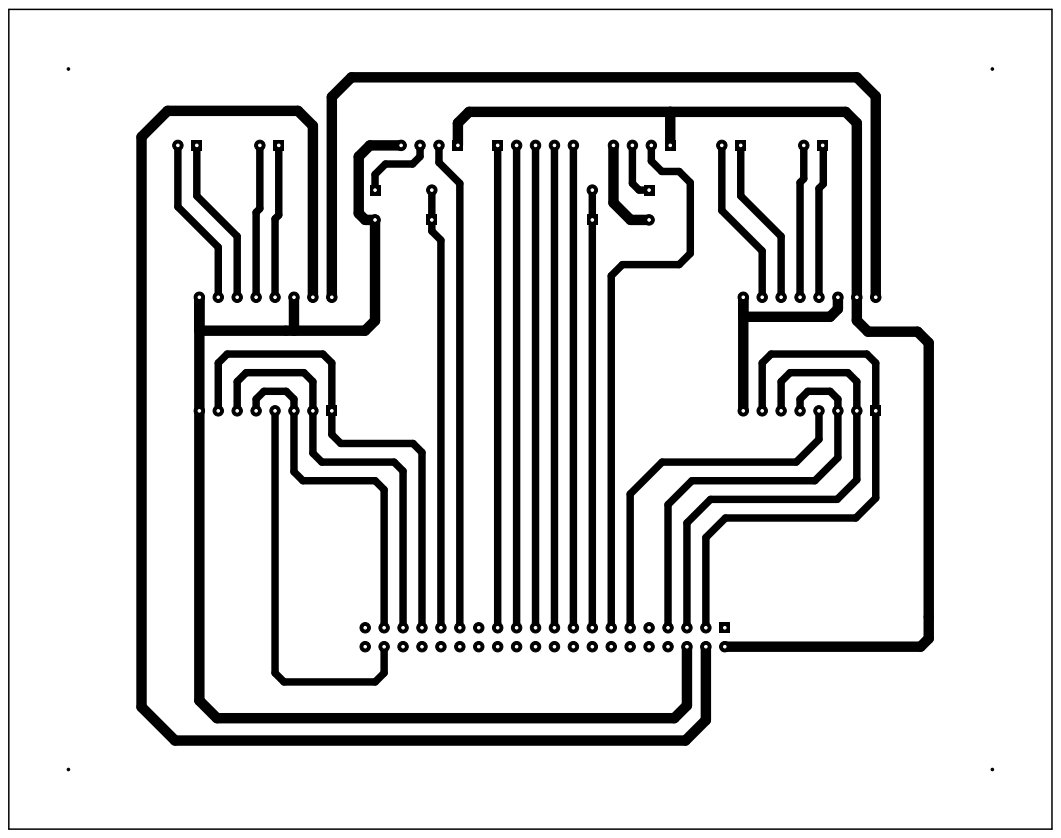
[picture p96: page 1]
