tomyrese/DATN/pdf_lam_mach/03_Mat_Tren_Linh_Kien_F_Silkscreen.pdf

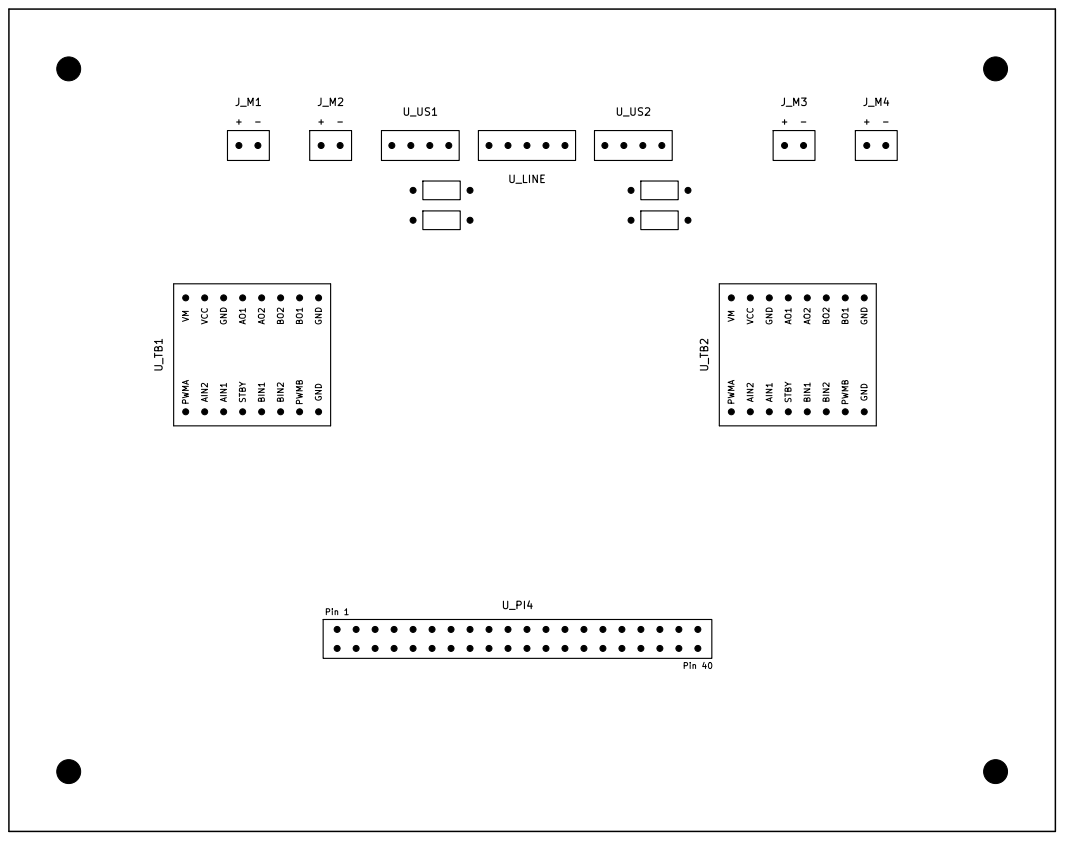
[picture p97: page 1]
