tomyrese/DATN/pdf_lam_mach/04_Huong_Dan_Lap_Rap_Mau.pdf

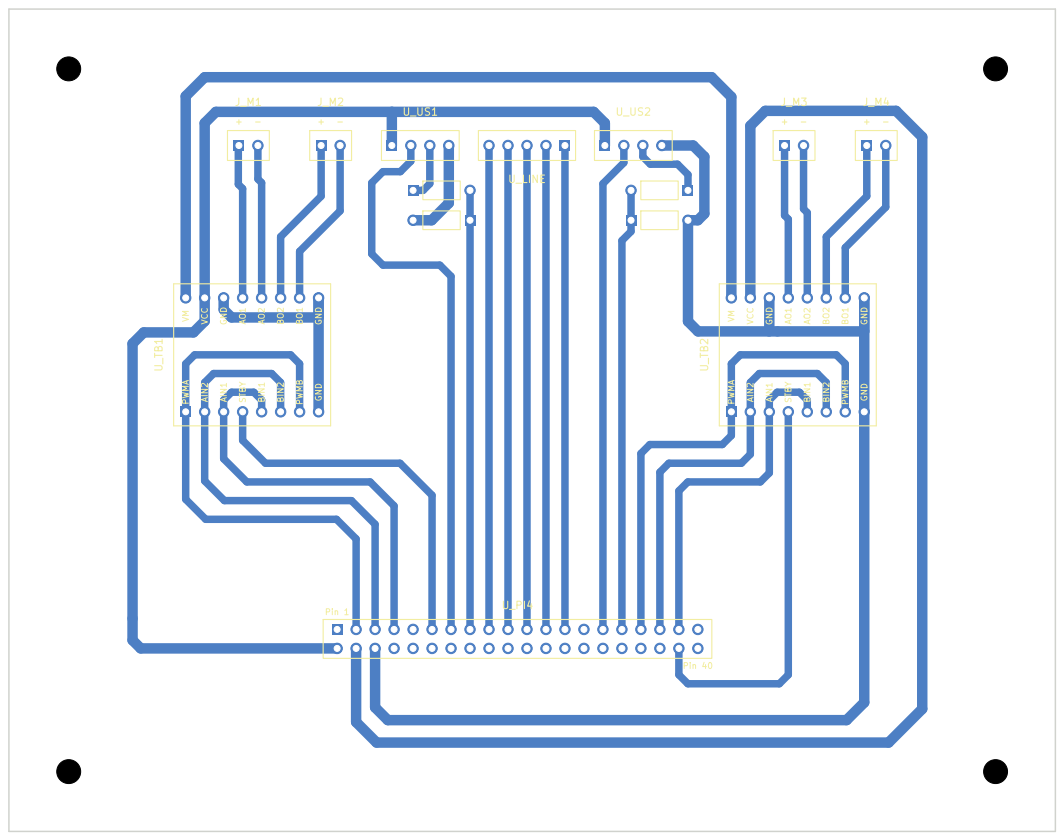
[picture p98: page 1]
