tomyrese/DATN/robot_electronics.kicad_pcb

## KiCad design robot_electronics.kicad_pcb (2026-11-04)

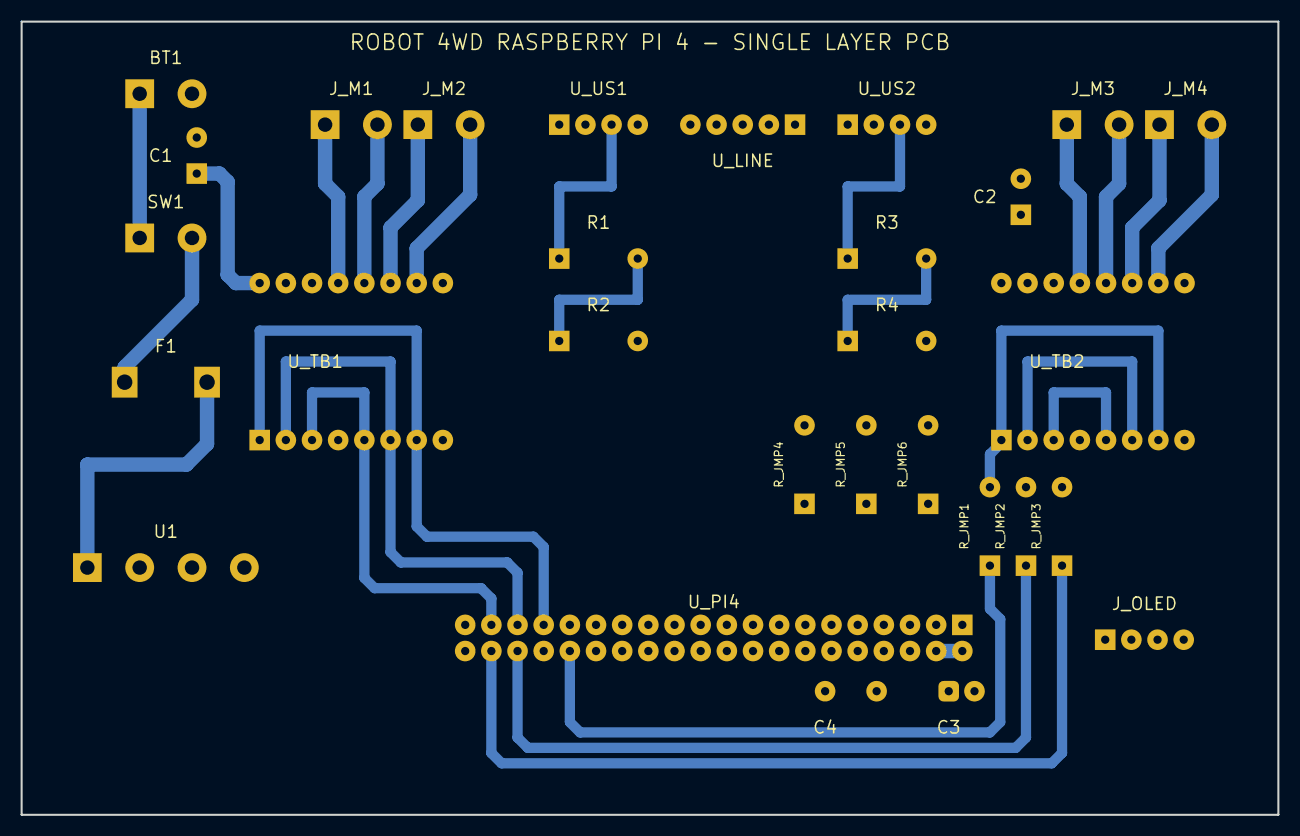
[picture p99: board robot_electronics.kicad_pcb from above]

Board: 2 copper layers, 122.0 x 77.0 mm, 29 parts (0 on the bottom side), 34 nets.

Parts:
BT1: BATT_12V; TerminalBlock_Phoenix_MKDS-1,5-2-5.08
C1: C1; CP_Radial_D8.0mm_P3.50mm
C2: C2; CP_Radial_D8.0mm_P3.50mm
C3: C3; CP_Radial_D6.3mm_P2.50mm
C4: C4; C_Disc_D5.0mm_W2.5mm_P5.00mm
F1: FUSE_7.5A; Fuseholder_Blade_Mini_Keystone_3568
J_M1: M1_FL; TerminalBlock_Phoenix_MKDS-1,5-2-5.08
J_M2: M2_RL; TerminalBlock_Phoenix_MKDS-1,5-2-5.08
J_M3: M3_FR; TerminalBlock_Phoenix_MKDS-1,5-2-5.08
J_M4: M4_RR; TerminalBlock_Phoenix_MKDS-1,5-2-5.08
J_OLED: OLED; Sensor_OLED_1.3
R1: R1; R_Axial_DIN0207_L6.3mm_D2.5mm_P7.62mm_Horizontal
R2: R2; R_Axial_DIN0207_L6.3mm_D2.5mm_P7.62mm_Horizontal
R3: R3; R_Axial_DIN0207_L6.3mm_D2.5mm_P7.62mm_Horizontal
R4: R4; R_Axial_DIN0207_L6.3mm_D2.5mm_P7.62mm_Horizontal
R_JMP1: J1 (0R); R_Axial_DIN0207_L6.3mm_D2.5mm_P7.62mm_Horizontal
R_JMP2: J2 (0R); R_Axial_DIN0207_L6.3mm_D2.5mm_P7.62mm_Horizontal
R_JMP3: J3 (0R); R_Axial_DIN0207_L6.3mm_D2.5mm_P7.62mm_Horizontal
R_JMP4: J4 (0R); R_Axial_DIN0207_L6.3mm_D2.5mm_P7.62mm_Horizontal
R_JMP5: J5 (0R); R_Axial_DIN0207_L6.3mm_D2.5mm_P7.62mm_Horizontal
R_JMP6: J6 (0R); R_Axial_DIN0207_L6.3mm_D2.5mm_P7.62mm_Horizontal
SW1: SW_MAIN; TerminalBlock_Phoenix_MKDS-1,5-2-5.08
U1: XL4015_5V; TerminalBlock_Phoenix_MKDS-1,5-4-5.08
U_LINE: LINE_3CH; Sensor_Line_TCRT5000_3CH
U_PI4: Rasp_PI4; PinSocket_2x20_P2.54mm_Vertical
U_TB1: TB6612_L; Module_TB6612FNG_Breakout
U_TB2: TB6612_R; Module_TB6612FNG_Breakout
U_US1: US1_LEFT; Sensor_HC_SR04
U_US2: US2_RIGHT; Sensor_HC_SR04

Connections:
/+3V3_LOGIC: J_OLED.1, R_JMP5.1, R_JMP5.2, U_LINE.5, U_PI4.1, U_TB1.4, U_TB1.10, U_TB2.4, U_TB2.10
/+5V_PWR: C3.1, C4.1, R_JMP4.1, R_JMP4.2, U1.3, U_PI4.2, U_PI4.4, U_US1.1, U_US2.1
/AIN1_L: U_PI4.37, U_TB1.3, U_TB1.5
/AIN1_R: R_JMP2.2, U_TB2.3, U_TB2.5
/AIN2_L: U_PI4.35, U_TB1.2, U_TB1.6
/AIN2_R: R_JMP3.2, U_TB2.2, U_TB2.6
/BAT+: BT1.1, SW1.1
/ECHO_L: R1.2, R2.1, U_PI4.13
/ECHO_R: R3.2, R4.1, U_PI4.18
/FUSE_IN: F1.1, SW1.2
/GND: BT1.2, C1.2, C2.2, C3.2, C4.2, J_OLED.2, R2.2, R4.2, R_JMP6.1, R_JMP6.2, U1.2, U1.4, U_LINE.1, U_PI4.6, U_PI4.9, U_PI4.14, U_PI4.20, U_PI4.25, U_PI4.30, U_PI4.34, U_PI4.39, U_TB1.8, U_TB1.11, U_TB1.16, U_TB2.8, U_TB2.11, U_TB2.16, U_US1.4, U_US2.4
/I2C_SCL: J_OLED.3, U_PI4.5
/I2C_SDA: J_OLED.4, U_PI4.3
/LINE_C: U_LINE.3, U_PI4.21
/LINE_L: U_LINE.4, U_PI4.19
/LINE_R: U_LINE.2, U_PI4.23
/M1_A: J_M1.1, U_TB1.12
/M1_B: J_M1.2, U_TB1.13
/M2_A: J_M2.2, U_TB1.15
/M2_B: J_M2.1, U_TB1.14
/M3_A: J_M3.1, U_TB2.12
/M3_B: J_M3.2, U_TB2.13
/M4_A: J_M4.2, U_TB2.15
/M4_B: J_M4.1, U_TB2.14
/PWMA_L: U_PI4.33, U_TB1.1, U_TB1.7
/PWMA_R: R_JMP1.2, U_TB2.1, U_TB2.7
/TRIG_L: U_PI4.11, U_US1.2
/TRIG_R: U_PI4.16, U_US2.2
/VM_MOTOR: C1.1, C2.1, F1.2, U1.1, U_TB1.9, U_TB2.9
unnamed: R_JMP1.1, U_PI4.32
unnamed: R_JMP2.1, U_PI4.36
unnamed: R_JMP3.1, U_PI4.38
unnamed: R1.1, U_US1.3
unnamed: R3.1, U_US2.3
