tomyrese/DATN/Pi4_Robot_Carrier_1Layer.kicad_pcb

## KiCad design Pi4_Robot_Carrier_1Layer.kicad_pcb (2026-11-03)

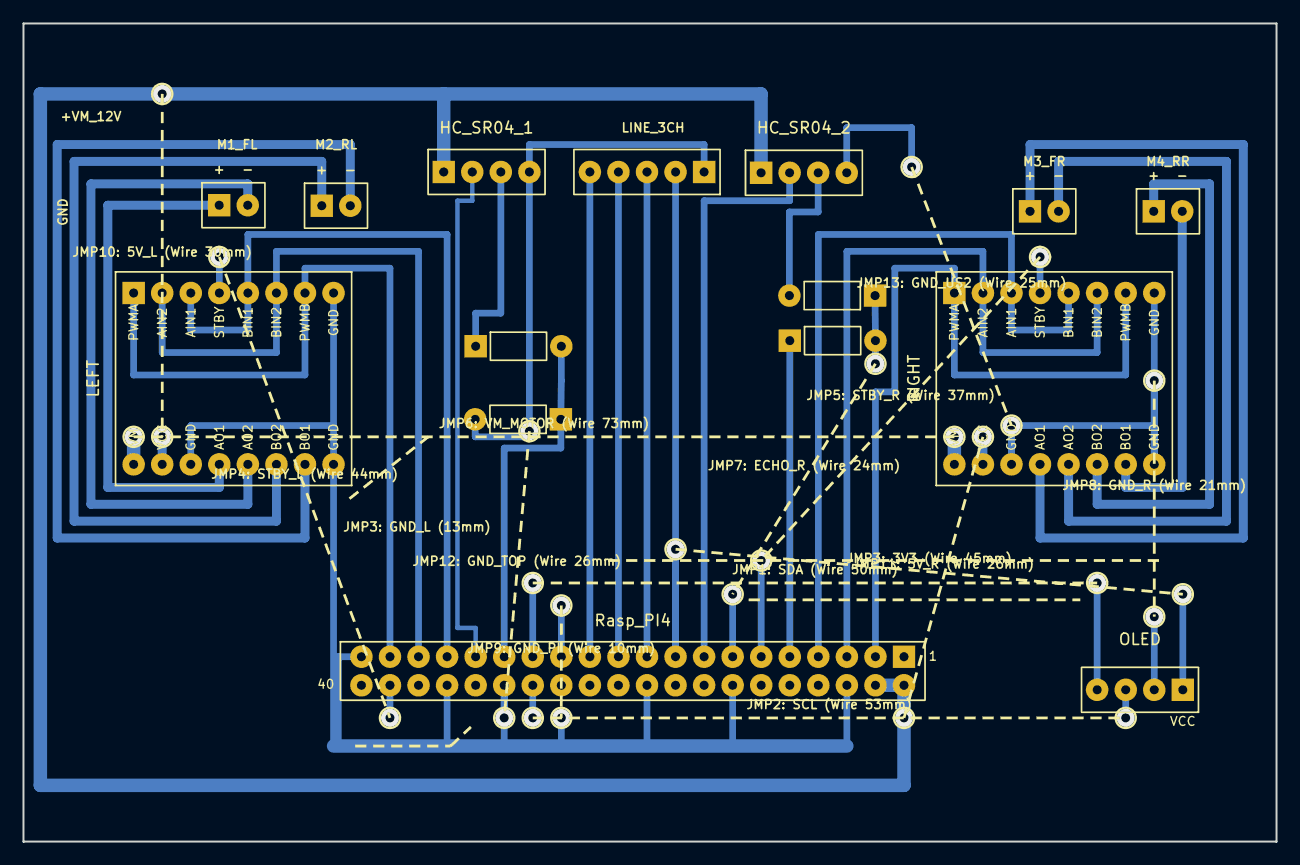
[picture p100: board Pi4_Robot_Carrier_1Layer.kicad_pcb from above]

Board: 2 copper layers, 111.5 x 72.8 mm, 15 parts (0 on the bottom side), 31 nets.

Parts:
HC_SR04_1: HC_SR04_Left; Sensor_HC_SR04
HC_SR04_2: HC_SR04_Right; Sensor_HC_SR04
LEFT: TB6612_Left; Module_TB6612FNG_Breakout
MOTOR1: MOTOR_FL; TerminalBlock_Phoenix_MKDS-1,5-2-5.08
MOTOR2: MOTOR_RL; TerminalBlock_Phoenix_MKDS-1,5-2-5.08
MOTOR3: MOTOR_FR; TerminalBlock_Phoenix_MKDS-1,5-2-5.08
MOTOR4: MOTOR_RR; TerminalBlock_Phoenix_MKDS-1,5-2-5.08
OLED: OLED_1.3_I2C; Sensor_OLED_1.3
R1, R3: 1k; R_Axial_DIN0207_L6.3mm_D2.5mm_P7.62mm_Horizontal
R2, R4: 2k; R_Axial_DIN0207_L6.3mm_D2.5mm_P7.62mm_Horizontal
RIGHT: TB6612_Right; Module_TB6612FNG_Breakout
Rasp_PI4: Raspberry_Pi_4_40Pin; PinSocket_2x20_P2.54mm_Vertical
TCRT5000: TCRT5000_3CH; Sensor_Line_TCRT5000_3CH

Connections:
/+3V3_LOGIC: OLED.1, Rasp_PI4.17, TCRT5000.2
/+5V_PWR: HC_SR04_1.1, HC_SR04_2.1, LEFT.10, RIGHT.10, Rasp_PI4.2, Rasp_PI4.4
/AIN1_L: LEFT.3, LEFT.5, Rasp_PI4.33
/AIN1_R: RIGHT.3, RIGHT.5, Rasp_PI4.7
/AIN2_L: LEFT.2, LEFT.6, Rasp_PI4.35
/AIN2_R: RIGHT.2, RIGHT.6, Rasp_PI4.5
/ECHO_L: R1.2, R2.1, Rasp_PI4.29
/ECHO_R: R3.1, R4.2, Rasp_PI4.13
/I2C_SCL: OLED.3, Rasp_PI4.28
/I2C_SDA: OLED.4, Rasp_PI4.27
/LINE_C: Rasp_PI4.21, TCRT5000.4
/LINE_L: Rasp_PI4.19, TCRT5000.3
/LINE_R: Rasp_PI4.23, TCRT5000.5
/M1_A: LEFT.12, MOTOR1.1
/M1_B: LEFT.13, MOTOR1.2
/M2_A: LEFT.15, MOTOR2.2
/M2_B: LEFT.14, MOTOR2.1
/M3_A: MOTOR3.1, RIGHT.12
/M3_B: MOTOR3.2, RIGHT.13
/M4_A: MOTOR4.2, RIGHT.15
/M4_B: MOTOR4.1, RIGHT.14
/PWMA_L: LEFT.1, LEFT.7, Rasp_PI4.37
/PWMA_R: RIGHT.1, RIGHT.7, Rasp_PI4.3
/STBY_L: LEFT.4, Rasp_PI4.38
/STBY_R: RIGHT.4, Rasp_PI4.11
/TRIG_L: HC_SR04_1.2, Rasp_PI4.31
/TRIG_R: HC_SR04_2.2, Rasp_PI4.15
/VM_MOTOR: LEFT.9, RIGHT.9
GND: HC_SR04_1.4, HC_SR04_2.4, LEFT.8, LEFT.11, LEFT.16, OLED.2, R2.2, R4.1, RIGHT.8, RIGHT.11, RIGHT.16, Rasp_PI4.6, Rasp_PI4.9, Rasp_PI4.14, Rasp_PI4.20, Rasp_PI4.25, Rasp_PI4.30, Rasp_PI4.34, Rasp_PI4.39, TCRT5000.1
unnamed: HC_SR04_1.3, R1.1
unnamed: HC_SR04_2.3, R3.2
