tomyrese/DATN/scripts/check_motor_pos.py

# Check positions of all components related to motor driver LEFT and RIGHT
# TB6612 LEFT: at (67.69, 68.8275)
# TB6612 RIGHT: at (140.69, 68.8275)
# MOTOR1 (M1): (67.68, 53.40)
# MOTOR2 (M2): (76.80, 53.44)
# MOTOR3 (M3): (139.80, 53.94)
# MOTOR4 (M4): (150.80, 53.94)

print("Motors above LEFT driver:")
print("MOTOR1: (67.68, 53.40)")
print("MOTOR2: (76.80, 53.44)")
print("\nMotors above RIGHT driver:")
print("MOTOR3: (139.80, 53.94)")
print("MOTOR4: (150.80, 53.94)")
