tomyrese/DATN/scripts/build_true_1layer.py

import re

# Read original user PCB
with open('robot_electronics.kicad_pcb.user_backup', 'r', encoding='utf-8') as f:
    text = f.read()

# 1. Clean up redundant vias from user's manual experimentation:
# Remove via at (89.18 75.291806)
text = re.sub(r'\t\(via\s+\(at 89\.18 75\.291806\)[\s\S]*?\n\t\)\n', '', text)
# Remove segment (start 89.18 75.291806) (end 89.175489 75.296317)
text = re.sub(r'\t\(segment\s+\(start 89\.18 75\.291806\)[\s\S]*?\n\t\)\n', '', text)
# Remove micro stub from (89.18 72.4425) to (89.18 75.291806)
text = re.sub(r'\t\(segment\s+\(start 89\.18 72\.4425\)[\s\S]*?\(end 89\.18 75\.291806\)[\s\S]*?\n\t\)\n', '', text)

# Remove via at (94 99)
text = re.sub(r'\t\(via\s+\(at 94 99\)[\s\S]*?\n\t\)\n', '', text)
# Remove segment (start 94 102.4425) (end 94 99)
text = re.sub(r'\t\(segment\s+\(start 94 102\.4425\)[\s\S]*?\(end 94 99\)[\s\S]*?\n\t\)\n', '', text)

# 2. Add Jumper Vias on the board (drill 0.8, size 1.6 for comfortable DIY soldering):
new_vias = """\t(via
\t\t(at 112.08 88.5)
\t\t(size 1.6)
\t\t(drill 0.8)
\t\t(layers "F.Cu" "B.Cu")
\t\t(net "/I2C_SDA")
\t\t(uuid "f0e1d2c3-1001-4000-8000-000000000001")
\t)
\t(via
\t\t(at 144.5 88.5)
\t\t(size 1.6)
\t\t(drill 0.8)
\t\t(layers "F.Cu" "B.Cu")
\t\t(net "/I2C_SDA")
\t\t(uuid "f0e1d2c3-1002-4000-8000-000000000002")
\t)
\t(via
\t\t(at 99.38 85.0)
\t\t(size 1.6)
\t\t(drill 0.8)
\t\t(layers "F.Cu" "B.Cu")
\t\t(net "/+3V3_LOGIC")
\t\t(uuid "f0e1d2c3-2001-4000-8000-000000000001")
\t)
\t(via
\t\t(at 152.12 85.0)
\t\t(size 1.6)
\t\t(drill 0.8)
\t\t(layers "F.Cu" "B.Cu")
\t\t(net "/+3V3_LOGIC")
\t\t(uuid "f0e1d2c3-2002-4000-8000-000000000002")
\t)
\t(via
\t\t(at 54.0 63.5)
\t\t(size 1.6)
\t\t(drill 0.8)
\t\t(layers "F.Cu" "B.Cu")
\t\t(net "GND")
\t\t(uuid "f0e1d2c3-3001-4000-8000-000000000001")
\t)
\t(via
\t\t(at 63.88 62.7795)
\t\t(size 1.6)
\t\t(drill 0.8)
\t\t(layers "F.Cu" "B.Cu")
\t\t(net "GND")
\t\t(uuid "f0e1d2c3-3002-4000-8000-000000000002")
\t)\n"""

# 3. Add B.Cu copper tracks (100% on B.Cu, ZERO ON F.Cu!):
new_bcu_tracks = """\t(segment
\t\t(start 112.08 93.5575)
\t\t(end 112.08 88.5)
\t\t(width 1)
\t\t(layer "B.Cu")
\t\t(net "/I2C_SDA")
\t\t(uuid "f0e1d2c3-1003-4000-8000-000000000003")
\t)
\t(segment
\t\t(start 144.5 88.5)
\t\t(end 144.5 96.5)
\t\t(width 1)
\t\t(layer "B.Cu")
\t\t(net "/I2C_SDA")
\t\t(uuid "f0e1d2c3-1004-4000-8000-000000000004")
\t)
\t(segment
\t\t(start 152.12 85.0)
\t\t(end 152.12 96.5)
\t\t(width 1)
\t\t(layer "B.Cu")
\t\t(net "/+3V3_LOGIC")
\t\t(uuid "f0e1d2c3-2003-4000-8000-000000000003")
\t)\n"""

# 4. Comprehensive Silkscreen Annotations & Jumper Guides on F.SilkS:
# We draw silkscreen lines connecting the vias and text labels!
silkscreen_annotations = """\t(gr_line
\t\t(start 112.08 88.5)
\t\t(end 144.5 88.5)
\t\t(stroke
\t\t\t(width 0.25)
\t\t\t(type dash)
\t\t)
\t\t(layer "F.SilkS")
\t\t(uuid "f0e1d2c3-5001-4000-8000-000000000001")
\t)
\t(gr_circle
\t\t(center 112.08 88.5)
\t\t(end 113.2 88.5)
\t\t(stroke
\t\t\t(width 0.2)
\t\t\t(type default)
\t\t)
\t\t(fill none)
\t\t(layer "F.SilkS")
\t\t(uuid "f0e1d2c3-5002-4000-8000-000000000002")
\t)
\t(gr_circle
\t\t(center 144.5 88.5)
\t\t(end 145.6 88.5)
\t\t(stroke
\t\t\t(width 0.2)
\t\t\t(type default)
\t\t)
\t\t(fill none)
\t\t(layer "F.SilkS")
\t\t(uuid "f0e1d2c3-5003-4000-8000-000000000003")
\t)
\t(gr_text "JMP1: SDA (Wire 32mm)"
\t\t(at 128.0 89.8)
\t\t(layer "F.SilkS")
\t\t(uuid "f0e1d2c3-5004-4000-8000-000000000004")
\t\t(effects
\t\t\t(font
\t\t\t\t(size 0.8 0.8)
\t\t\t\t(thickness 0.15)
\t\t\t)
\t\t)
\t)
\t(gr_line
\t\t(start 99.38 85.0)
\t\t(end 152.12 85.0)
\t\t(stroke
\t\t\t(width 0.25)
\t\t\t(type dash)
\t\t)
\t\t(layer "F.SilkS")
\t\t(uuid "f0e1d2c3-5011-4000-8000-000000000011")
\t)
\t(gr_circle
\t\t(center 99.38 85.0)
\t\t(end 100.5 85.0)
\t\t(stroke
\t\t\t(width 0.2)
\t\t\t(type default)
\t\t)
\t\t(fill none)
\t\t(layer "F.SilkS")
\t\t(uuid "f0e1d2c3-5012-4000-8000-000000000012")
\t)
\t(gr_circle
\t\t(center 152.12 85.0)
\t\t(end 153.2 85.0)
\t\t(stroke
\t\t\t(width 0.2)
\t\t\t(type default)
\t\t)
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

with open('robot_electronics.kicad_pcb', 'w', encoding='utf-8') as f:
    f.write(text)

with open('Pi4_Robot_Carrier_1Layer.kicad_pcb', 'w', encoding='utf-8') as f:
    f.write(text)

print("Saved robot_electronics.kicad_pcb and Pi4_Robot_Carrier_1Layer.kicad_pcb successfully!")
