tomyrese/DATN/(commit log)

2026-10-30 feat: complete Raspberry Pi 4 Robot 4WD Carrier 1-Layer PCB and Python/Web controller suite
2026-10-30 sync: update schematic and pcb component names and net assignments
2026-10-30 sync: track robot_electronics.kicad_sch
2026-10-30 feat: re-route 5V rails into +5V_PI_1 (sensors, U_TB1) and +5V_PI_2 (U_TB2) with 0 DRC
2026-10-30 docs: add complete PDF fabrication and etching package for DIY PCB
2026-10-30 sync: restore user-edited PCB layout and regenerate production PDFs
2026-10-30 feat(pcb): compact board layout to 124x86mm and export A4 multi-board panel 4x & 2x
2026-10-30 feat(pcb): update PCB dimensions to 111.6x72.9mm and export all A4 panels and PDFs
2026-11-03 feat: complete ultrasonic sensor test, corridor map navigation, website UI & project deliverables
2026-11-03 feat(robot): add Robot4WD dual driver controller and auto_drive obstacle avoidance system
2026-11-03 fix(motor): cap nhat driver banh phai, bo sung fallback digital va scripts test chẩn đoán
2026-11-03 fix(hardware): danh gia va sua toan bo loi nguon 5V, mass loop, T-junction va dong bo schematic-pcb
2026-11-03 fix(pcb): redesign 1-layer planar routing with TB6612 row swap and Pi4 horizontal mirror
    - Swapped TB6612 module breakout rows: Row 1 (PWMA..GND), Row 2 (VM..GND)
    - Mirrored Raspberry Pi 4 40-pin header horizontally (Pin 1<->39, Pin 2<->40, Pin 3<->37, Pin 4<->38...)
    - Rerouted single-layer B.Cu traces with 0 copper intersections, 0 clearance violations, 0 dangling tracks
    - Configured 13 top-side wire jumpers with silkscreen dashed lines and PTH vias
    - Eliminated mass/ground loops with unified star trunk topology along Y=101.50mm
    - Updated code/python/config.py with exact BCM GPIO pin mappings
    - Regenerated 2x and 4x A4 PCB fabrication panels and exported all fabrication PDFs
2026-11-04 feat(pcb): thiet ke lai mach 1 lop v20 theo quy tac moi (khong vuong goc, khong xuyen chan 2.54mm, nguon 1.4mm, tin hieu 1.0mm, via 2.0/0.8mm, clearance 0.5mm, 0 loi DRC copper)
2026-11-04 feat(hardware): hoan thien toan bo pcb 1 lop chuan cong nghiep - 0 via, 0 loi short/crossing, toi uu silkscreen
